hartswf0/centaur-walker/templates.pdf

# 0 Check and index

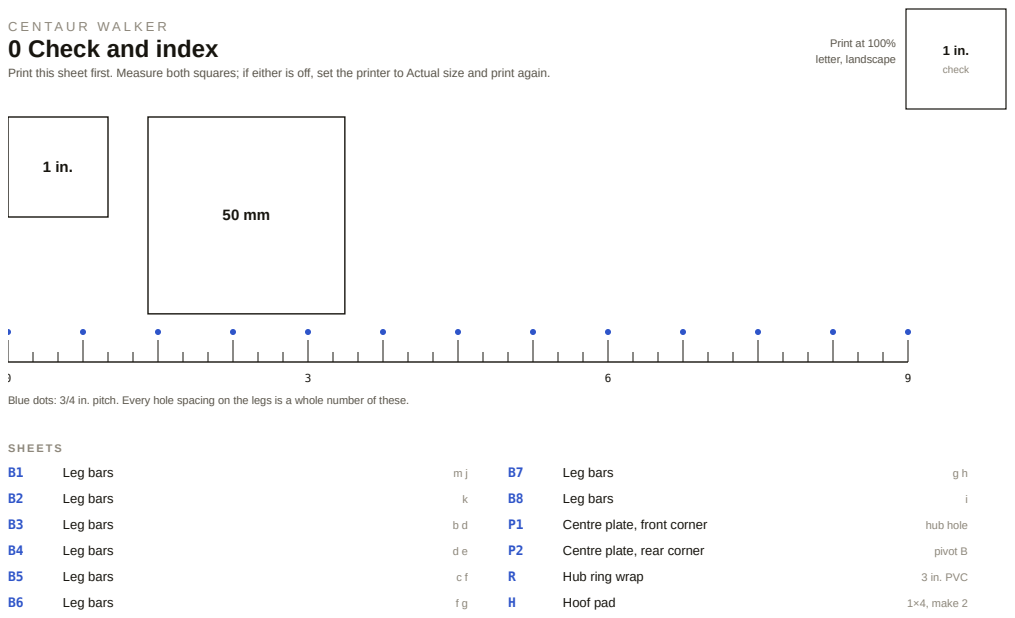
[picture p2: page 1]
check; Print at 100% letter, landscape; Leg bars; Centre plate, front corner; hub hole; Centre plate, rear corner; pivot B; Hub ring wrap; 3 in. PVC; Hoof pad; 1×4, make 2

Print this sheet first. Measure both squares; if either is off, set the printer to Actual size and print again.

Blue dots: 3/4 in. pitch. Every hole spacing on the legs is a whole number of these.

C E N TA U R W A L K E R

# B1 Leg bars

Tape each strip to a 1×2 so its long edges sit on the bar’s edges. Punch through each cross. Cut on the solid end lines.

1 in.

check

Print at 100%
letter, landscape

m Crank · cut 6-9/16 in. · holes 3-3/4 in. apart (95 mm) to C; hub holes 2-5/8 in. apart · make 2

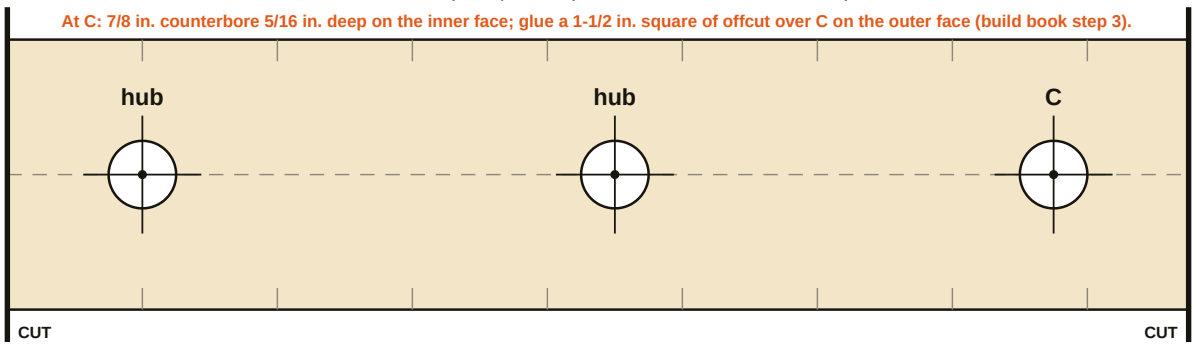
[picture p3: figure]
CUT; hub

At C: 7/8 in. counterbore 5/16 in. deep on the inner face; glue a 1-1/2 in. square of offcut over C on the outer face (build book step 3).

j Upper rod · cut 15 in. · holes 13-1/2 in. apart (343 mm) · make 2 | part 1 of 2

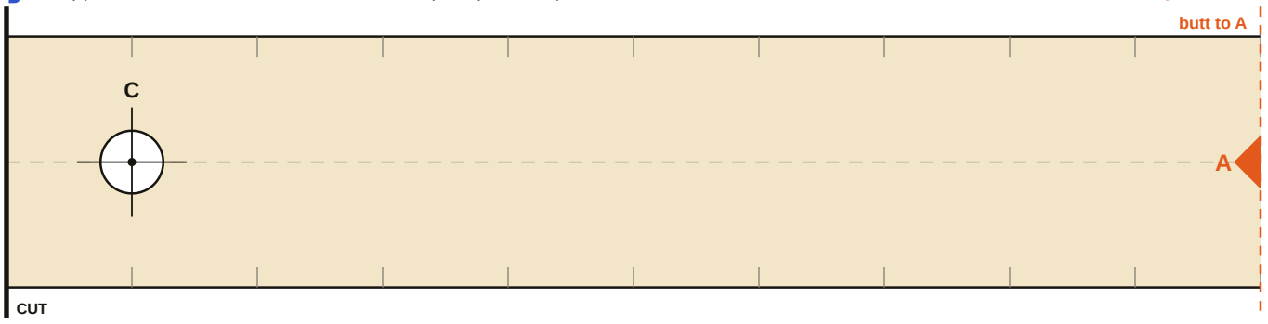
[picture p4: figure]
CUT; butt to A

j Upper rod · cut 15 in. · holes 13-1/2 in. apart (343 mm) · make 2 | part 2 of 2

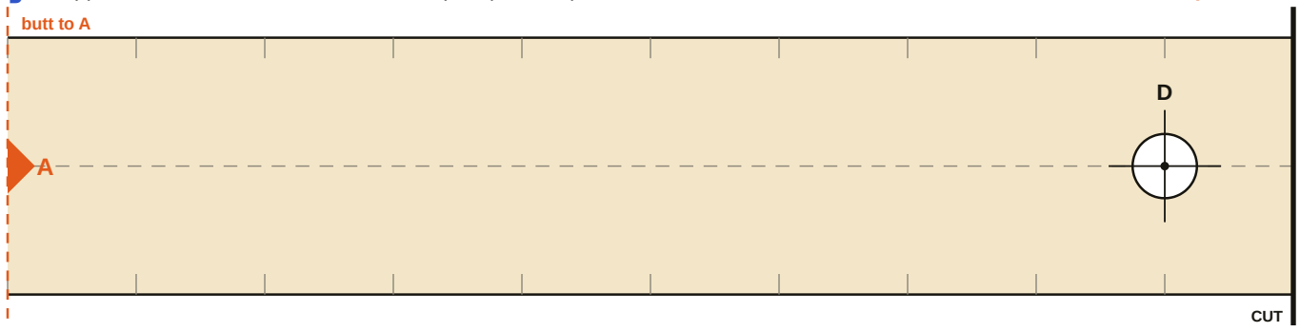
[picture p5: figure]
butt to A; CUT

C E N TA U R W A L K E R

# B2 Leg bars

Tape each strip to a 1×2 so its long edges sit on the bar’s edges. Punch through each cross. Cut on the solid end lines.

1 in.

check

Print at 100%
letter, landscape
k Lower rod · cut 22-1/2 in. · holes 21 in. apart (533 mm) · make 2 | part 1 of 3

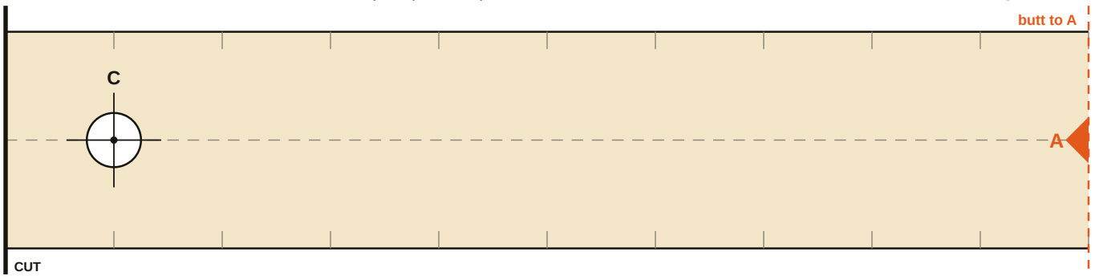
[picture p6: figure]
CUT; butt to A

k Lower rod · cut 22-1/2 in. · holes 21 in. apart (533 mm) · make 2 | part 2 of 3

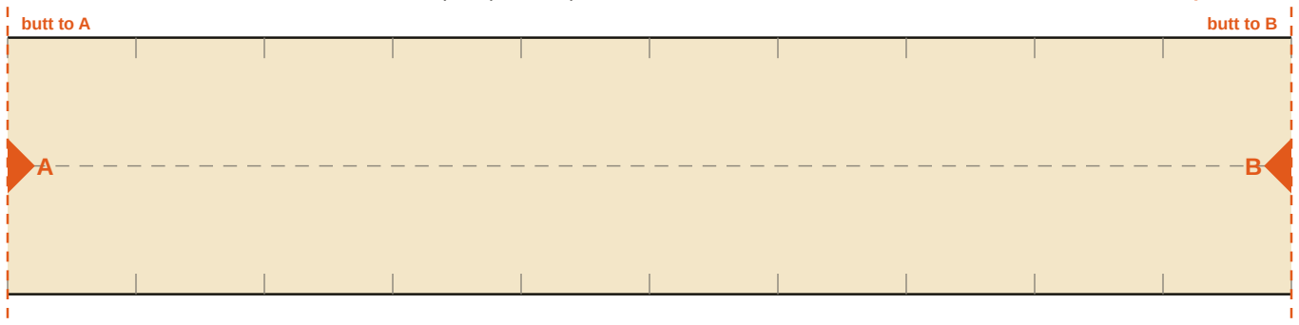
[picture p7: figure]
butt to A; butt to B

k Lower rod · cut 22-1/2 in. · holes 21 in. apart (533 mm) · make 2 | part 3 of 3

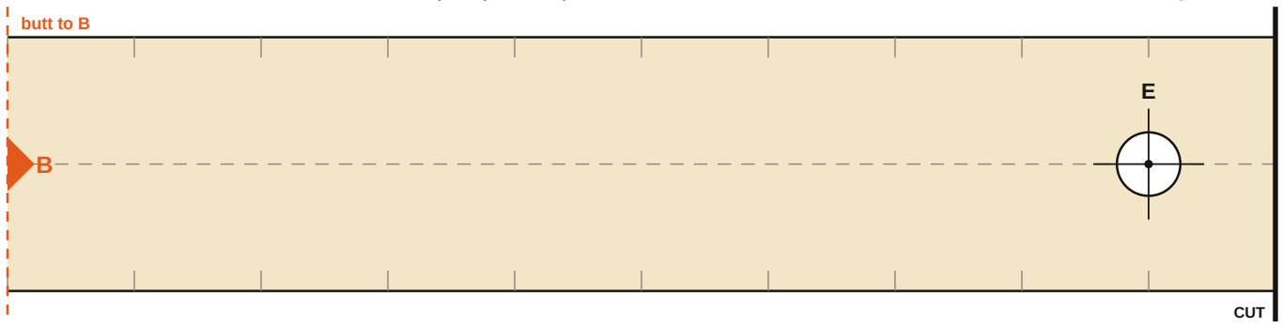
[picture p8: figure]
butt to B

C E N TA U R W A L K E R

# B3 Leg bars

Tape each strip to a 1×2 so its long edges sit on the bar’s edges. Punch through each cross. Cut on the solid end lines.

1 in.

check

Print at 100%
letter, landscape
b Hip bar, front · cut 11-1/4 in. · holes 9-3/4 in. apart (248 mm) · make 2 | part 1 of 2

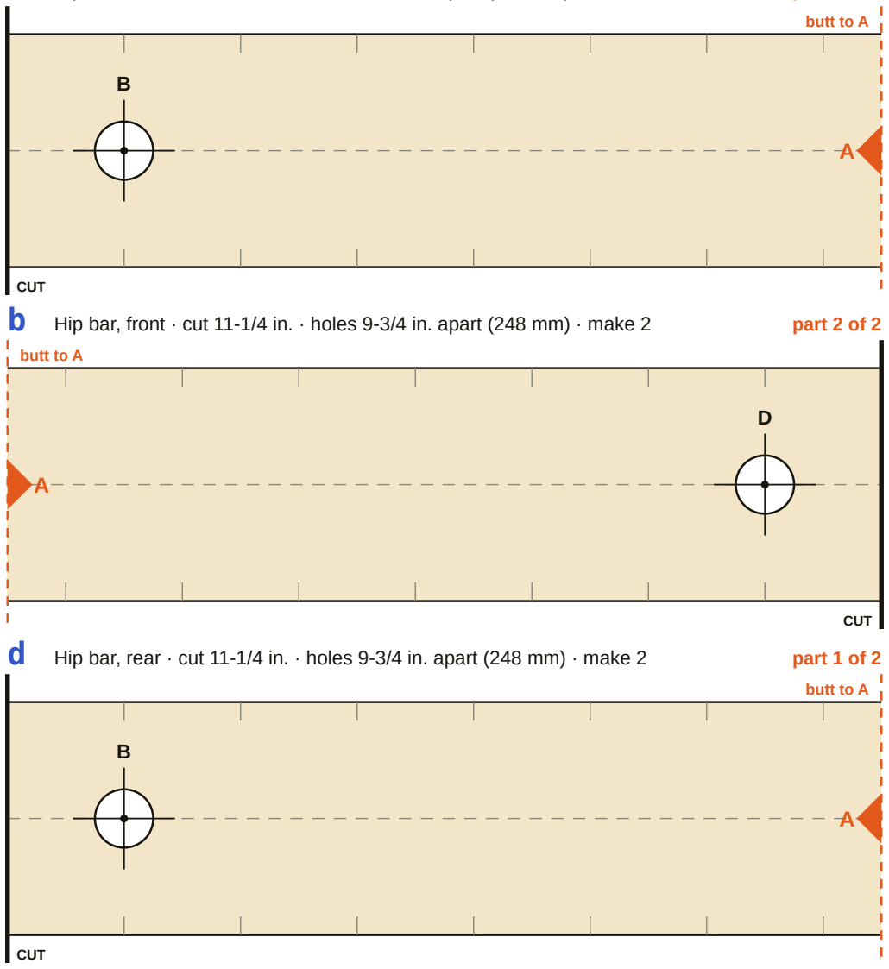
[picture p9: figure]
CUT; butt to A

b Hip bar, front · cut 11-1/4 in. · holes 9-3/4 in. apart (248 mm) · make 2 | part 2 of 2
d Hip bar, rear · cut 11-1/4 in. · holes 9-3/4 in. apart (248 mm) · make 2 | part 1 of 2

C E N TA U R W A L K E R

# B4 Leg bars

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

1 in.

check

Print at 100%
letter, landscape
d Hip bar, rear · cut 11-1/4 in. · holes 9-3/4 in. apart (248 mm) · make 2 | part 2 of 2

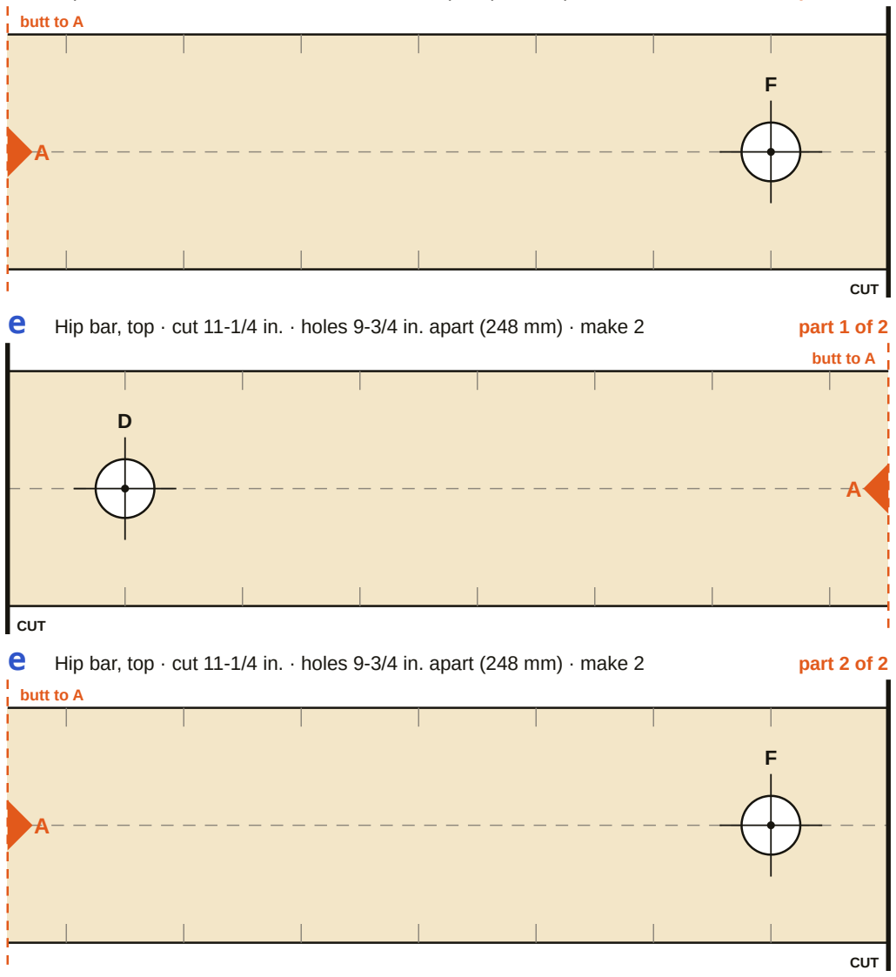
[picture p10: figure]
butt to A; CUT

e Hip bar, top · cut 11-1/4 in. · holes 9-3/4 in. apart (248 mm) · make 2 | part 1 of 2
e Hip bar, top · cut 11-1/4 in. · holes 9-3/4 in. apart (248 mm) · make 2 | part 2 of 2

C E N TA U R W A L K E R

# B5 Leg bars

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

1 in.

check

Print at 100%
letter, landscape
c Thigh rod · cut 15 in. · holes 13-1/2 in. apart (343 mm) · make 2 | part 1 of 2

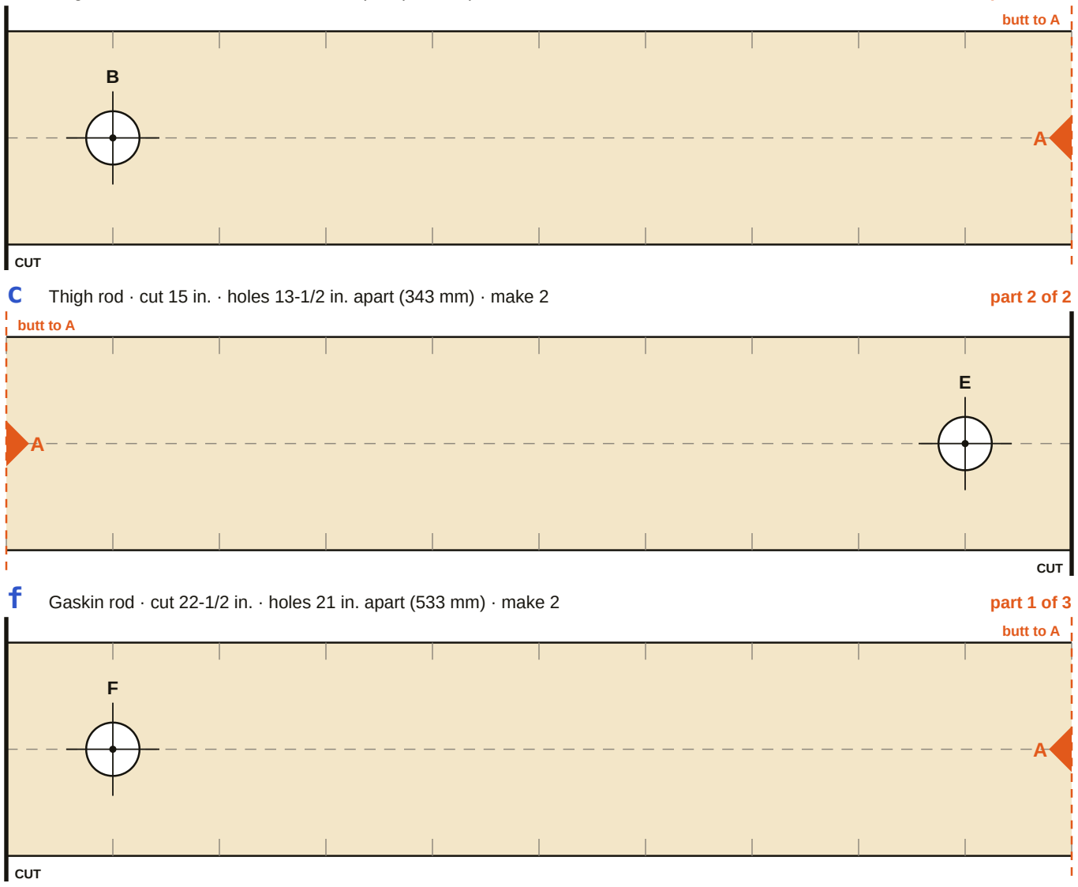
[picture p11: figure]
CUT; butt to A

c Thigh rod · cut 15 in. · holes 13-1/2 in. apart (343 mm) · make 2 | part 2 of 2
f Gaskin rod · cut 22-1/2 in. · holes 21 in. apart (533 mm) · make 2 | part 1 of 3

C E N TA U R W A L K E R

# B6 Leg bars

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

1 in.

check

Print at 100%
letter, landscape
f Gaskin rod · cut 22-1/2 in. · holes 21 in. apart (533 mm) · make 2 | part 2 of 3

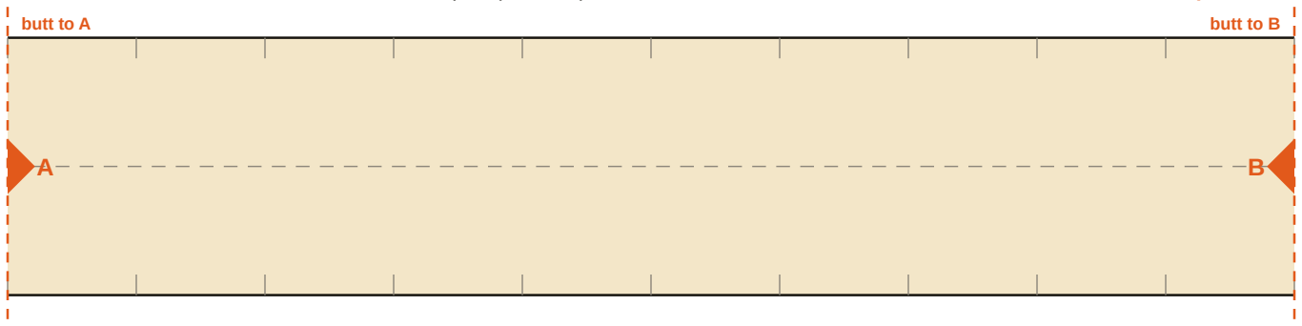
[picture p12: figure]
butt to A; butt to B

f Gaskin rod · cut 22-1/2 in. · holes 21 in. apart (533 mm) · make 2 | part 3 of 3

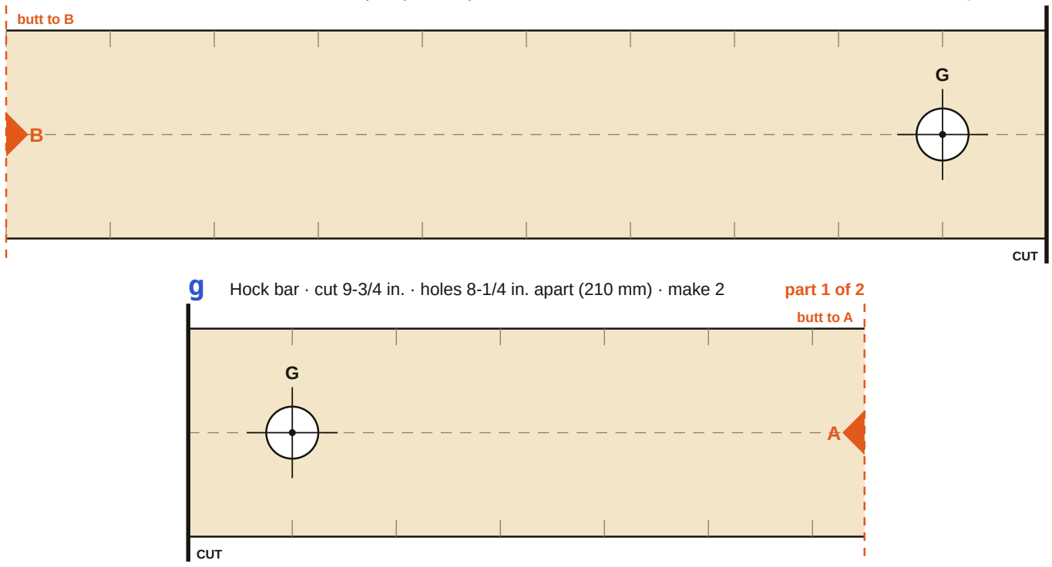
[picture p13: figure]
butt to B; CUT; butt to A

g Hock bar · cut 9-3/4 in. · holes 8-1/4 in. apart (210 mm) · make 2 | part 1 of 2

C E N TA U R W A L K E R

# B7 Leg bars

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

1 in.

check

Print at 100%
letter, landscape
g Hock bar · cut 9-3/4 in. · holes 8-1/4 in. apart (210 mm) · make 2 | part 2 of 2

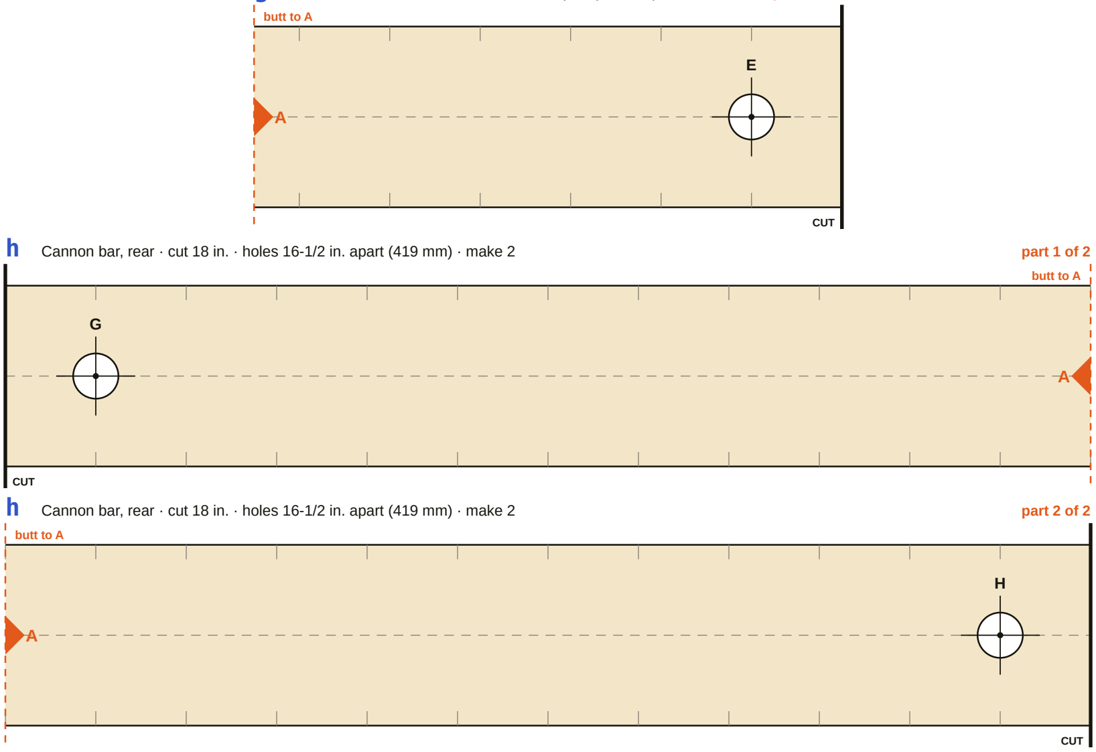
[picture p14: figure]
butt to A; CUT

h Cannon bar, rear · cut 18 in. · holes 16-1/2 in. apart (419 mm) · make 2 | part 1 of 2
h Cannon bar, rear · cut 18 in. · holes 16-1/2 in. apart (419 mm) · make 2 | part 2 of 2

# B8 Leg bars

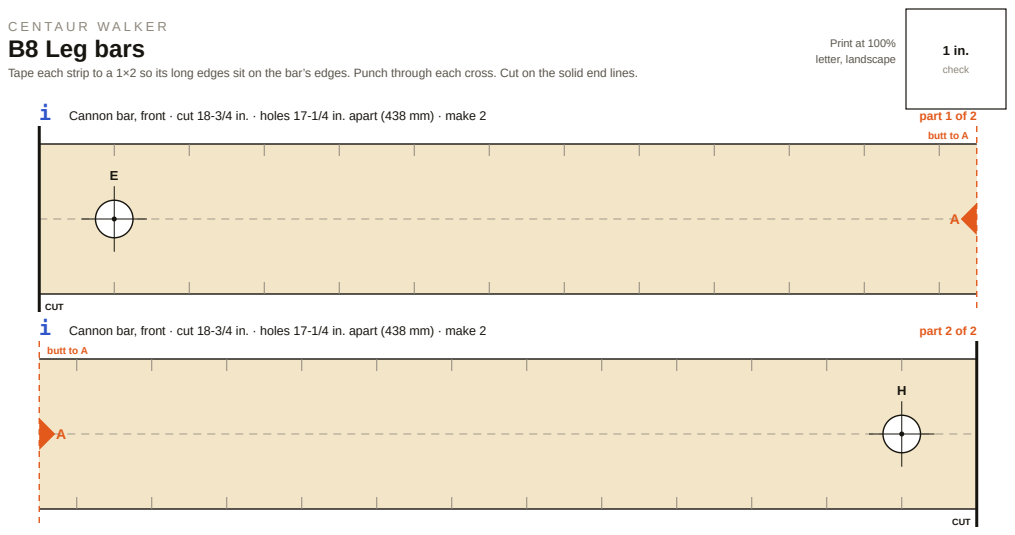
[picture p15: page 9]
check; Print at 100% letter, landscape; i Cannon bar, front · cut 18-3/4 in. · holes 17-1/4 in. apart (438 mm) · make 2; part 1 of 2; CUT; butt to A; part 2 of 2

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

# P1 Centre plate, front corner

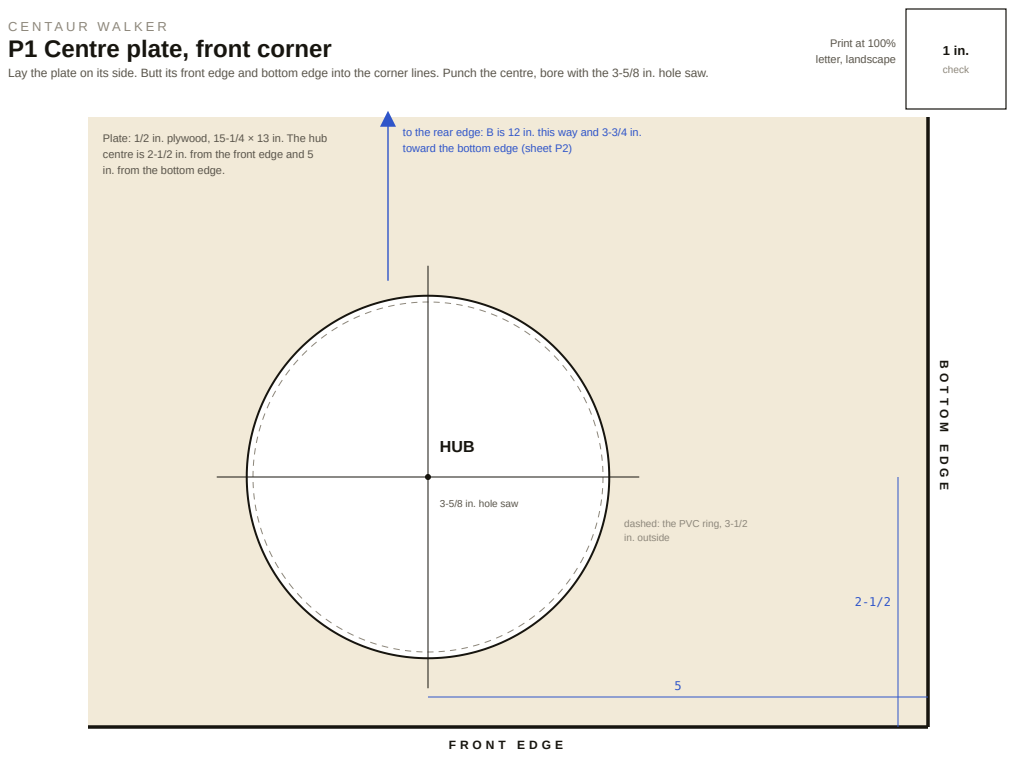
[picture p16: page 10]
check; Print at 100% letter, landscape; HUB

Lay the plate on its side. Butt its front edge and bottom edge into the corner lines. Punch the centre, bore with the 3-5/8 in. hole saw.

to the rear edge: B is 12 in. this way and 3-3/4 in.
toward the bottom edge (sheet P2)

Plate: 1/2 in. plywood, 15-1/4 × 13 in. The hub
centre is 2-1/2 in. from the front edge and 5
in. from the bottom edge.

3-5/8 in. hole saw

dashed: the PVC ring, 3-1/2
in. outside

# P2 Centre plate, rear corner

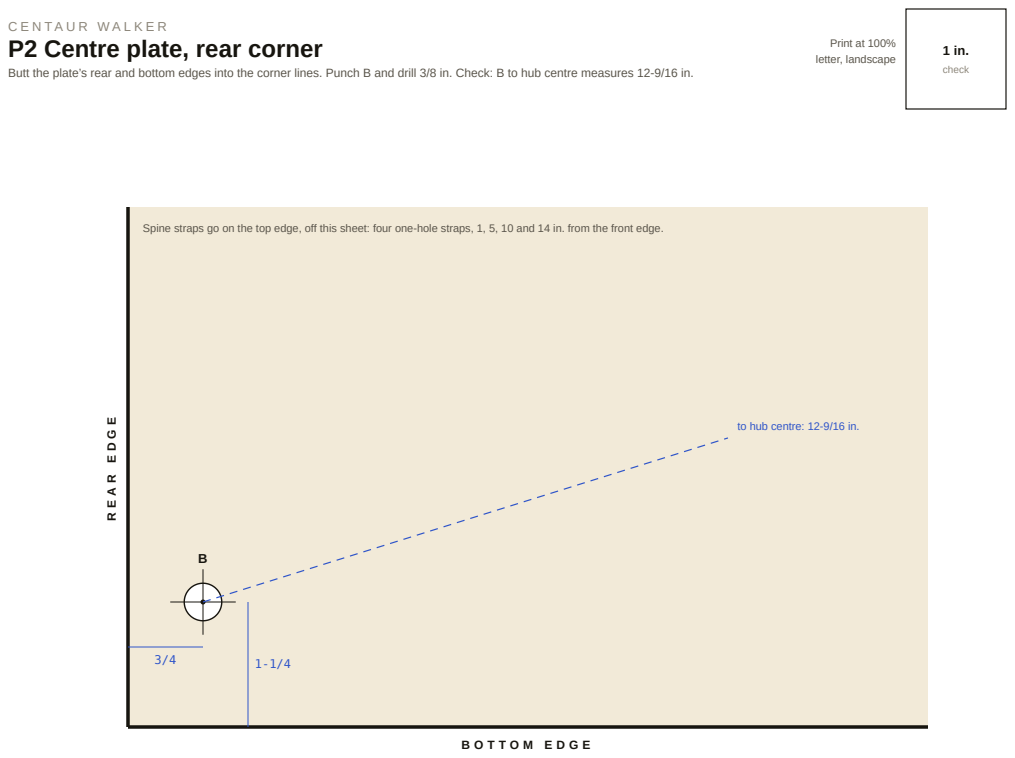
[picture p17: page 11]
check; Print at 100% letter, landscape

Butt the plate’s rear and bottom edges into the corner lines. Punch B and drill 3/8 in. Check: B to hub centre measures 12-9/16 in.

Spine straps go on the top edge, off this sheet: four one-hole straps, 1, 5, 10 and 14 in. from the front edge.

to hub centre: 12-9/16 in.

C E N TA U R W A L K E R

# R Hub ring wrap

Cut out both bands, tape them end to end at A, and wrap the 3 in. PVC pipe so the end meets the start. Saw on the outside of each line, keeping the cut square.

1 in.

check

Print at 100%
letter, landscape

saw outside this line

saw outside this line

ring: cut 5/8 in. — part 1 | A

START

saw outside this line

saw outside this line

A ring: cut 5/8 in. — part 2

END meets START

Band length 11 in. = the outside of 3 in. PVC (3-1/2 in. across). Cut the ring 5/8 in., then sand it to 19/32 in.: the plywood (actual 15/32 in.) plus two nylon washers. The cranks clamp the ring, never the plate.

C E N TA U R W A L K E R

# H Hoof pad, full size from above

Cut 4 in. of 1×4. Lay this on top. The inner edge goes toward the centre plate. Brace feet point outward.

1 in.

check

Print at 100%
letter, landscape

INNER EDGE — line up with the inner face of the front cannon bar

OUTER EDGE

FRONT | REAR

Dashed box: the two cannon bars and their washer above, 1-9/16 in. thick.

H

inner brace

outer brace

brace overhangs 1/8 in.

4 in.

3-1/2 in.

Each brace screws to the outside face of one cannon bar, 5/8 in. off H so it clears the nut. Mark the pad through the foot holes; drive #8 × 5/8 in. screws so none come through the rubber. Glue rubber from a floor protector pad to the underside. Hoof weight with braces and rubber: about 90 g.
