hartswf0/centaur-walker/thumbs/01-leg-rig-v1.jpg

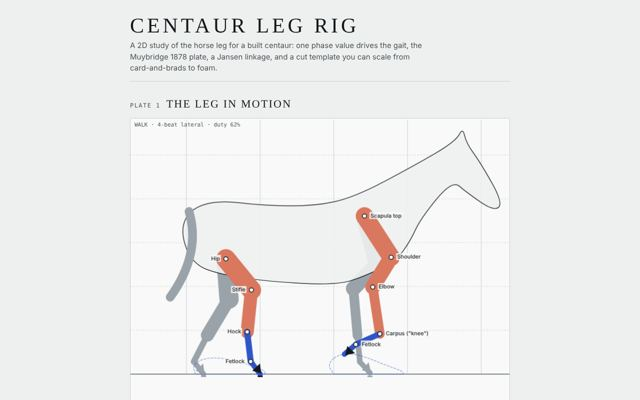
thumbs/01-leg-rig-v1.jpg
