hartswf0/centaur-walker/thumbs/02-leg-rig-v3.jpg

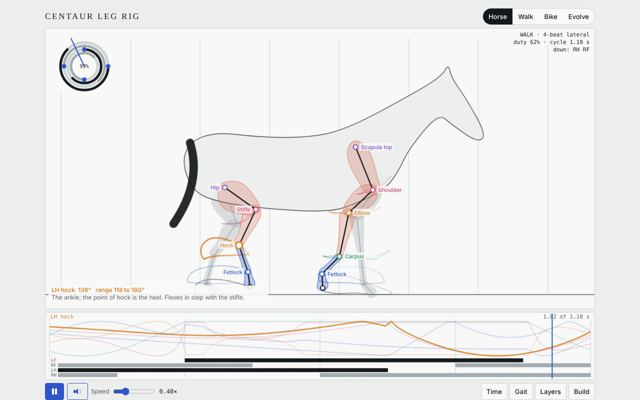
thumbs/02-leg-rig-v3.jpg
