hartswf0/centaur-walker/thumbs/03-workshop-v1.jpg

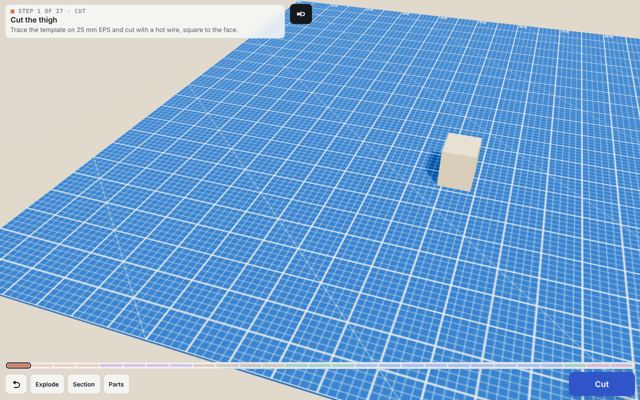
thumbs/03-workshop-v1.jpg
