hartswf0/centaur-walker/thumbs/04-studio-prompt.jpg

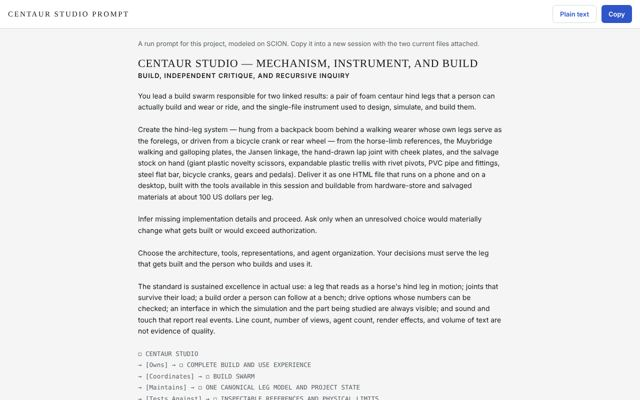
thumbs/04-studio-prompt.jpg
