hartswf0/centaur-walker/thumbs/06-leg-rig-final.jpg

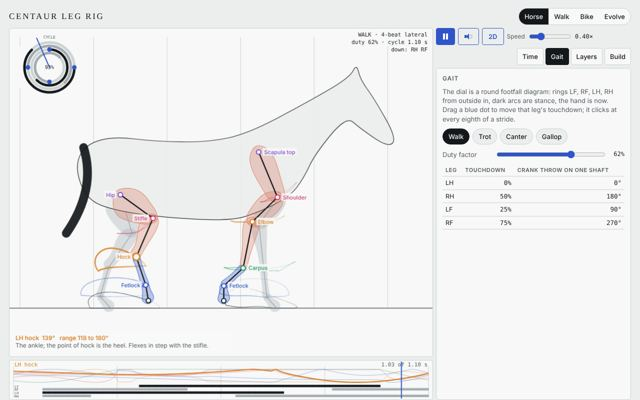
thumbs/06-leg-rig-final.jpg
