hartswf0/centaur-walker/thumbs/07-workshop-final.jpg

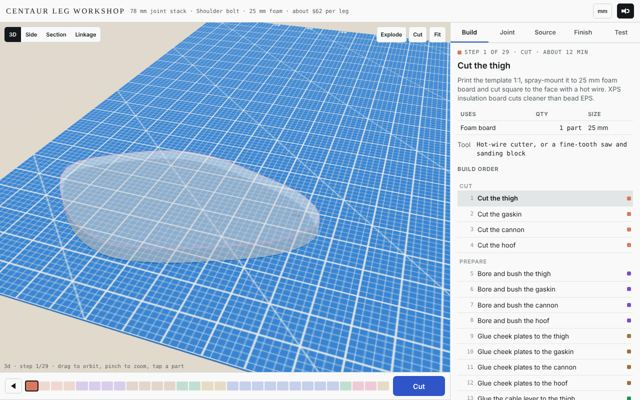
thumbs/07-workshop-final.jpg
