hartswf0/centaur-walker/thumbs/08-studio.jpg

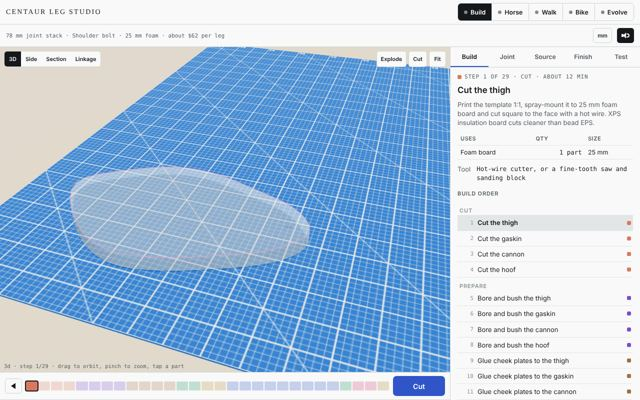
thumbs/08-studio.jpg
