hartswf0/centaur-walker/thumbs/09-velocipede-v1.jpg

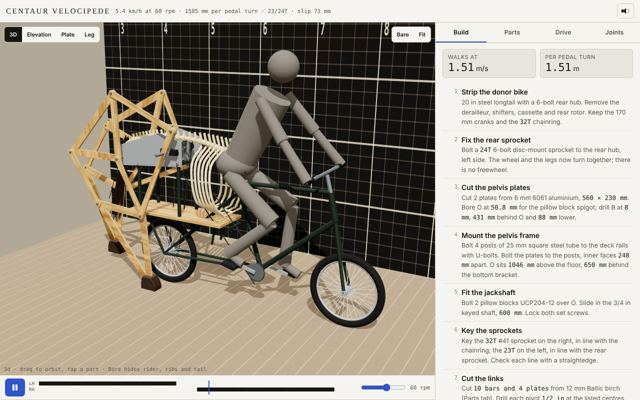
thumbs/09-velocipede-v1.jpg
