hartswf0/centaur-walker/thumbs/11-velocipede-v3.jpg

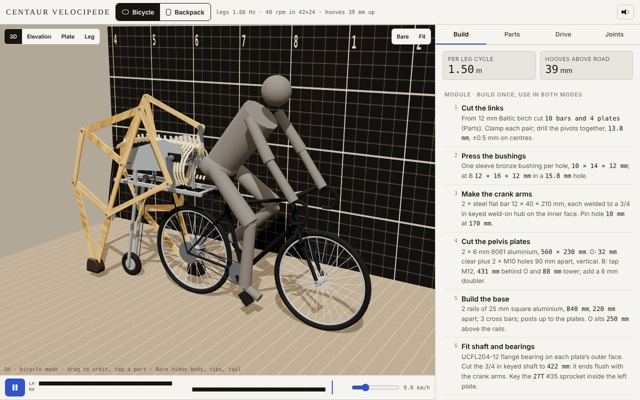
thumbs/11-velocipede-v3.jpg
