hartswf0/centaur-walker/thumbs/15-walker-v1.jpg

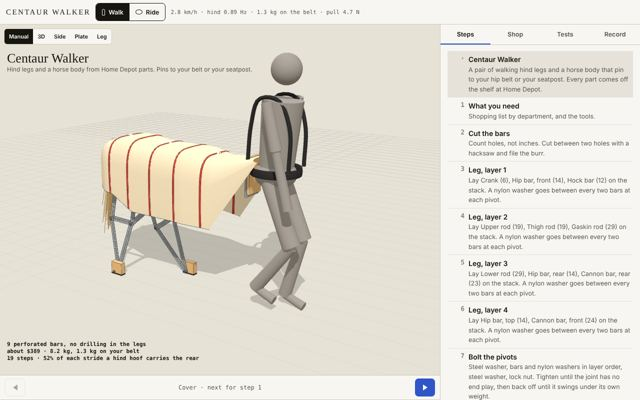
thumbs/15-walker-v1.jpg
