hartswf0/centaur-walker/thumbs/17-walker-v2a.jpg

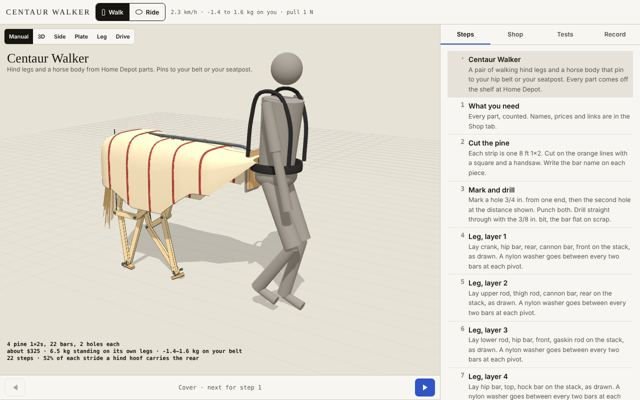
thumbs/17-walker-v2a.jpg
