hartswf0/centaur-walker/thumbs/21-stride-plate.jpg

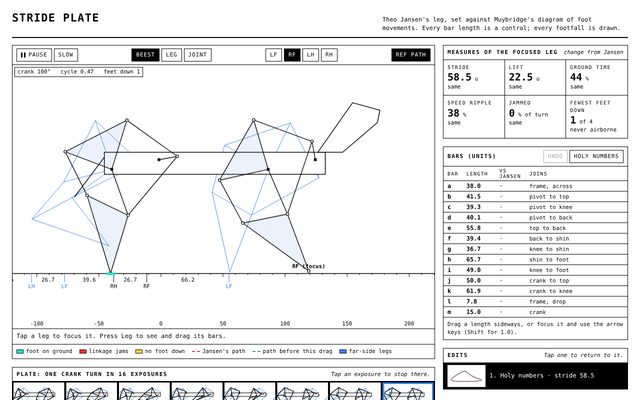
thumbs/21-stride-plate.jpg
