hartswf0/centaur-walker/thumbs/22-centaur-rig-v1.jpg

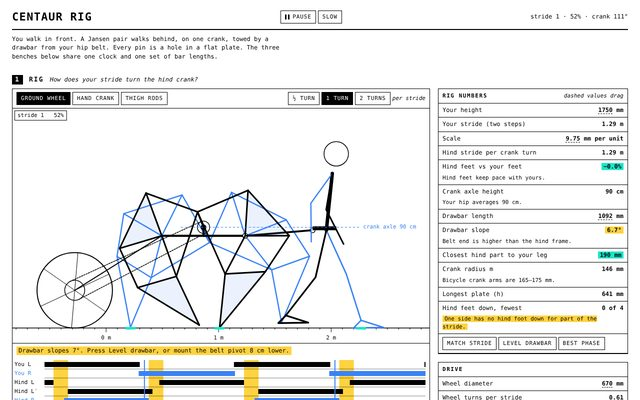
thumbs/22-centaur-rig-v1.jpg
