hartswf0/centaur-walker/thumbs/23-centaur-rig-v2.jpg

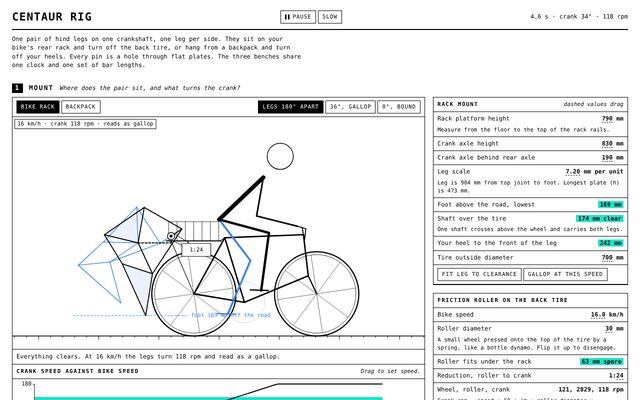
thumbs/23-centaur-rig-v2.jpg
