hartswf0/centaur-walker/thumbs/24-centaur-rig-v3.jpg

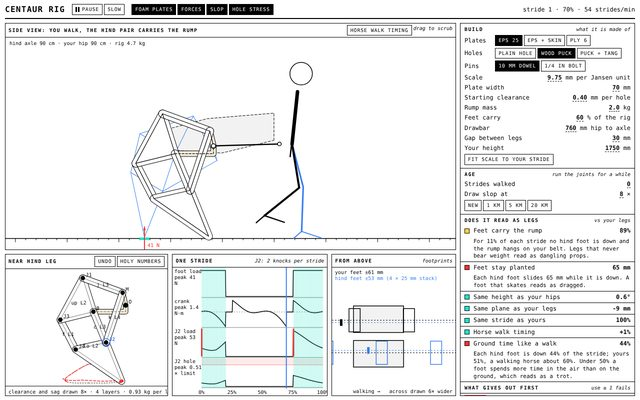
thumbs/24-centaur-rig-v3.jpg
