hartswf0/centaur-walker/thumbs/25-centaur-rig-v4.jpg

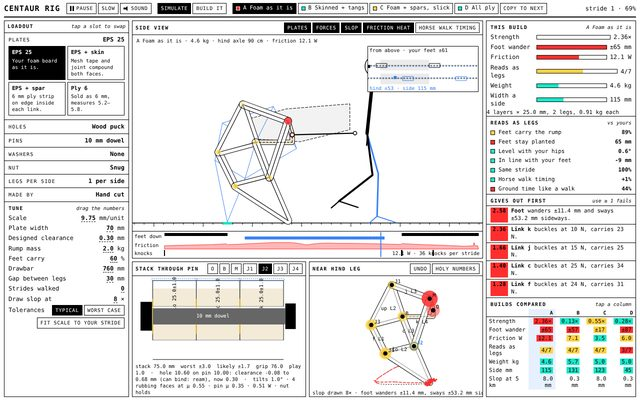
thumbs/25-centaur-rig-v4.jpg
