hartswf0/centaur-walker/thumbs/26-centaur-rig-v5.jpg

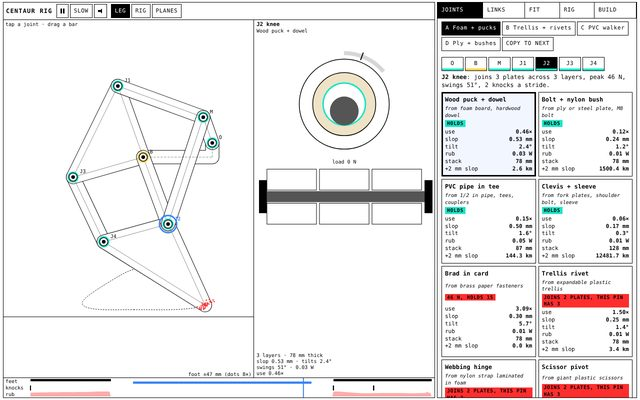
thumbs/26-centaur-rig-v5.jpg
