hartswf0/centaur-walker/thumbs/33-rig3d-v1.jpg

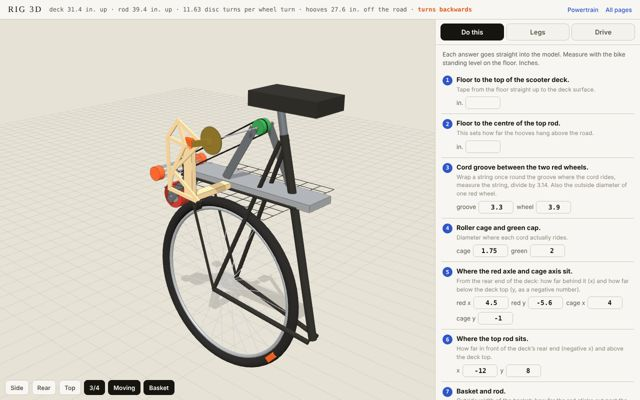
thumbs/33-rig3d-v1.jpg
