hartswf0/centaur-walker/thumbs/34-rig3d-v2.jpg

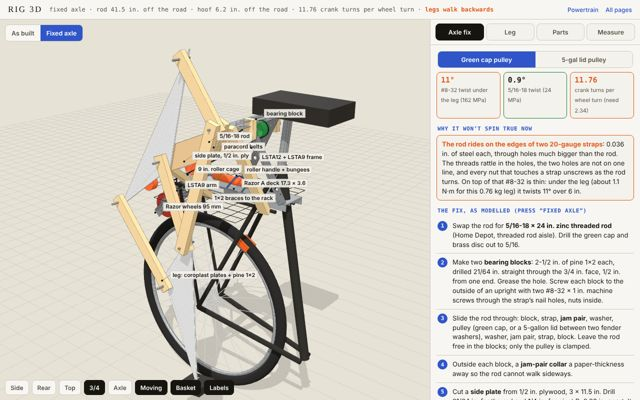
thumbs/34-rig3d-v2.jpg
