hartswf0/centaur-walker/thumbs/35-drive-module-v3.jpg

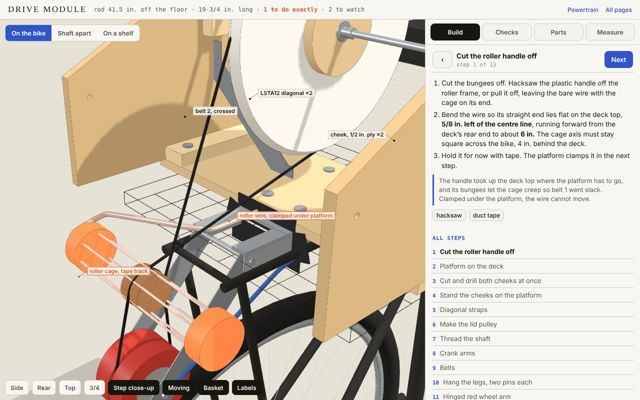
thumbs/35-drive-module-v3.jpg
