hartswf0/centaur-walker/thumbs/36-belt-lab-2d.jpg

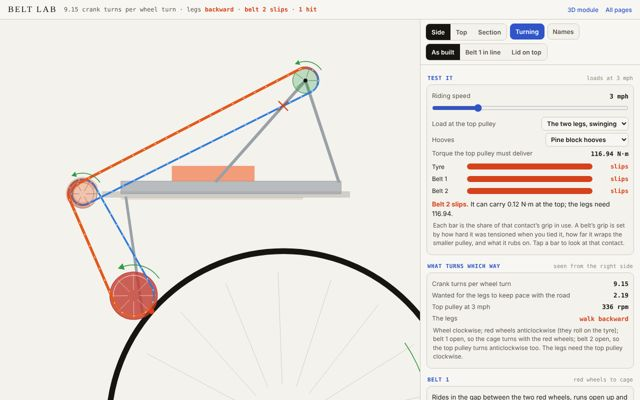
thumbs/36-belt-lab-2d.jpg
