hartswf0/centaur-walker/thumbs/37-velocipede-as-built.jpg

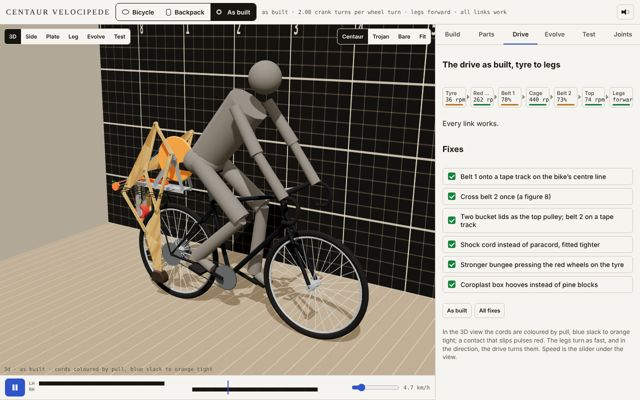
thumbs/37-velocipede-as-built.jpg
