hartswf0/centaur-walker/thumbs/belt.jpg

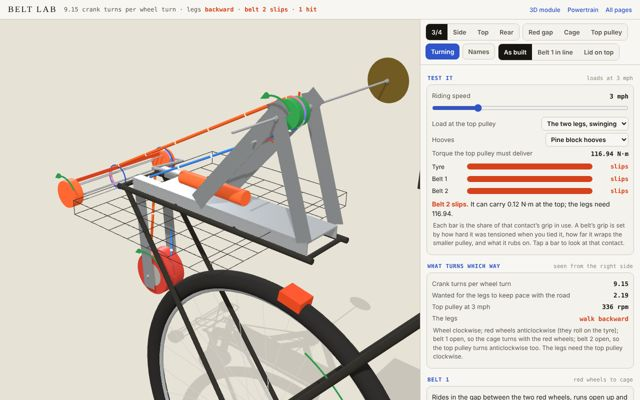
thumbs/belt.jpg
