hartswf0/centaur-walker/thumbs/centaur-rig.jpg

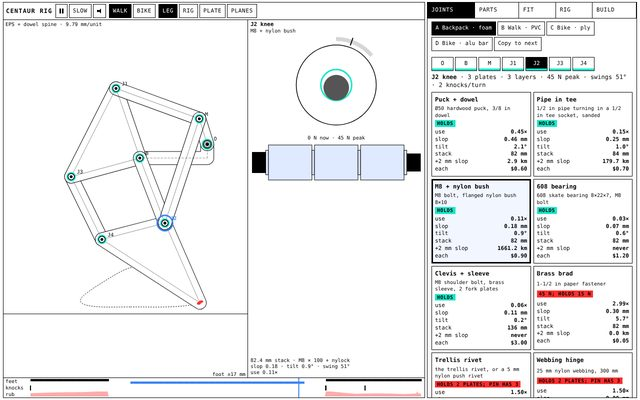
thumbs/centaur-rig.jpg
