hartswf0/centaur-walker/thumbs/design-set.jpg

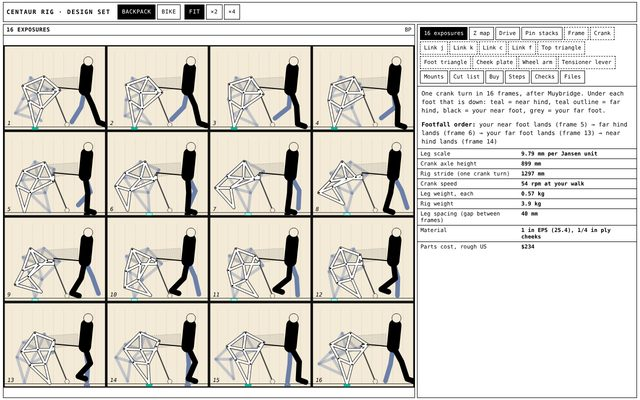
thumbs/design-set.jpg
