hartswf0/centaur-walker/thumbs/powertrain.jpg

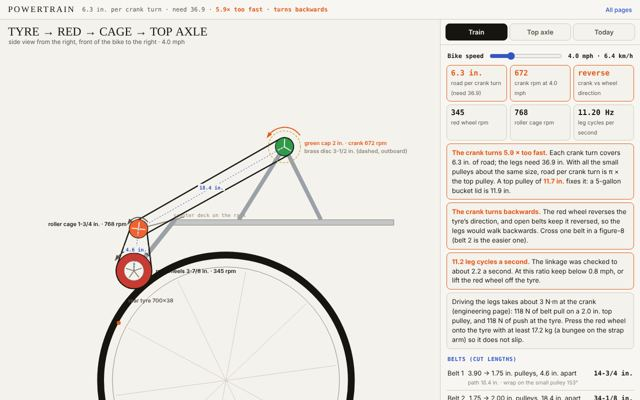
thumbs/powertrain.jpg
