hartswf0/centaur-walker/thumbs/rig3d.jpg

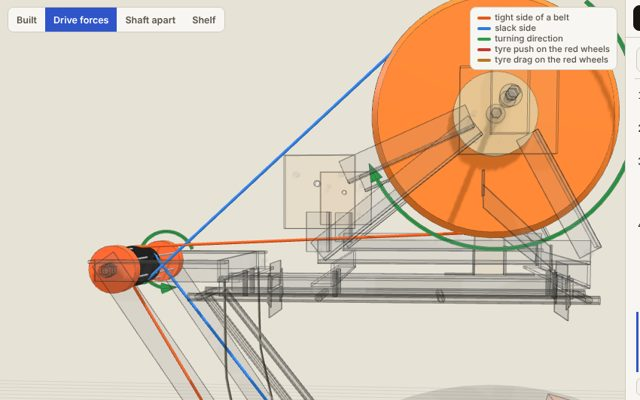
thumbs/rig3d.jpg
