hartswf0/centaur-walker/thumbs/templates.jpg

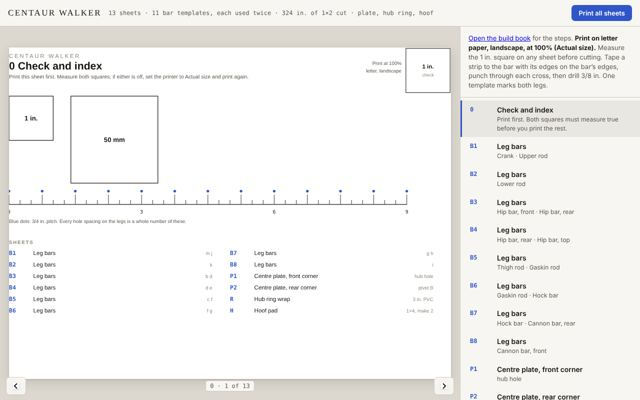
thumbs/templates.jpg
