hartswf0/centaur-walker/thumbs/whole.jpg

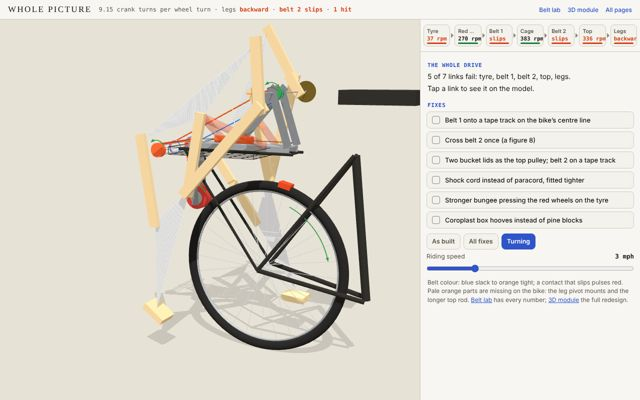
thumbs/whole.jpg
