hartswf0/centaur-walker/rig/files/backpack/BP-parts-tiled-letter.pdf

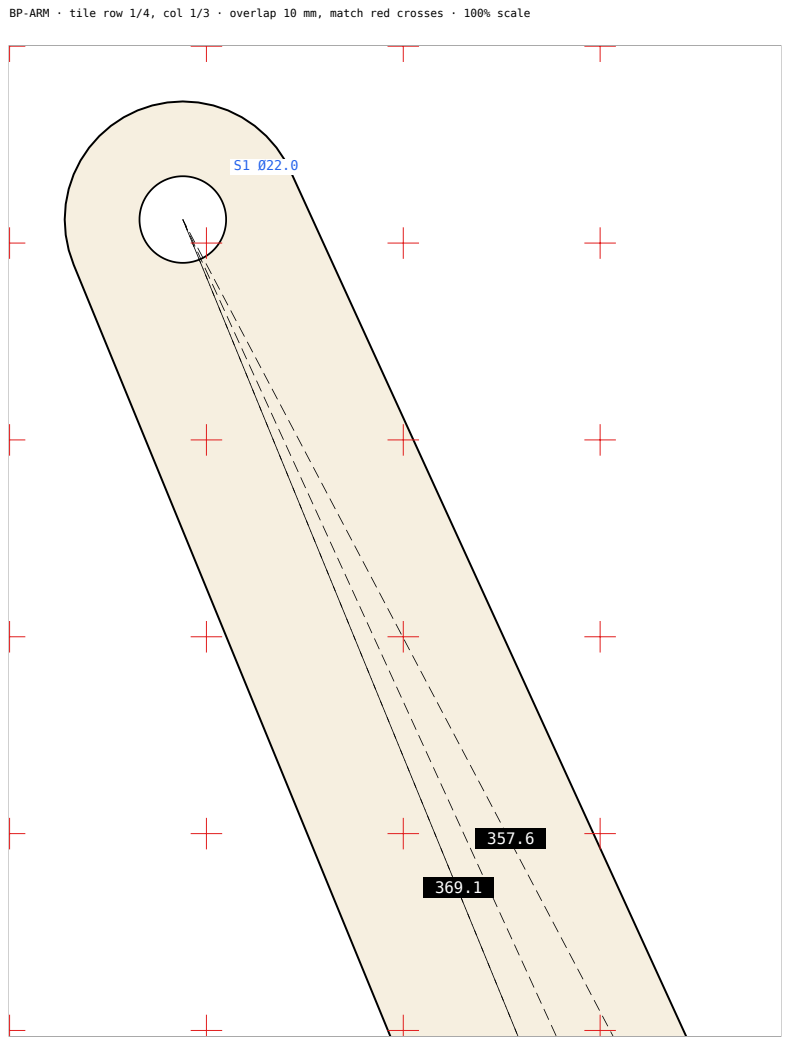
[picture p47: page 1]

BP-ARM · tile row 1/4, col 1/3 · overlap 10 mm, match red crosses · 100% scale

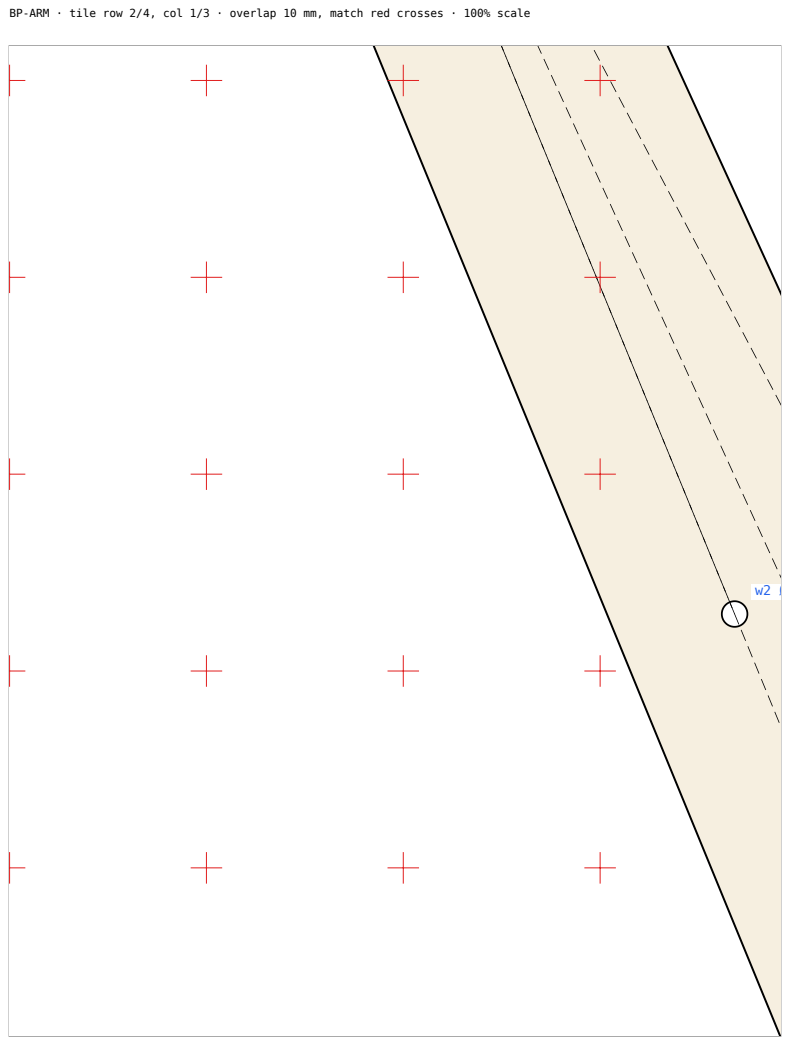
[picture p48: page 2]

BP-ARM · tile row 2/4, col 1/3 · overlap 10 mm, match red crosses · 100% scale

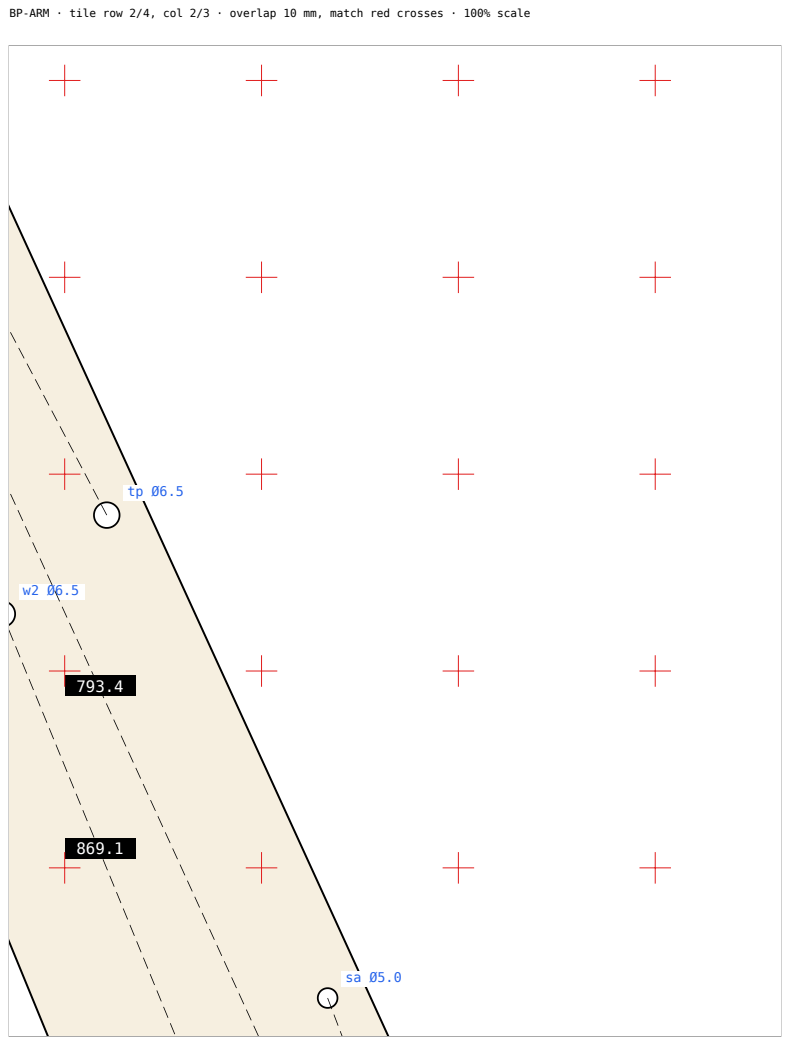
[picture p49: page 3]

BP-ARM · tile row 2/4, col 2/3 · overlap 10 mm, match red crosses · 100% scale

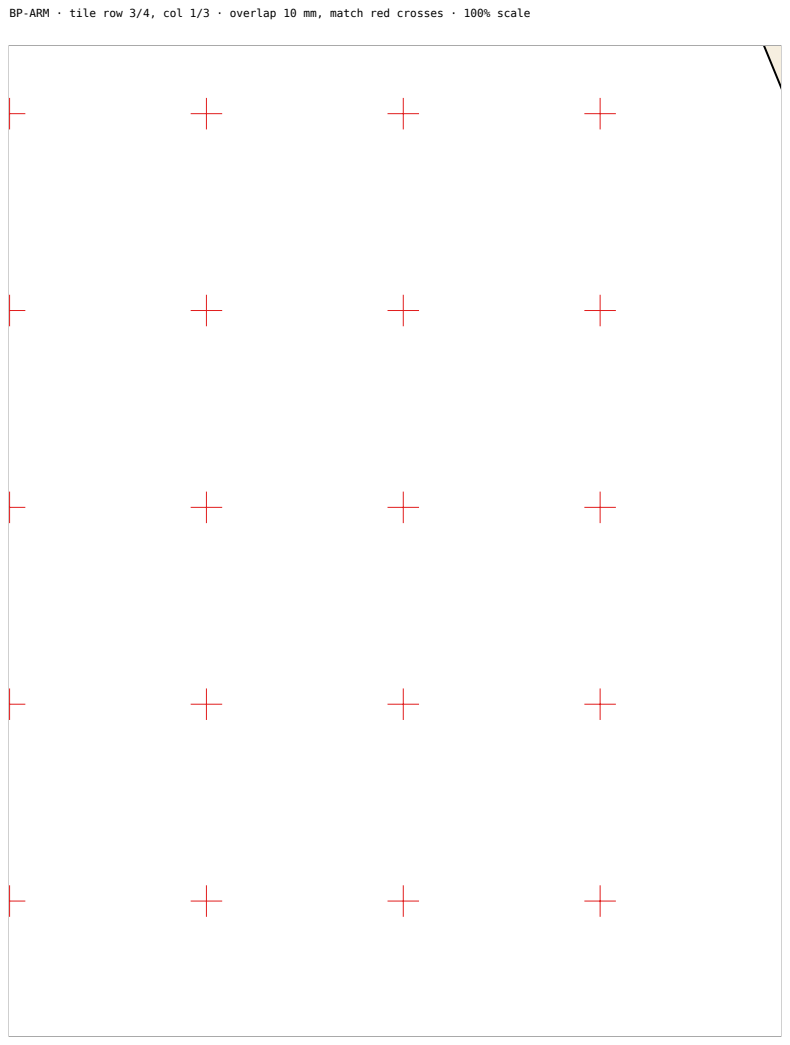
[picture p50: page 4]

BP-ARM · tile row 3/4, col 1/3 · overlap 10 mm, match red crosses · 100% scale

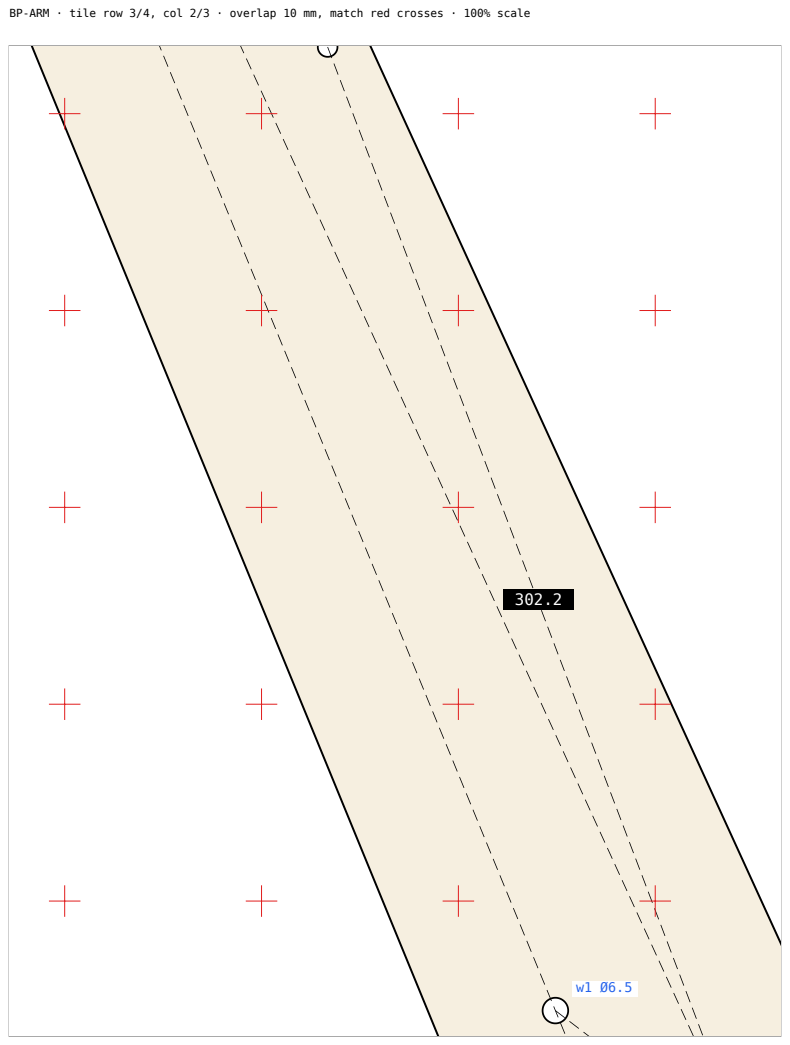
[picture p51: page 5]

BP-ARM · tile row 3/4, col 2/3 · overlap 10 mm, match red crosses · 100% scale

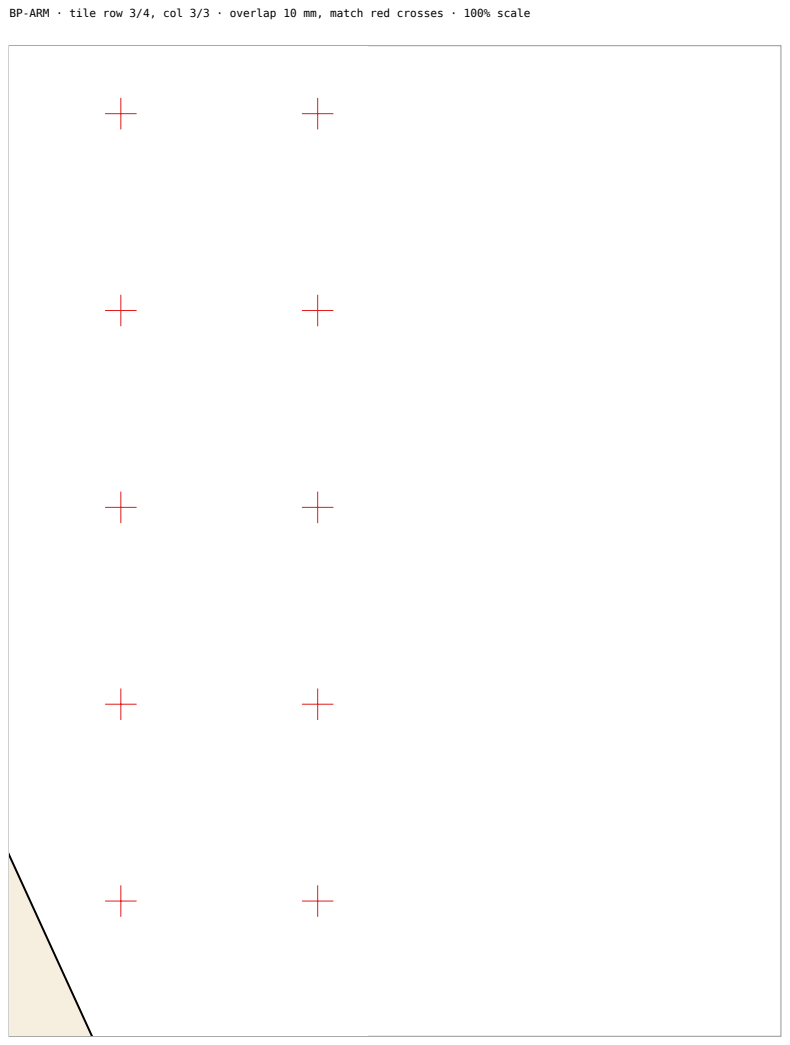
[picture p52: page 6]
BP-ARM · tile row 3/4, col 3/3 · overlap 10 mm, match; red crosses · 100% scale

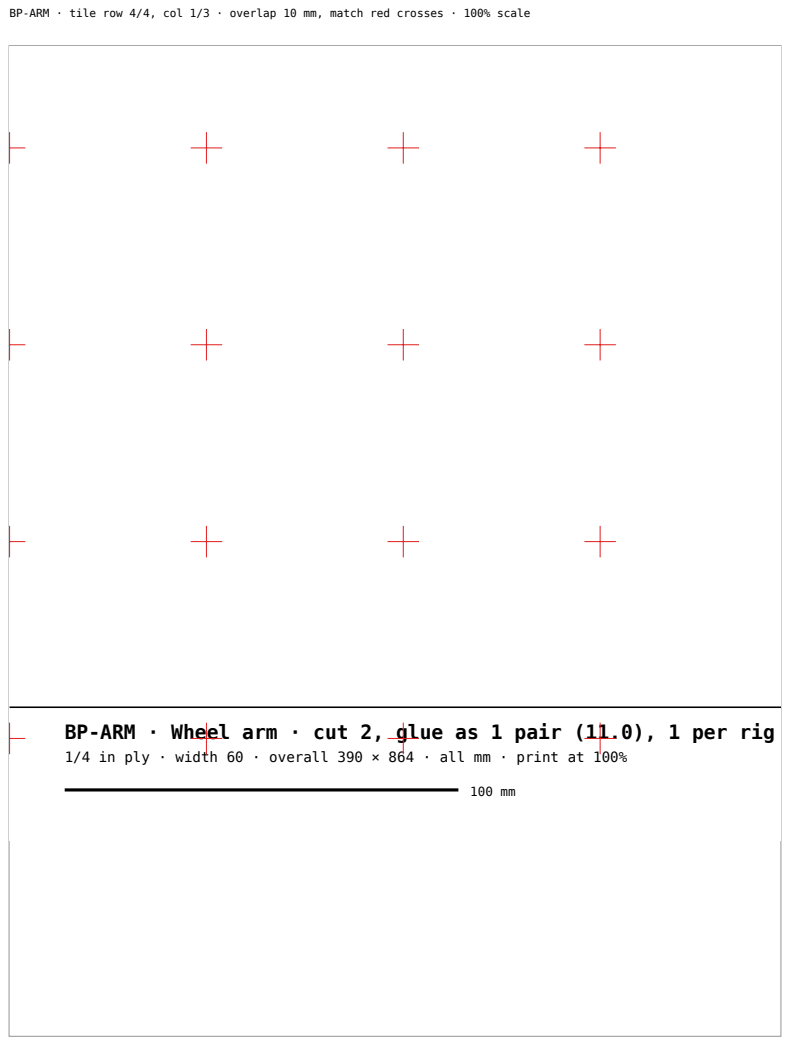
[picture p53: page 7]
BP-ARM · Wheel arm · cut 2,; glue as 1 pair (11.0), 1 per rig

BP-ARM · tile row 4/4, col 1/3 · overlap 10 mm, match red crosses · 100% scale

1/4 in ply · width 60 · overall 390 × 864 · all mm · print at 100%

62.1

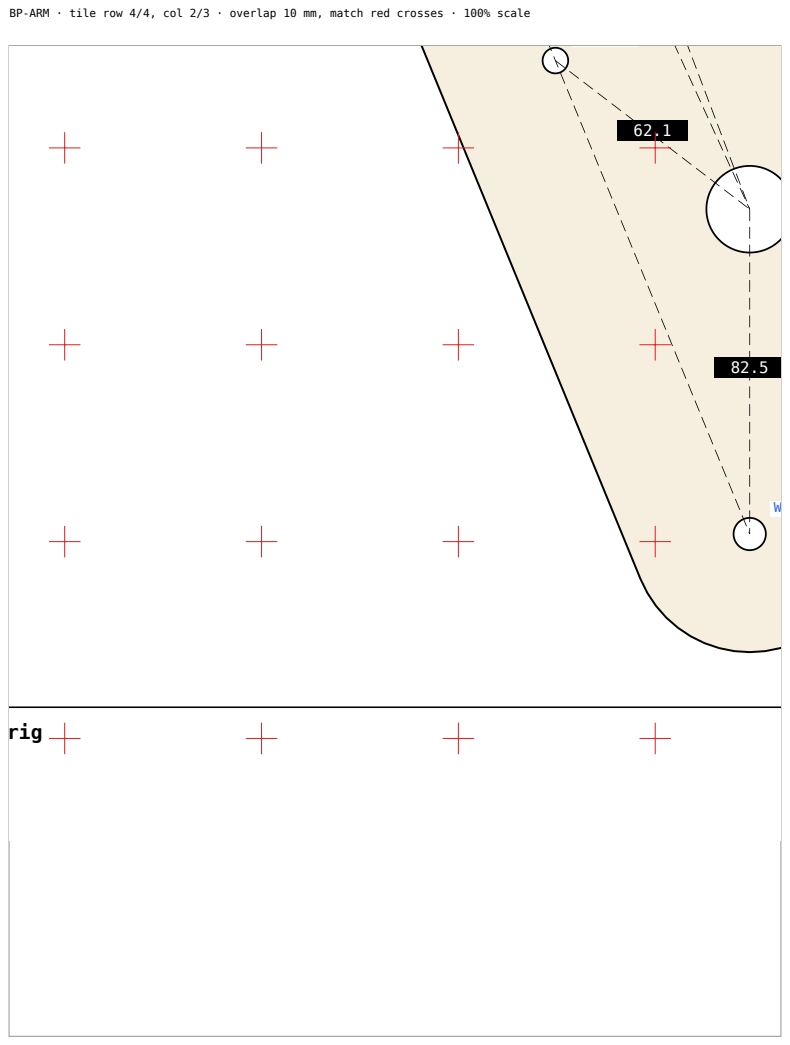
[picture p54: page 8]
rig

BP-ARM · tile row 4/4, col 2/3 · overlap 10 mm, match red crosses · 100% scale

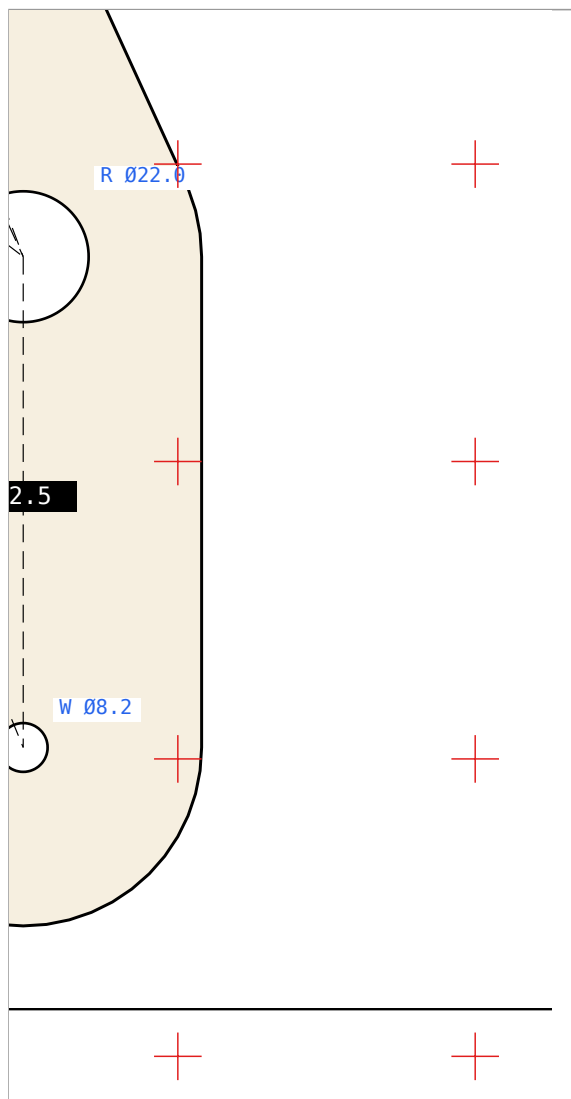
[picture p55: page 9]
BP-ARM · tile row 4/4, col 3/3 · overlap 10 mm, match; red crosses · 100% scale

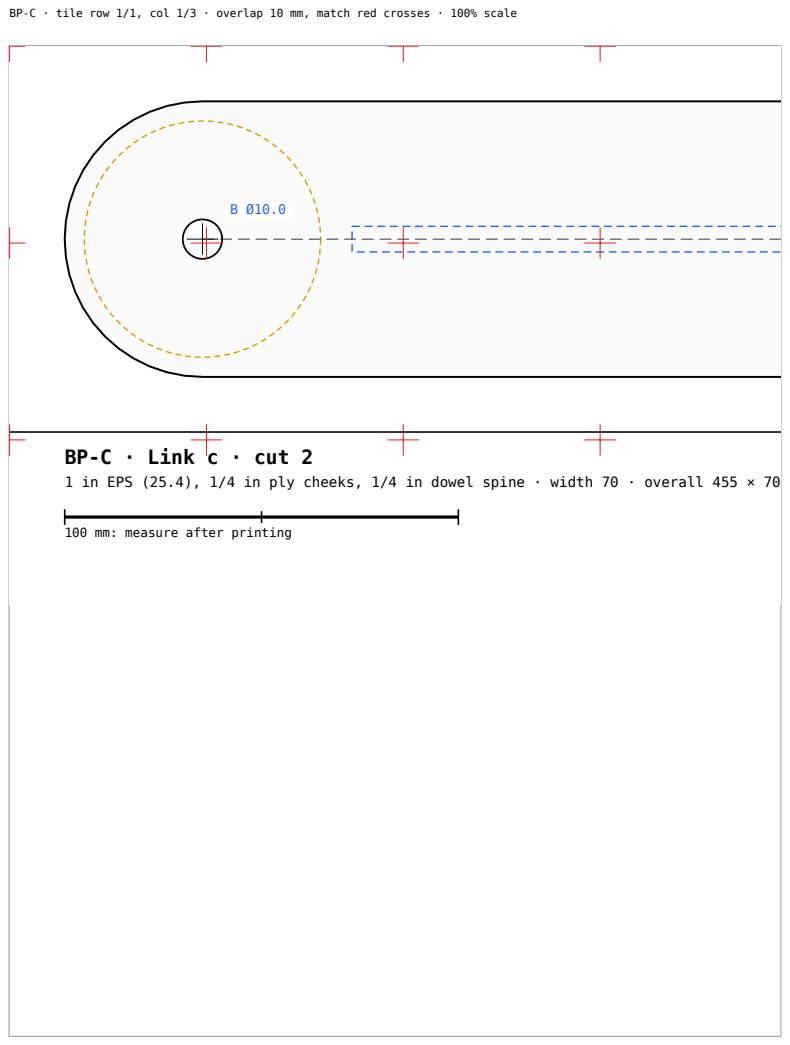
[picture p56: page 10]

BP-C · tile row 1/1, col 1/3 · overlap 10 mm, match red crosses · 100% scale

BP-C · Link c · cut 2
1 in EPS (25.4), 1/4 in ply cheeks, 1/4 in dowel spine · width 70 · overall 455 × 70

100 mm: measure after printing

384.7

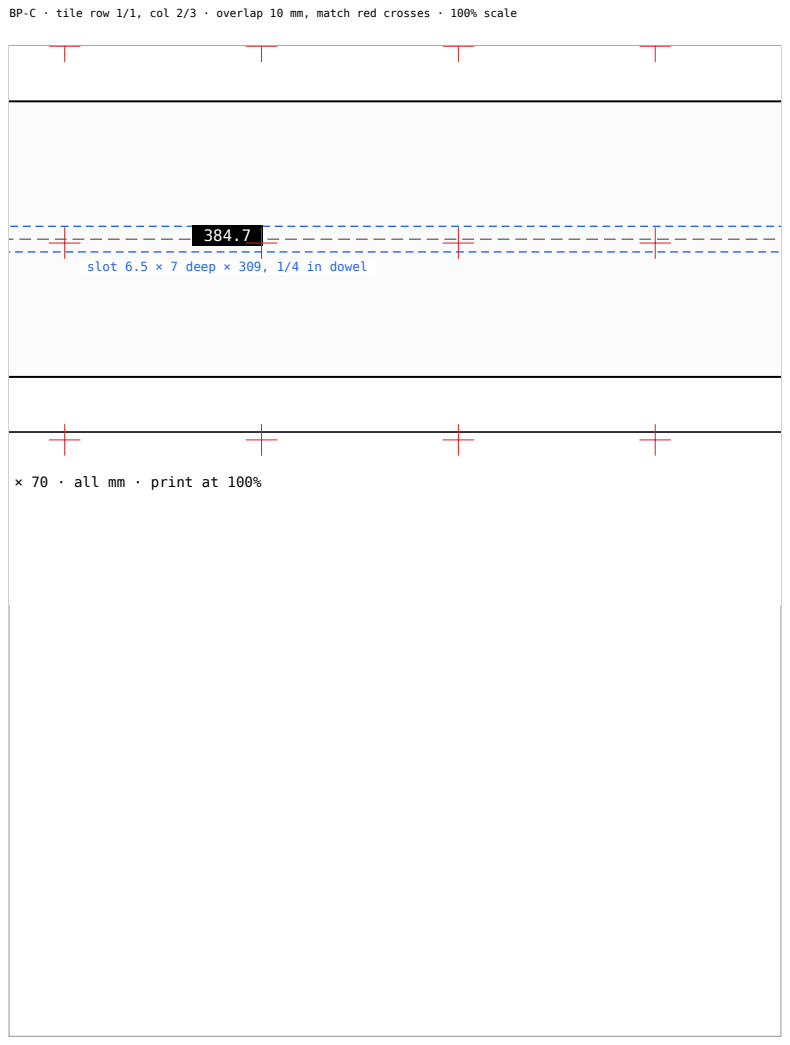
[picture p57: page 11]

BP-C · tile row 1/1, col 2/3 · overlap 10 mm, match red crosses · 100% scale

slot 6.5 × 7 deep × 309, 1/4 in dowel

× 70 · all mm · print at 100%

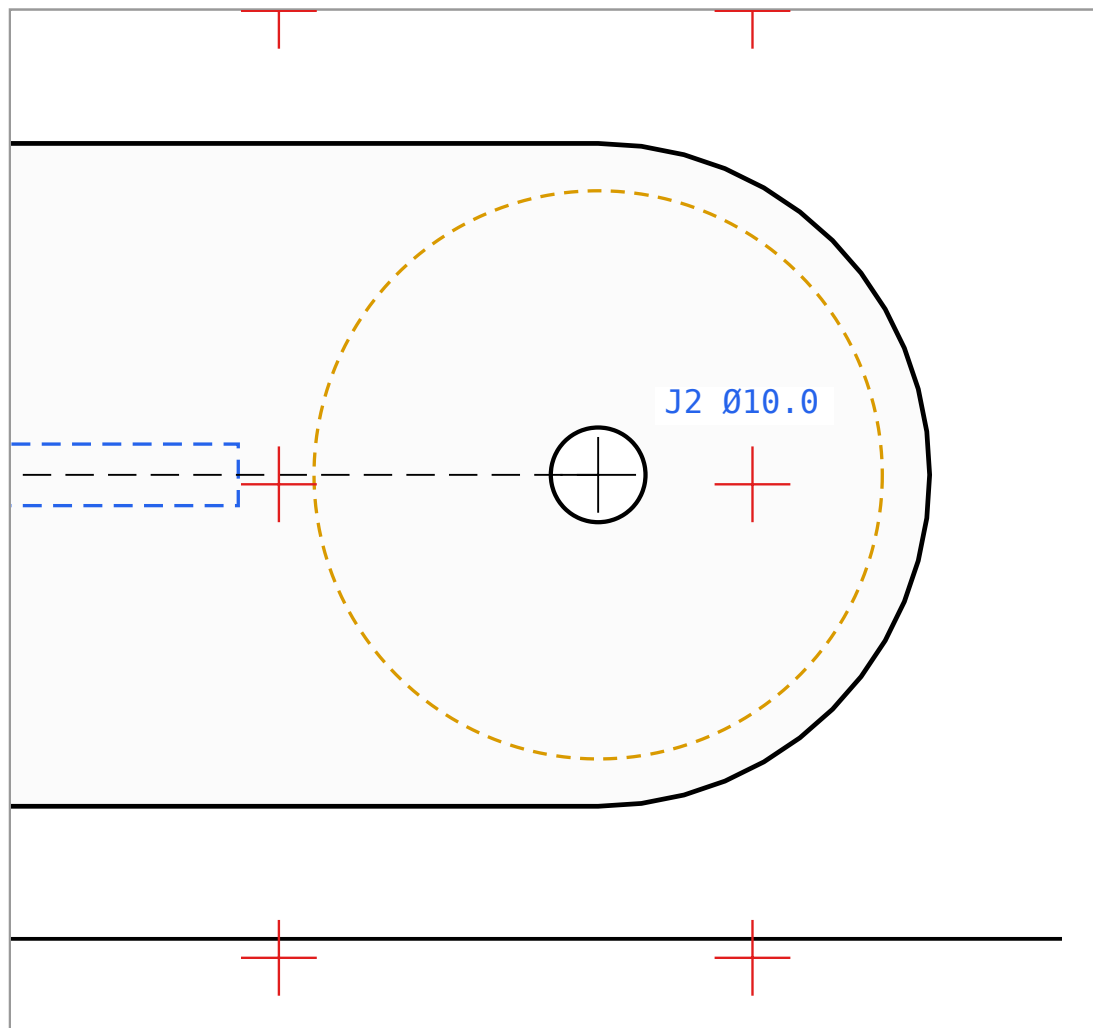
[picture p58: page 12]

BP-C · tile row 1/1, col 3/3 · overlap 10 mm, match red crosses · 100% scale

## BP-CHEEK

### cut 52

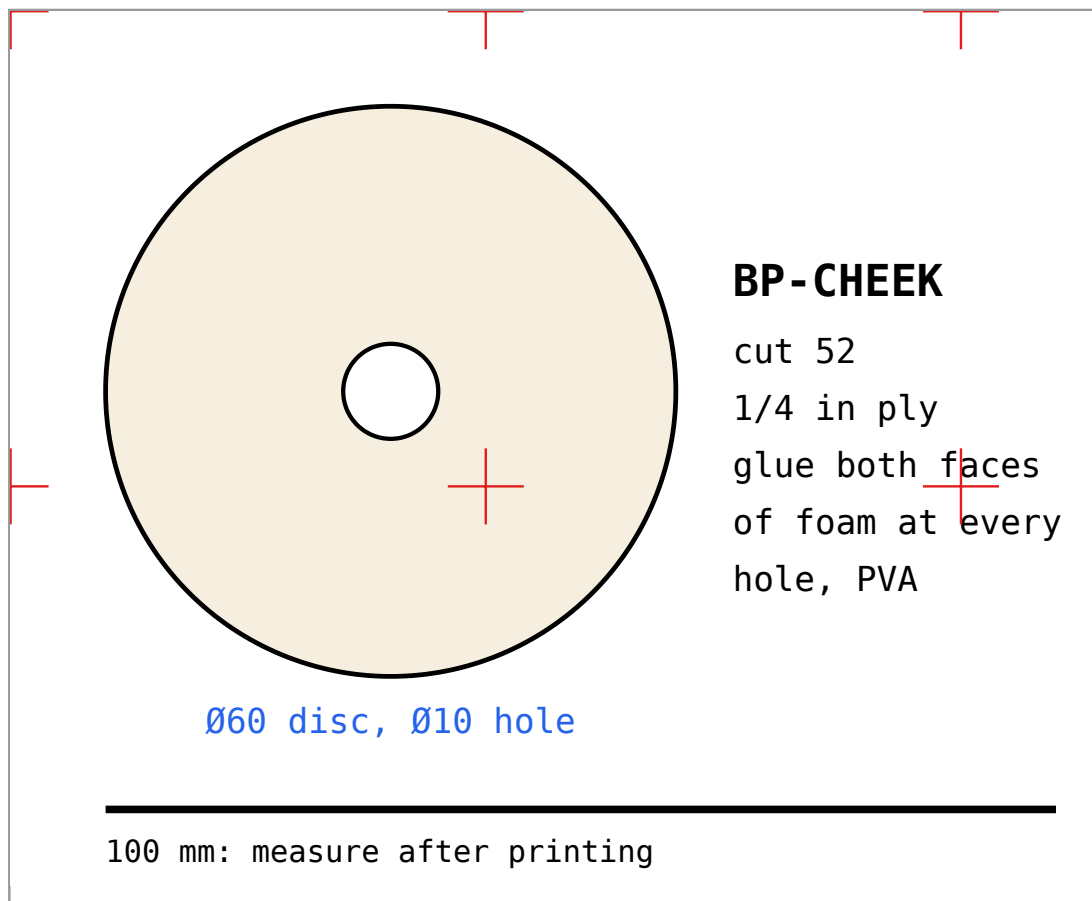
[picture p59: page 13]
Ø60 disc, Ø10 hole; glue both; faces

BP-CHEEK · tile row 1/1, col 1/1 · overlap 10 mm, match red crosses · 100% scale

1/4 in ply
of foam at every
hole, PVA

100 mm: measure after printing

146.8

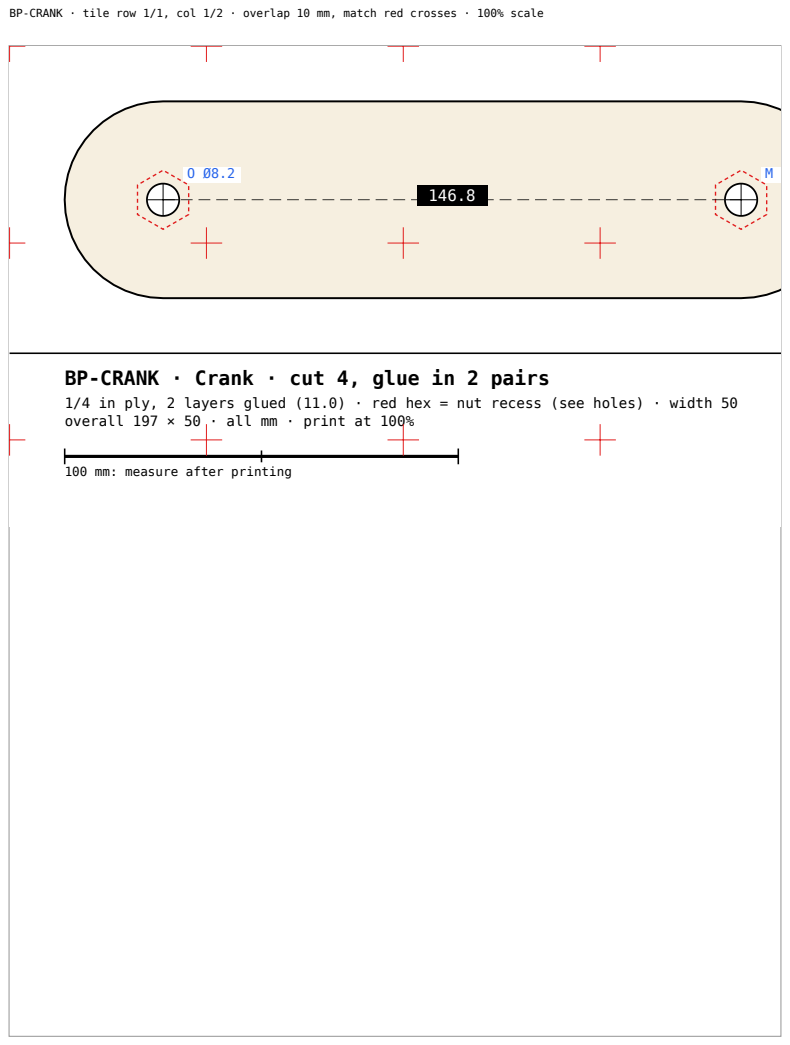
[picture p60: page 14]

BP-CRANK · tile row 1/1, col 1/2 · overlap 10 mm, match red crosses · 100% scale

BP-CRANK · Crank · cut 4, glue in 2 pairs
1/4 in ply, 2 layers glued (11.0) · red hex = nut recess (see holes) · width 50
overall 197 × 50 · all mm · print at 100%

100 mm: measure after printing

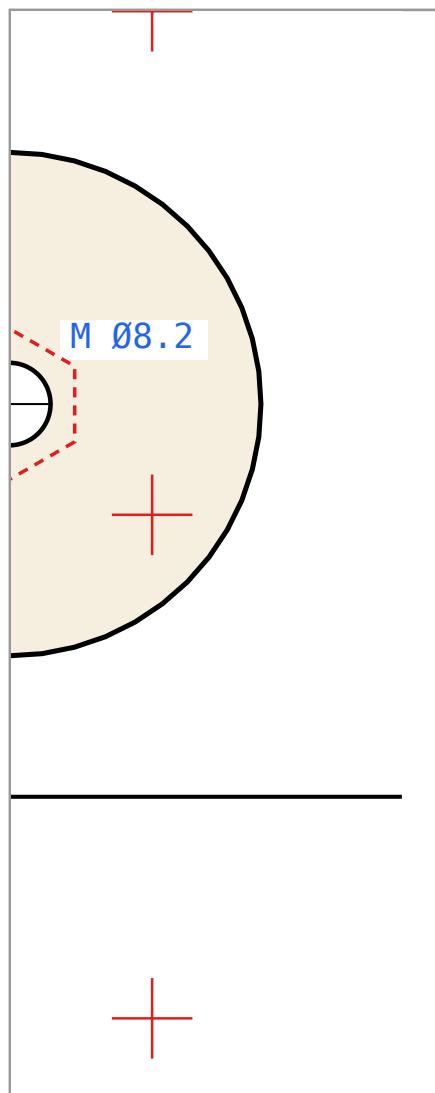
[picture p61: page 15]

BP-CRANK · tile row 1/1, col 2/2 · overlap 10 mm, match red crosses · 100% scale

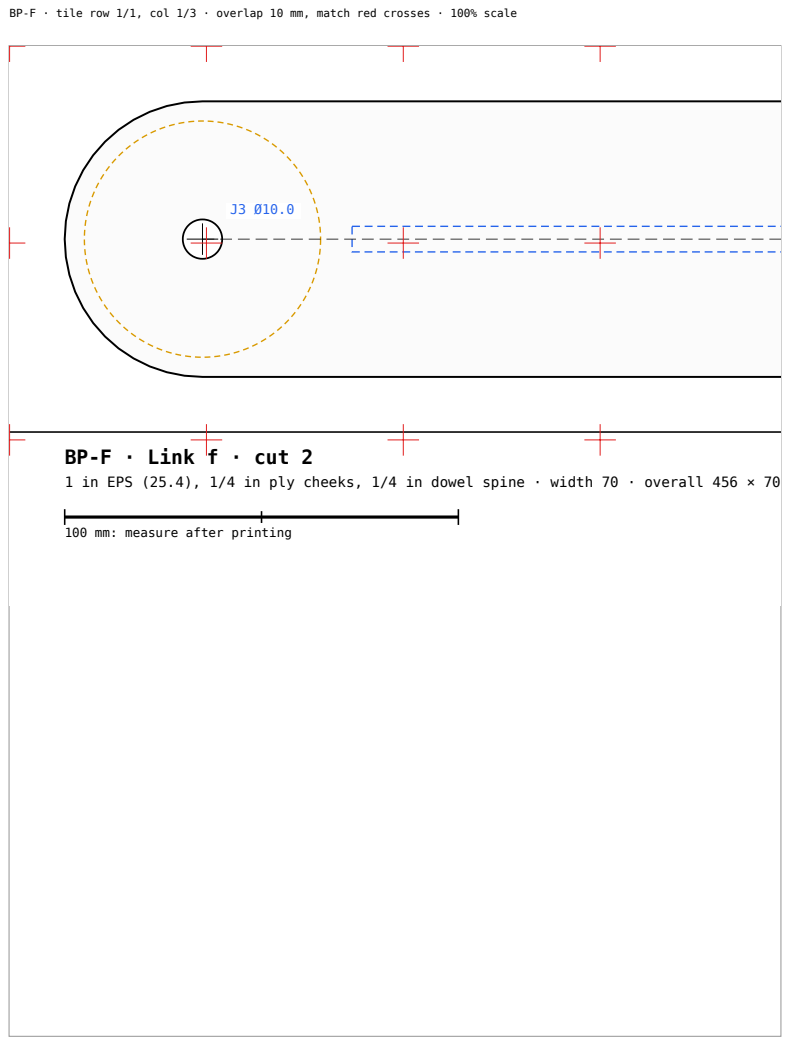
[picture p62: page 16]

BP-F · tile row 1/1, col 1/3 · overlap 10 mm, match red crosses · 100% scale

BP-F · Link f · cut 2
1 in EPS (25.4), 1/4 in ply cheeks, 1/4 in dowel spine · width 70 · overall 456 × 70

100 mm: measure after printing

385.7

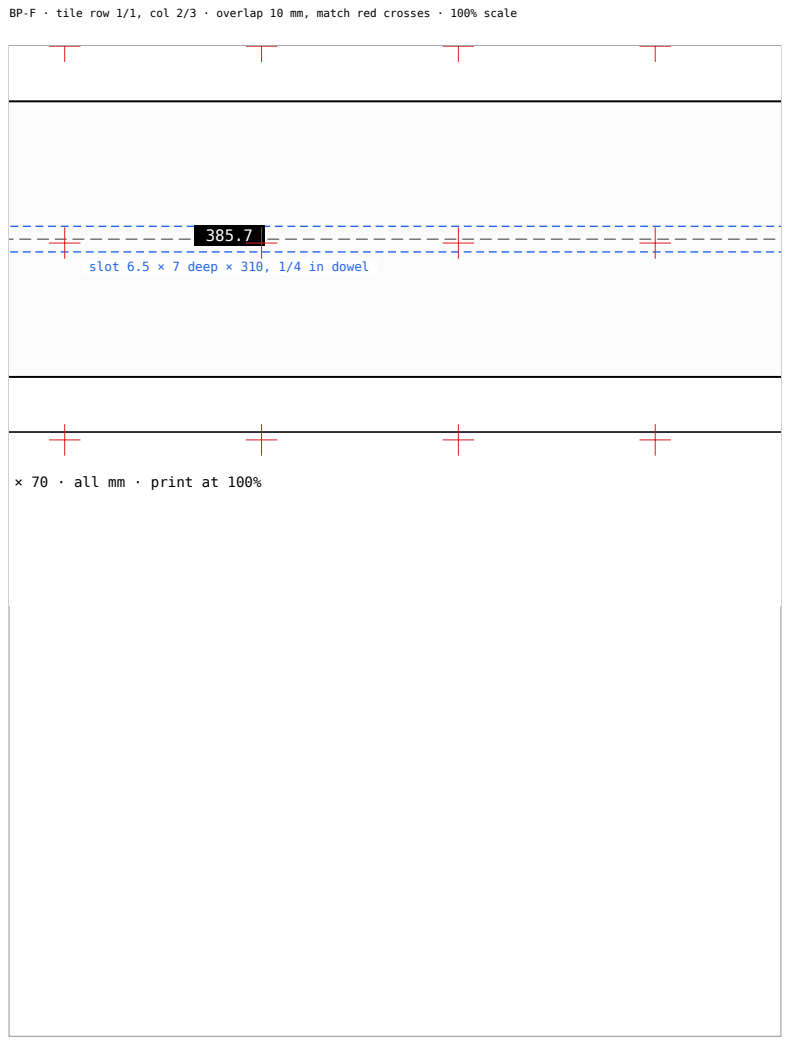
[picture p63: page 17]

BP-F · tile row 1/1, col 2/3 · overlap 10 mm, match red crosses · 100% scale

slot 6.5 × 7 deep × 310, 1/4 in dowel

× 70 · all mm · print at 100%

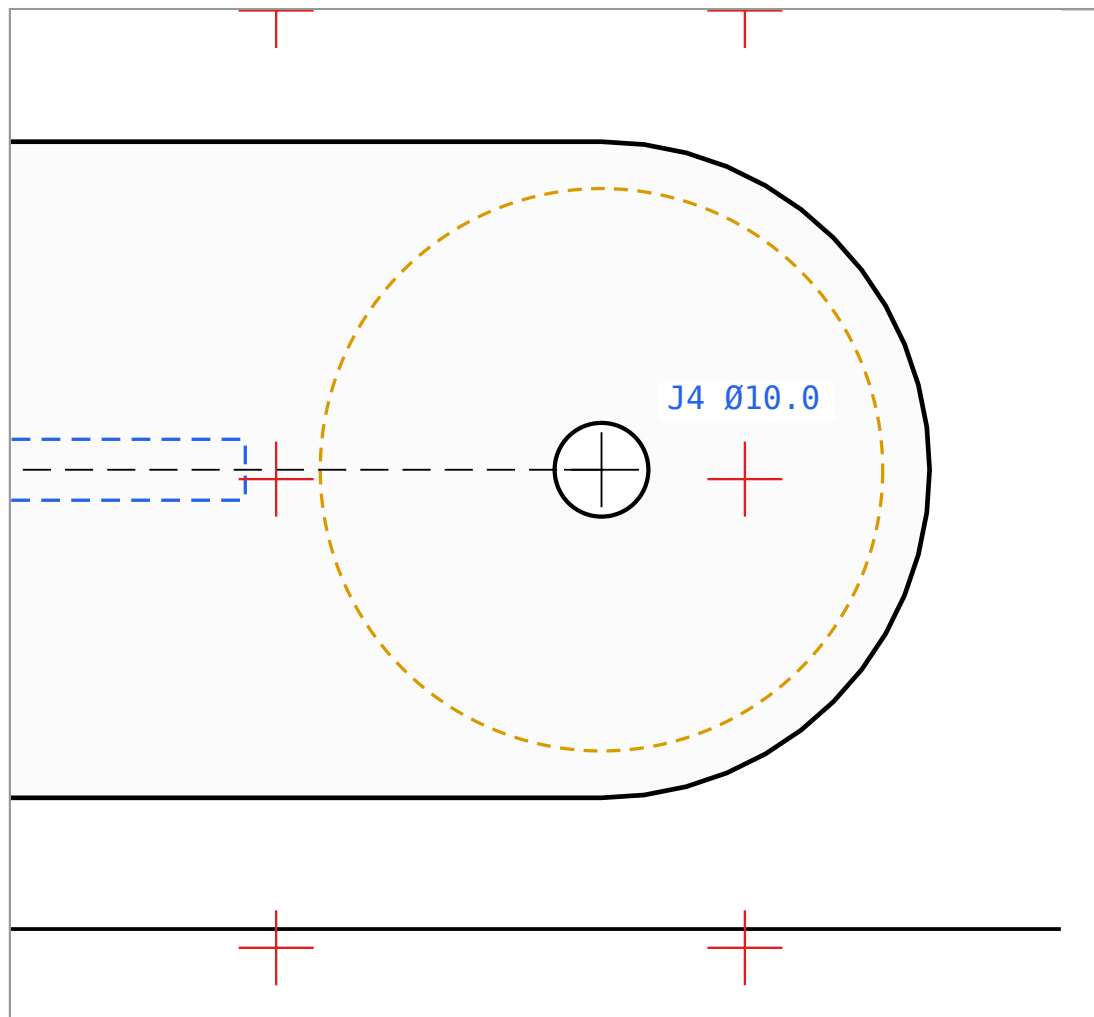
[picture p64: page 18]

BP-F · tile row 1/1, col 3/3 · overlap 10 mm, match red crosses · 100% scale

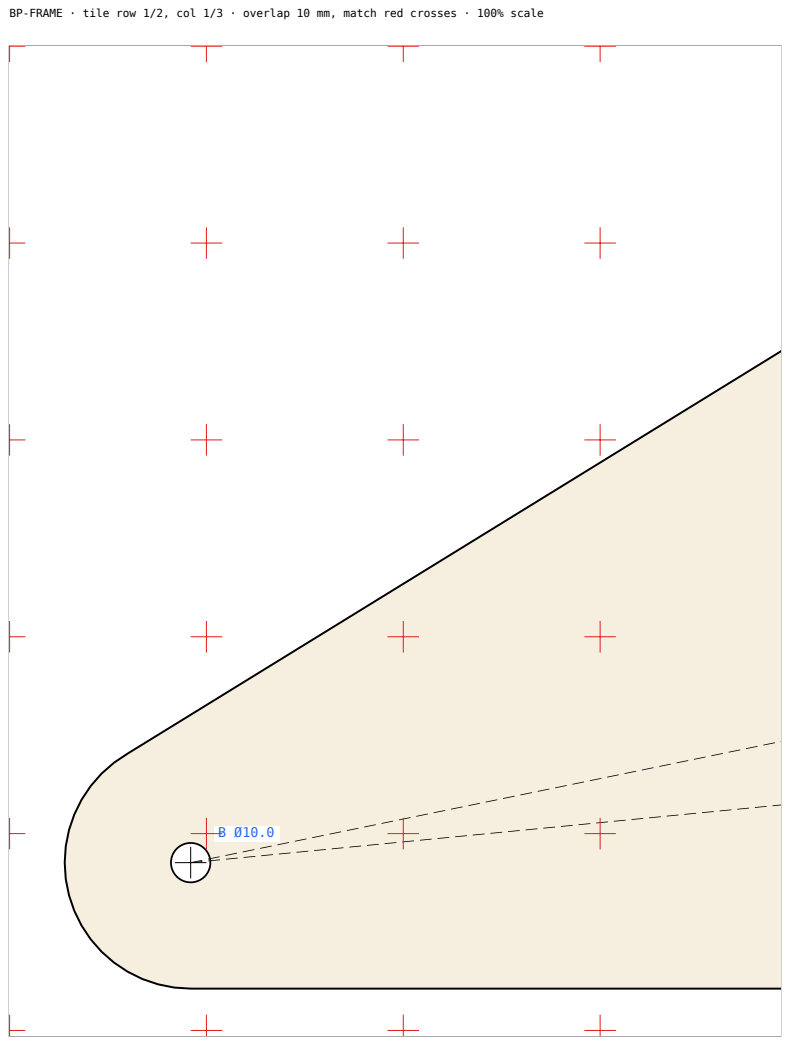
[picture p65: page 19]

BP-FRAME · tile row 1/2, col 1/3 · overlap 10 mm, match red crosses · 100% scale

80.0

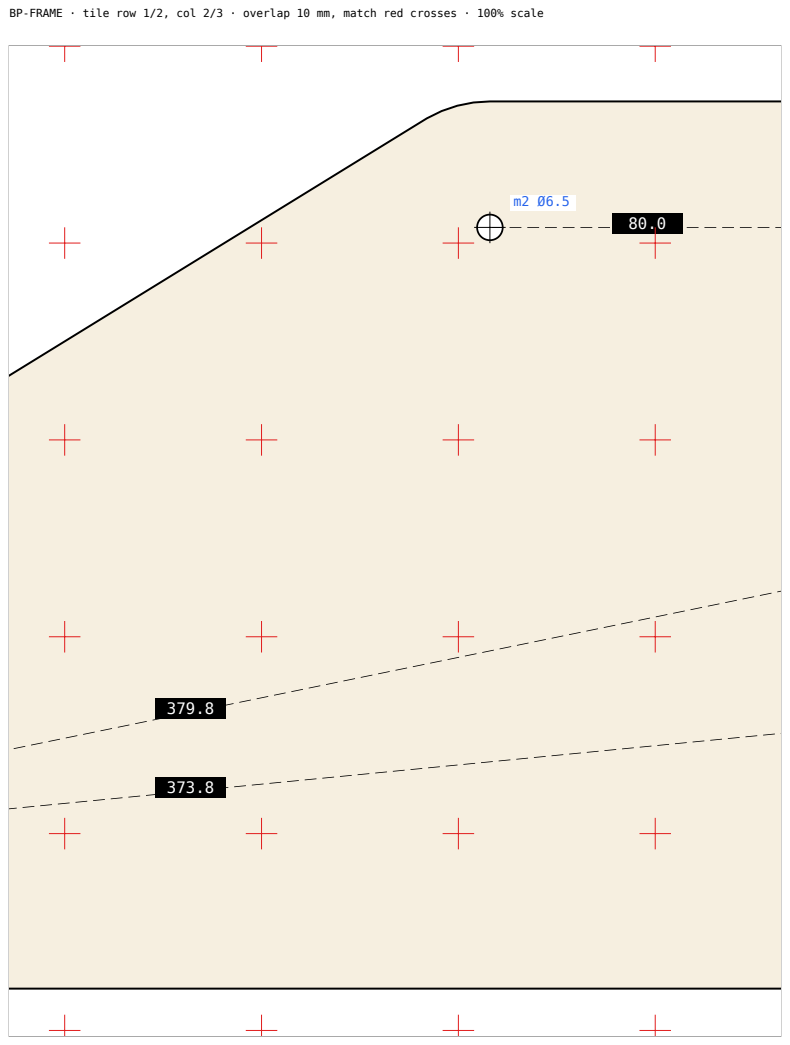
[picture p66: page 20]

BP-FRAME · tile row 1/2, col 2/3 · overlap 10 mm, match red crosses · 100% scale

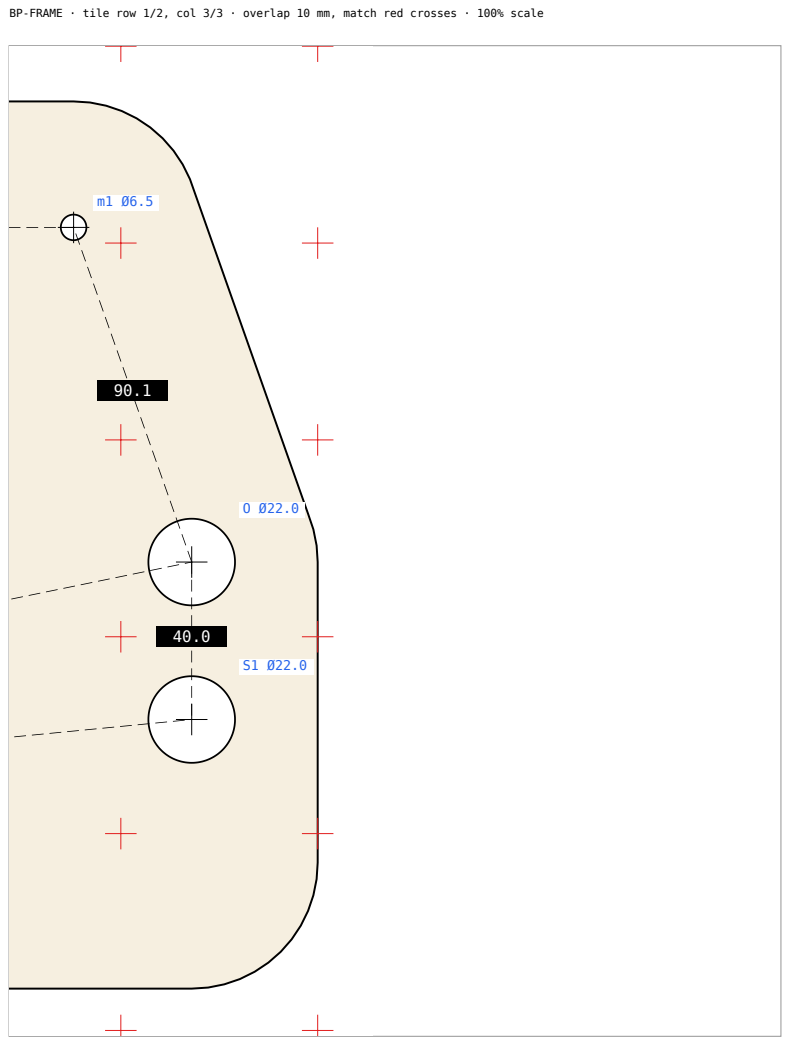
[picture p67: page 21]

BP-FRAME · tile row 1/2, col 3/3 · overlap 10 mm, match red crosses · 100% scale

BP-FRAME · tile row 2/2, col 1/3 · overlap 10 mm, match red crosses · 100% scale

# BP-FRAME · Frame · cut 4, glue in 2 pairs

### 1/4 in ply, 2 layers glued (11.0) · width 64 · overall 436 × 225 · all mm · print at

100 mm: measure after printing

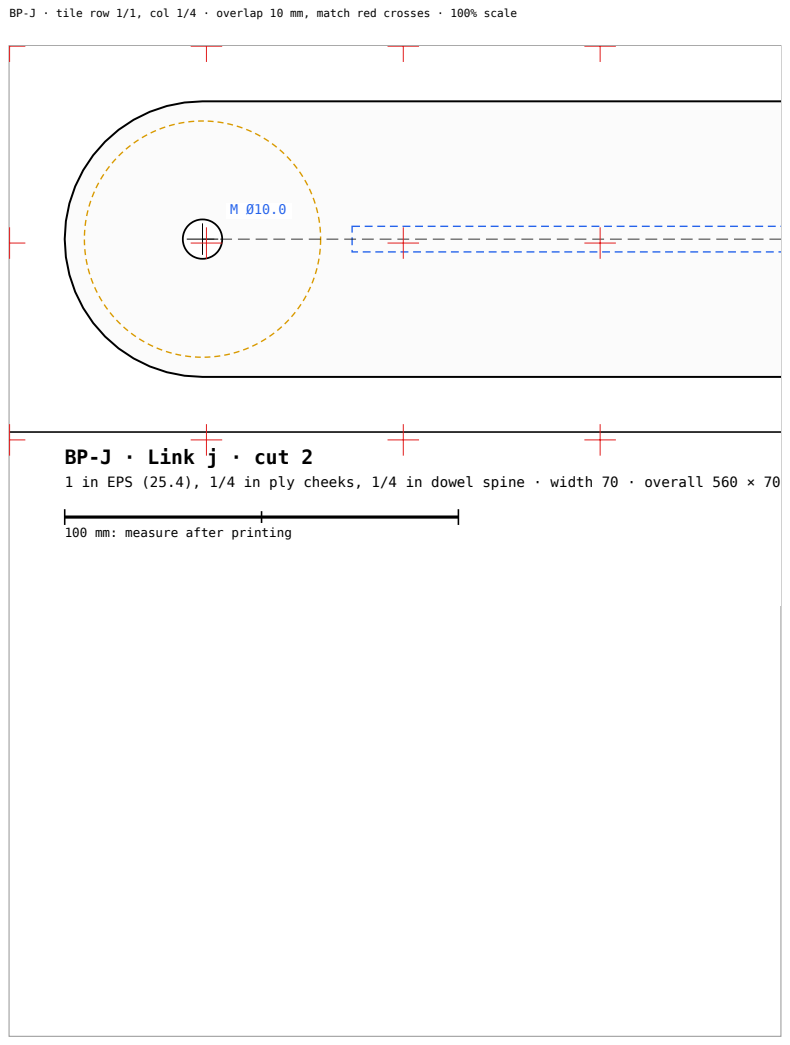
[picture p68: page 23]

BP-J · tile row 1/1, col 1/4 · overlap 10 mm, match red crosses · 100% scale

BP-J · Link j · cut 2
1 in EPS (25.4), 1/4 in ply cheeks, 1/4 in dowel spine · width 70 · overall 560 × 70

100 mm: measure after printing

489.5

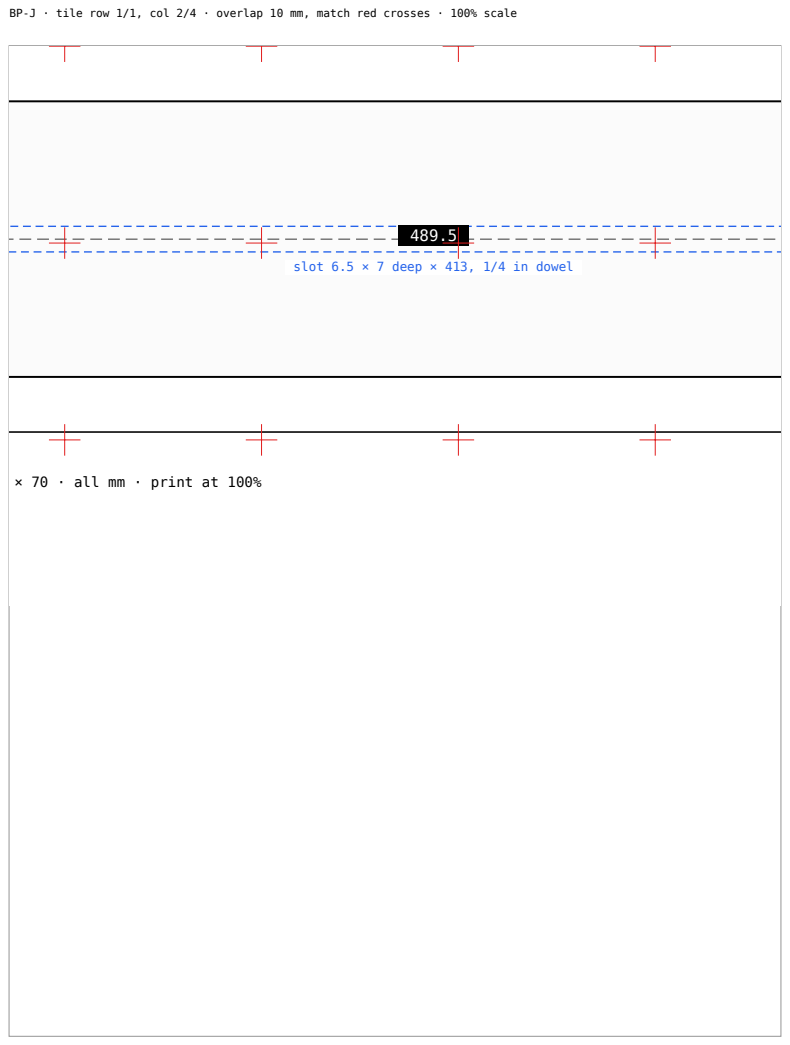
[picture p69: page 24]

BP-J · tile row 1/1, col 2/4 · overlap 10 mm, match red crosses · 100% scale

slot 6.5 × 7 deep × 413, 1/4 in dowel

× 70 · all mm · print at 100%

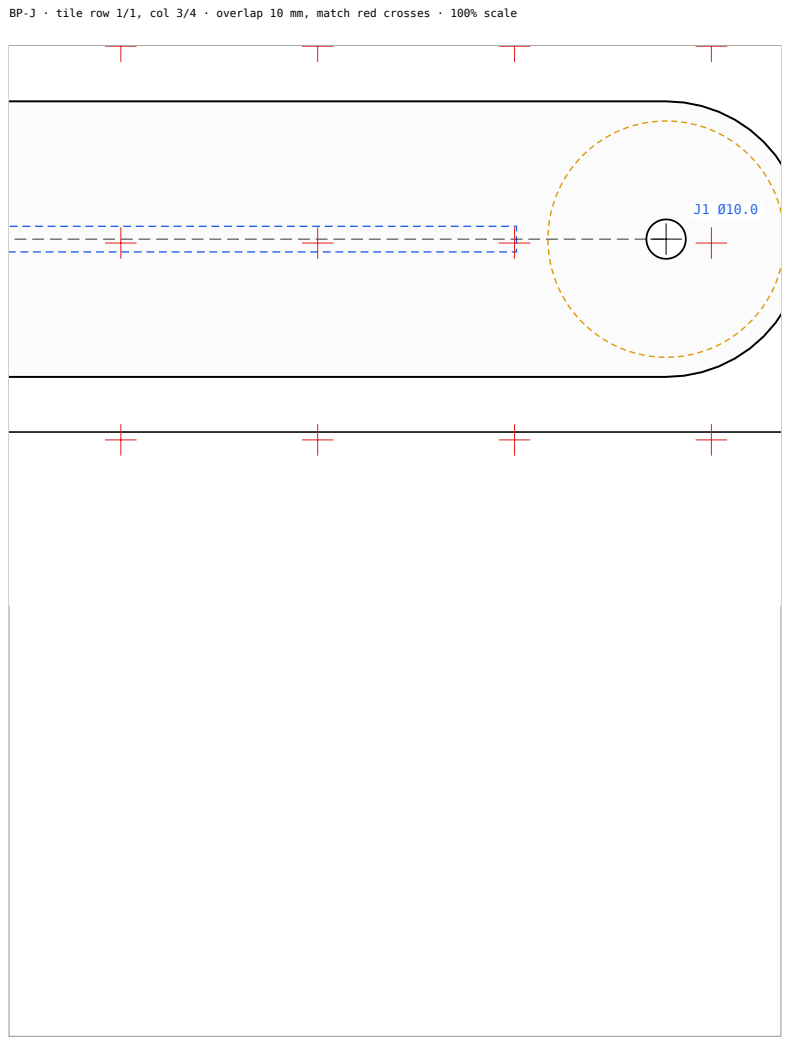
[picture p70: page 25]

BP-J · tile row 1/1, col 3/4 · overlap 10 mm, match red crosses · 100% scale

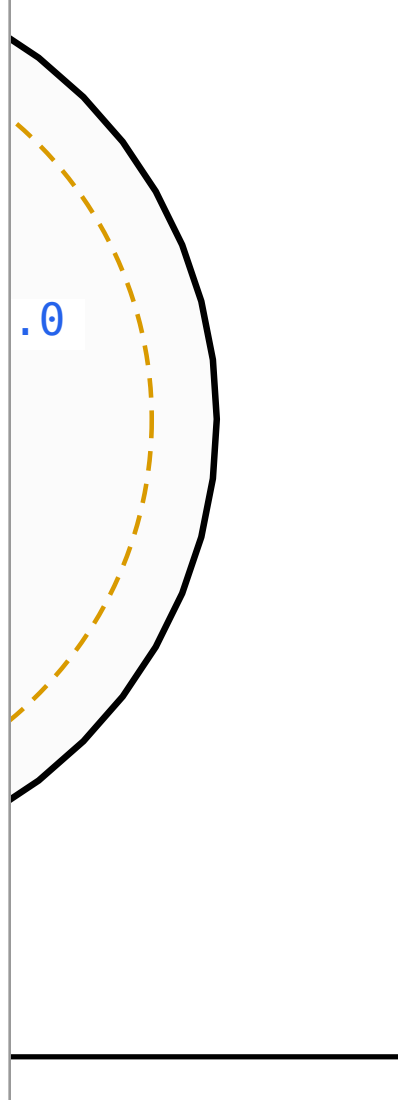
[picture p71: page 26]

BP-J · tile row 1/1, col 4/4 · overlap 10 mm, match red crosses · 100% scale

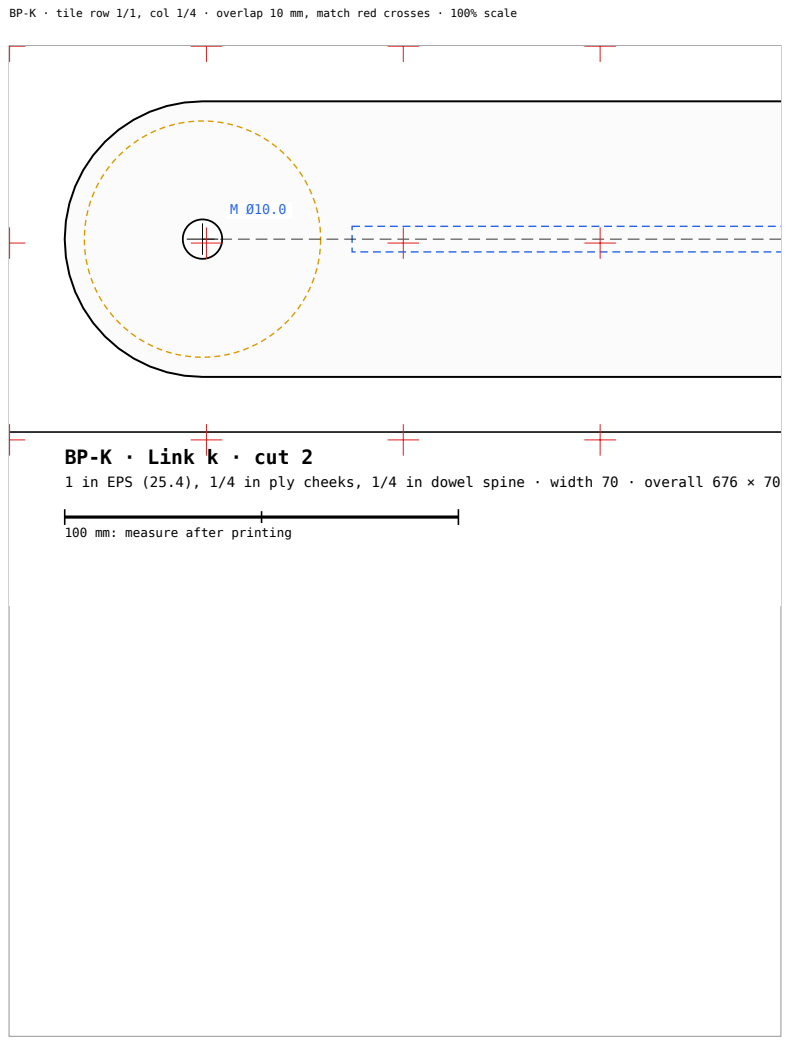
[picture p72: page 27]

BP-K · tile row 1/1, col 1/4 · overlap 10 mm, match red crosses · 100% scale

BP-K · Link k · cut 2
1 in EPS (25.4), 1/4 in ply cheeks, 1/4 in dowel spine · width 70 · overall 676 × 70

100 mm: measure after printing

606.0

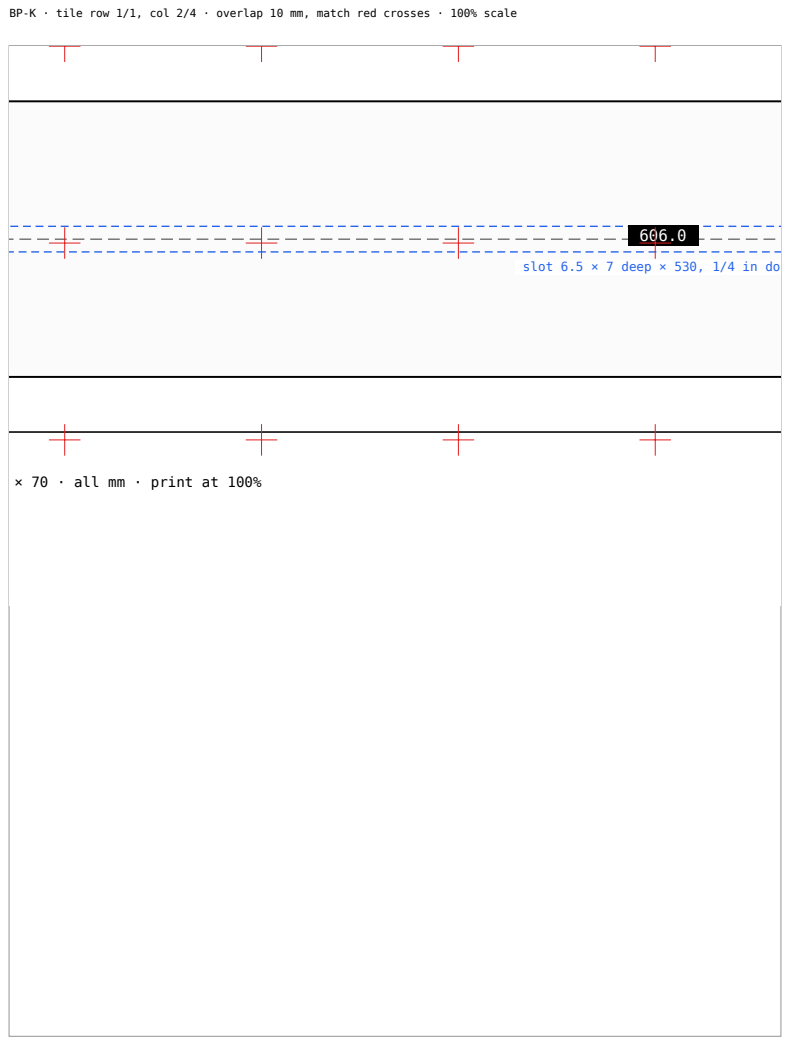
[picture p73: page 28]

BP-K · tile row 1/1, col 2/4 · overlap 10 mm, match red crosses · 100% scale

slot 6.5 × 7 deep × 530, 1/4 in do

× 70 · all mm · print at 100%

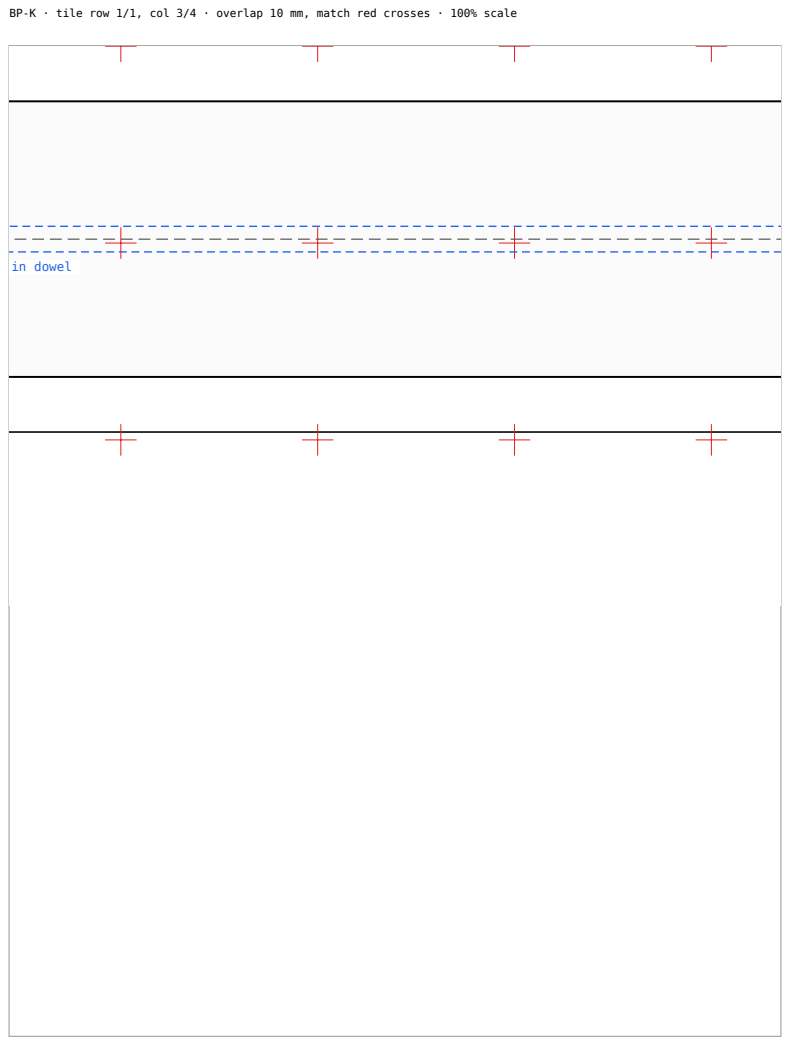
[picture p74: page 29]
in dowel

BP-K · tile row 1/1, col 3/4 · overlap 10 mm, match red crosses · 100% scale

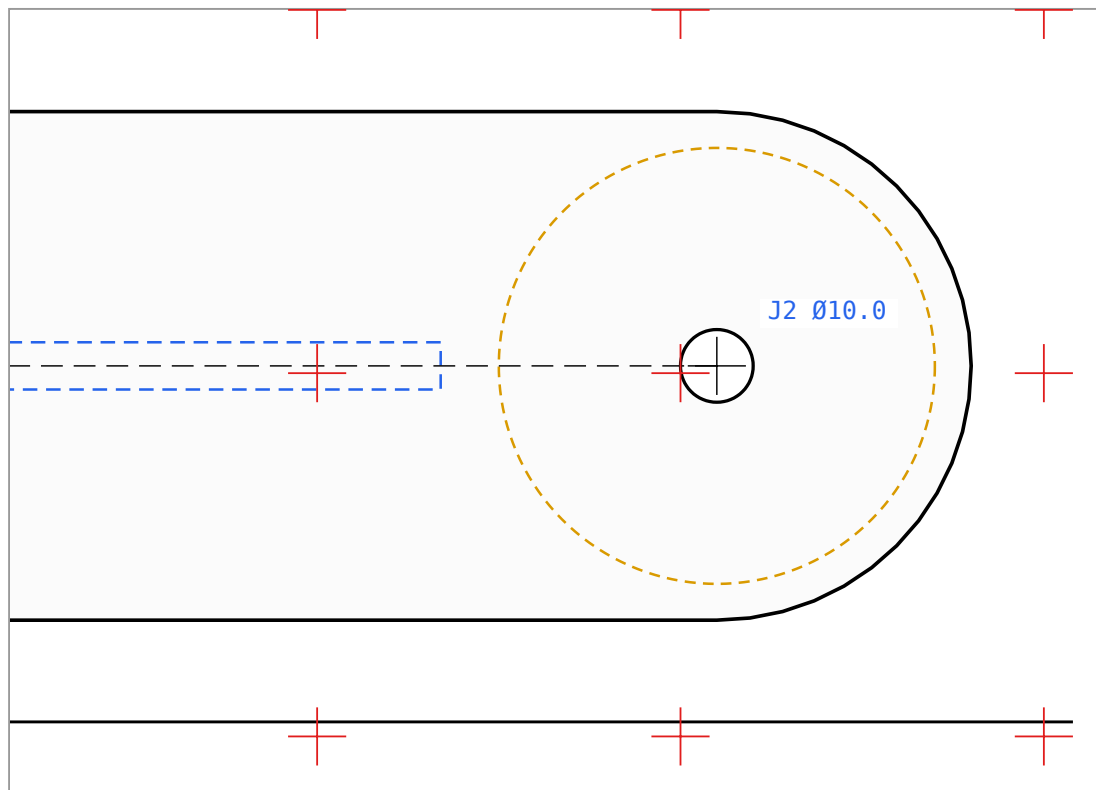
[picture p75: page 30]

BP-K · tile row 1/1, col 4/4 · overlap 10 mm, match red crosses · 100% scale

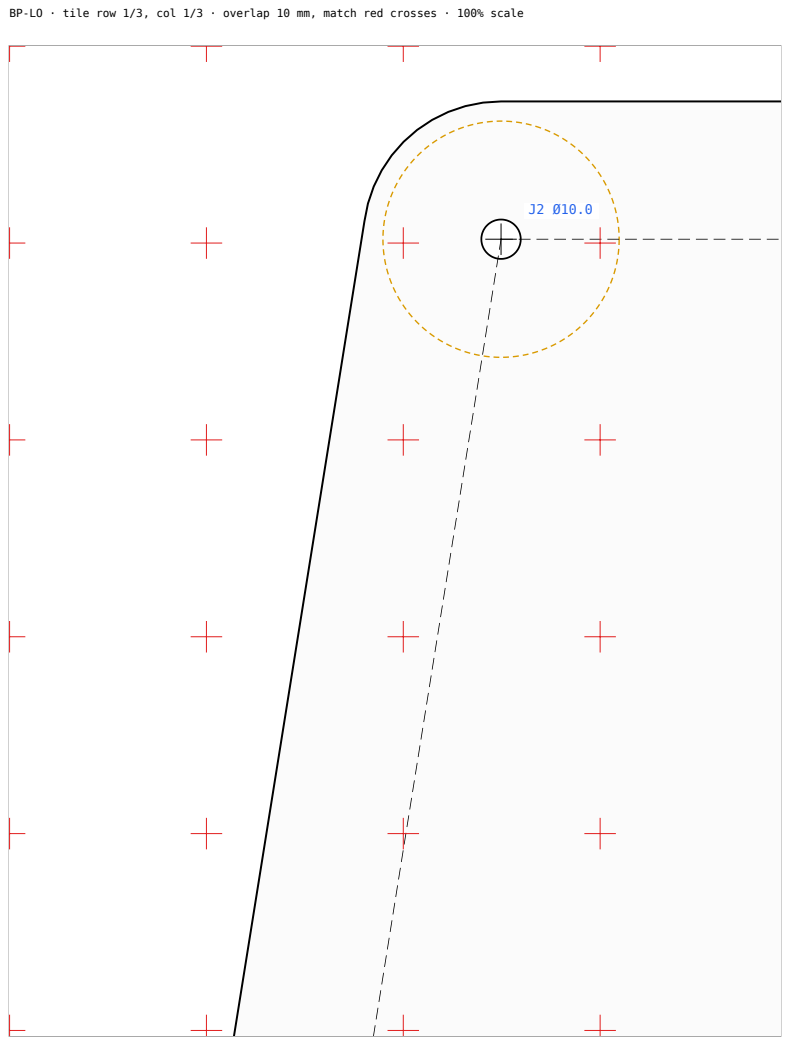
[picture p76: page 31]

BP-LO · tile row 1/3, col 1/3 · overlap 10 mm, match red crosses · 100% scale

359.3

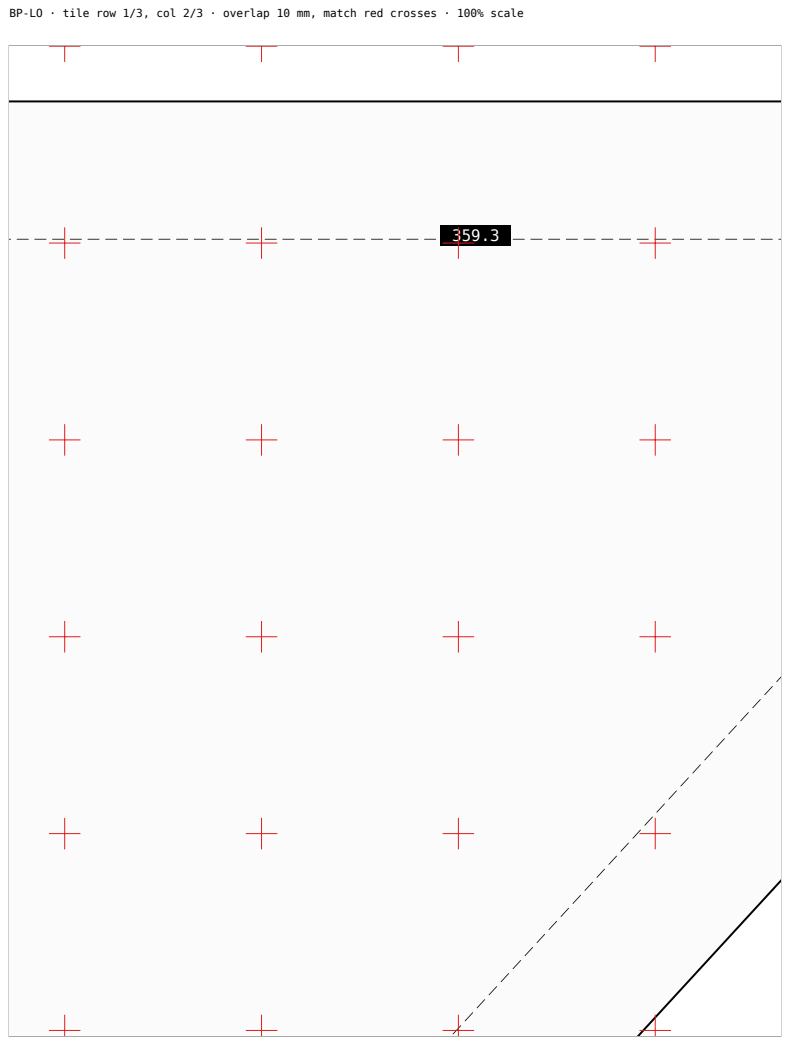
[picture p77: page 32]

BP-LO · tile row 1/3, col 2/3 · overlap 10 mm, match red crosses · 100% scale

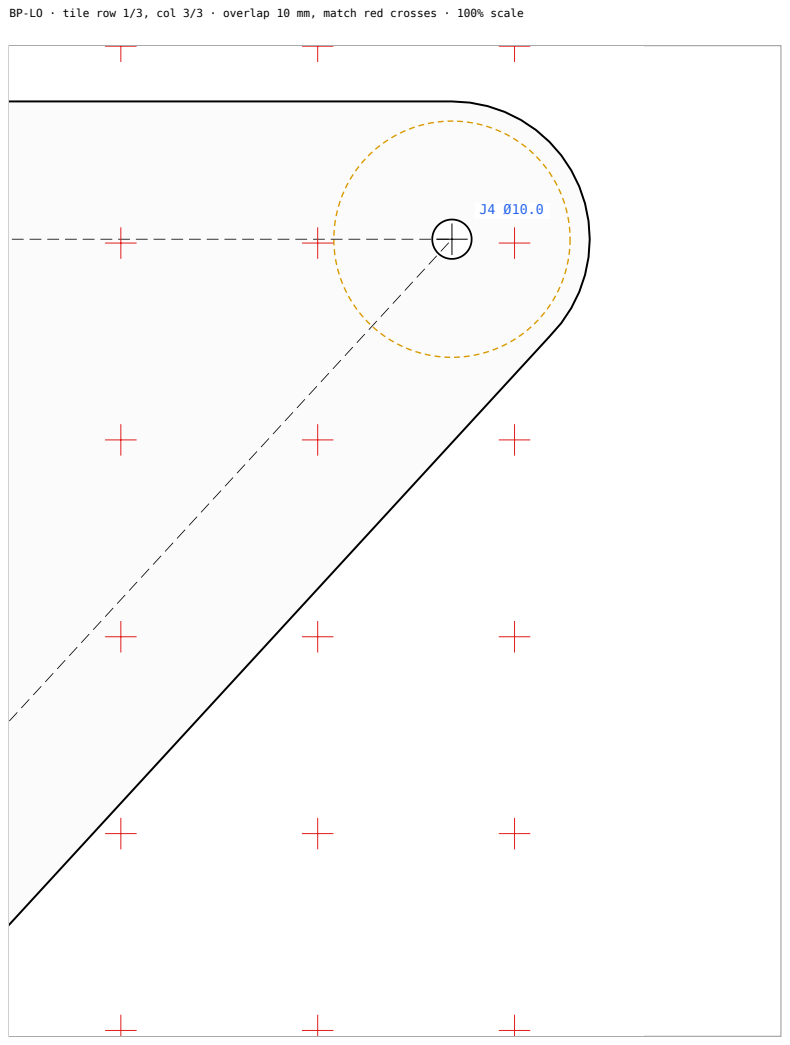
[picture p78: page 33]

BP-LO · tile row 1/3, col 3/3 · overlap 10 mm, match red crosses · 100% scale

479.7

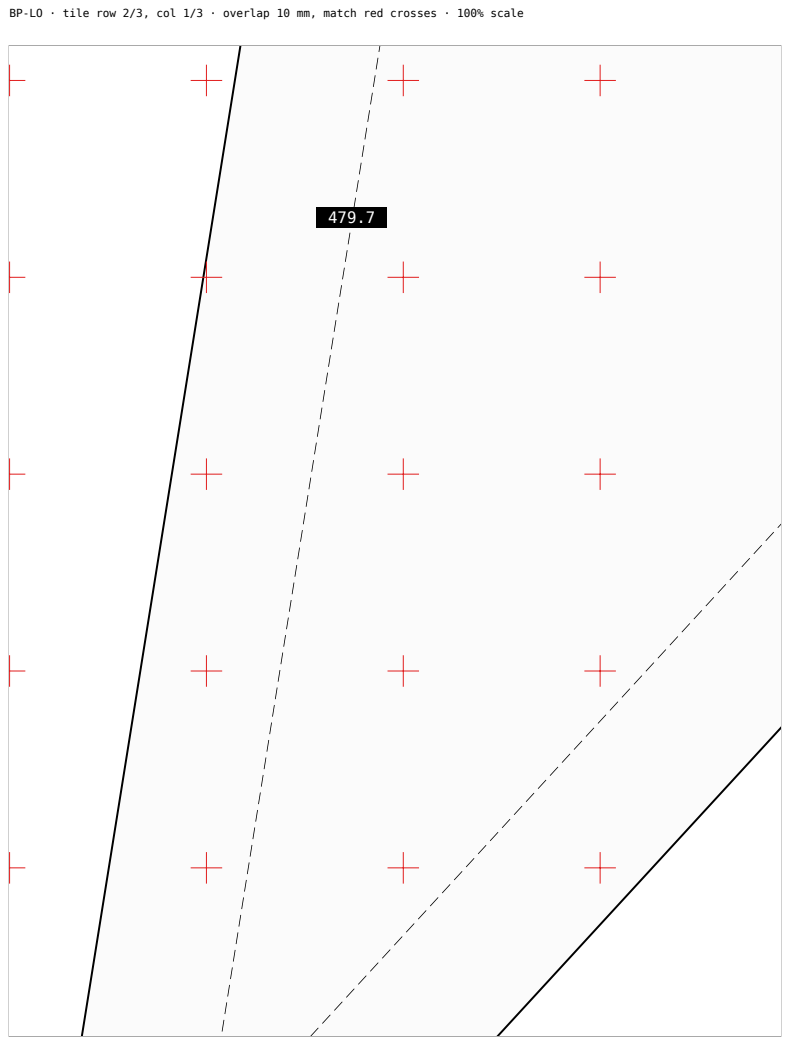
[picture p79: page 34]

BP-LO · tile row 2/3, col 1/3 · overlap 10 mm, match red crosses · 100% scale

BP-LO · tile row 2/3, col 2/3 · overlap 10 mm, match red crosses · 100% scale

643.2

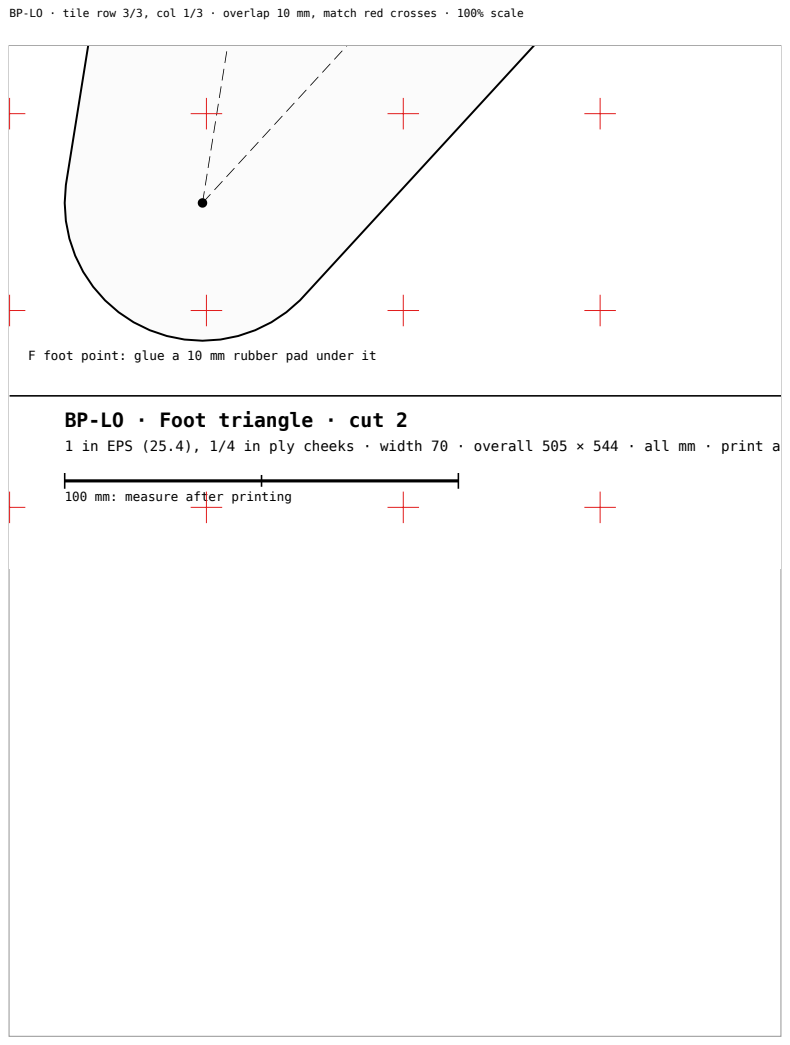
[picture p80: page 36]
100 mm: measure after; printing

BP-LO · tile row 3/3, col 1/3 · overlap 10 mm, match red crosses · 100% scale

F foot point: glue a 10 mm rubber pad under it

BP-LO · Foot triangle · cut 2
1 in EPS (25.4), 1/4 in ply cheeks · width 70 · overall 505 × 544 · all mm · print a

100.0

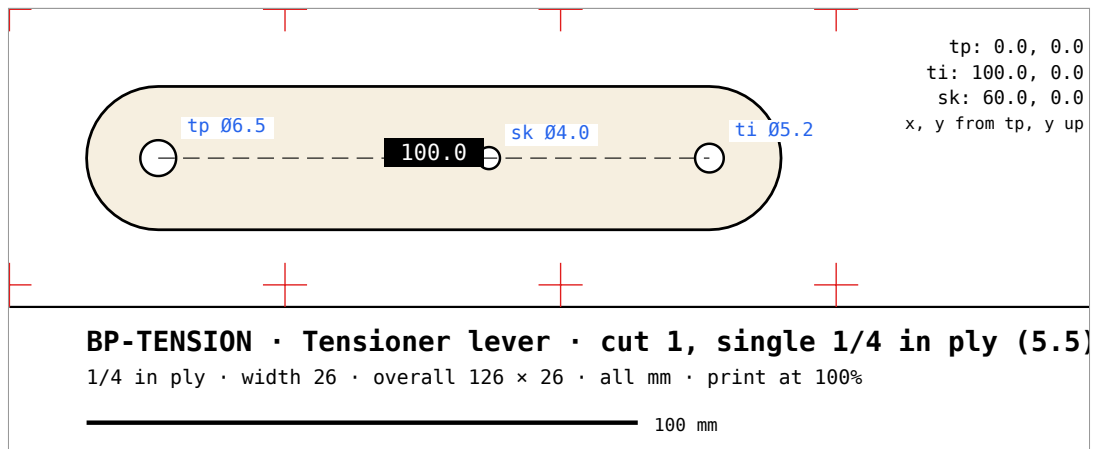
[picture p81: page 37]

BP-TENSION · tile row 1/1, col 1/2 · overlap 10 mm, match red crosses · 100% scale

x, y from tp, y up

BP-TENSION · Tensioner lever · cut 1, single 1/4 in ply (5.5)
1/4 in ply · width 26 · overall 126 × 26 · all mm · print at 100%

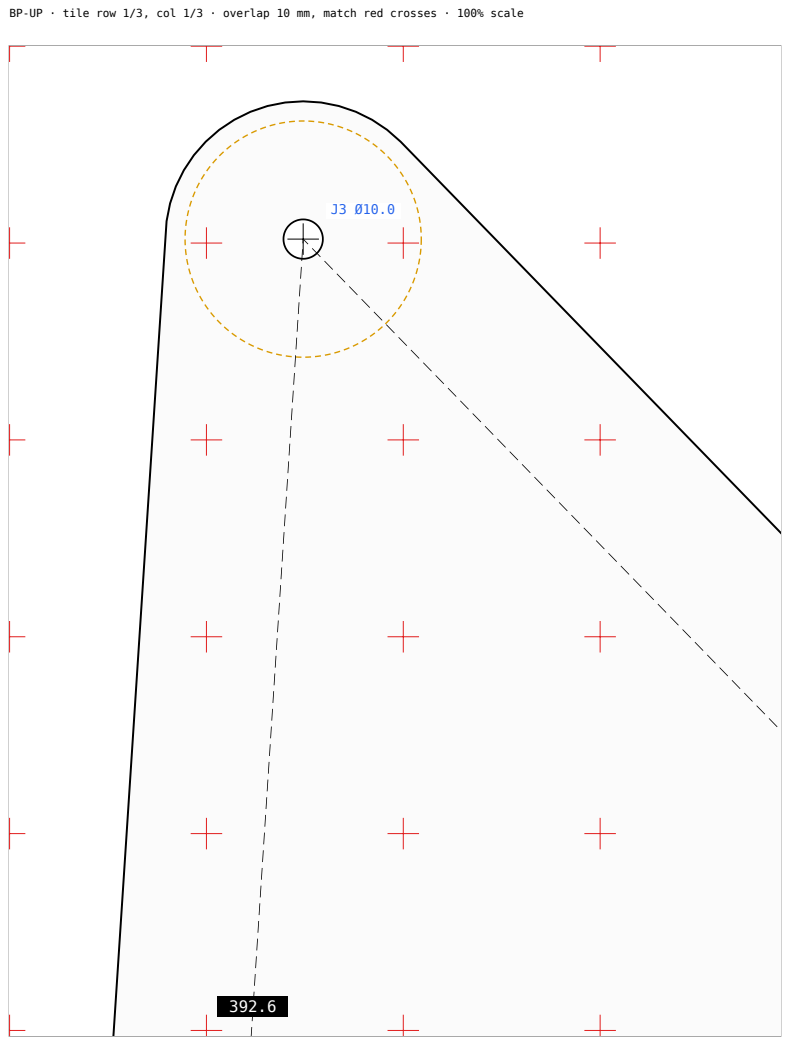
[picture p82: page 38]

BP-UP · tile row 1/3, col 1/3 · overlap 10 mm, match red crosses · 100% scale

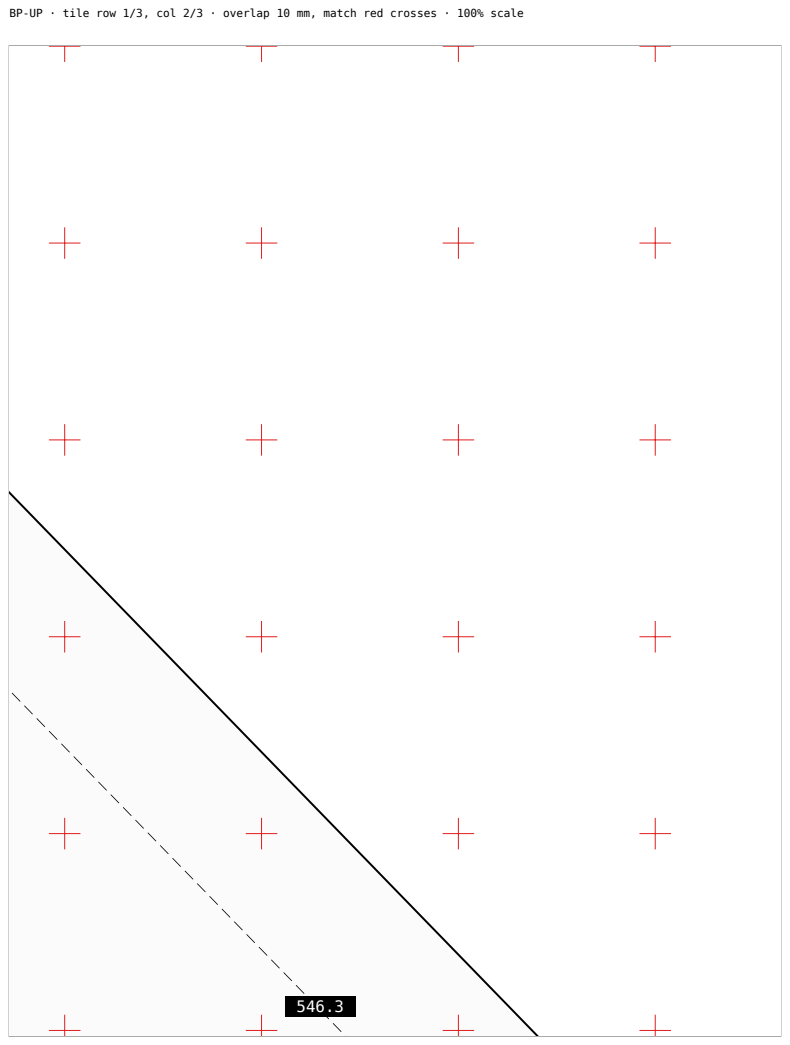
[picture p83: page 39]

BP-UP · tile row 1/3, col 2/3 · overlap 10 mm, match red crosses · 100% scale

392.6

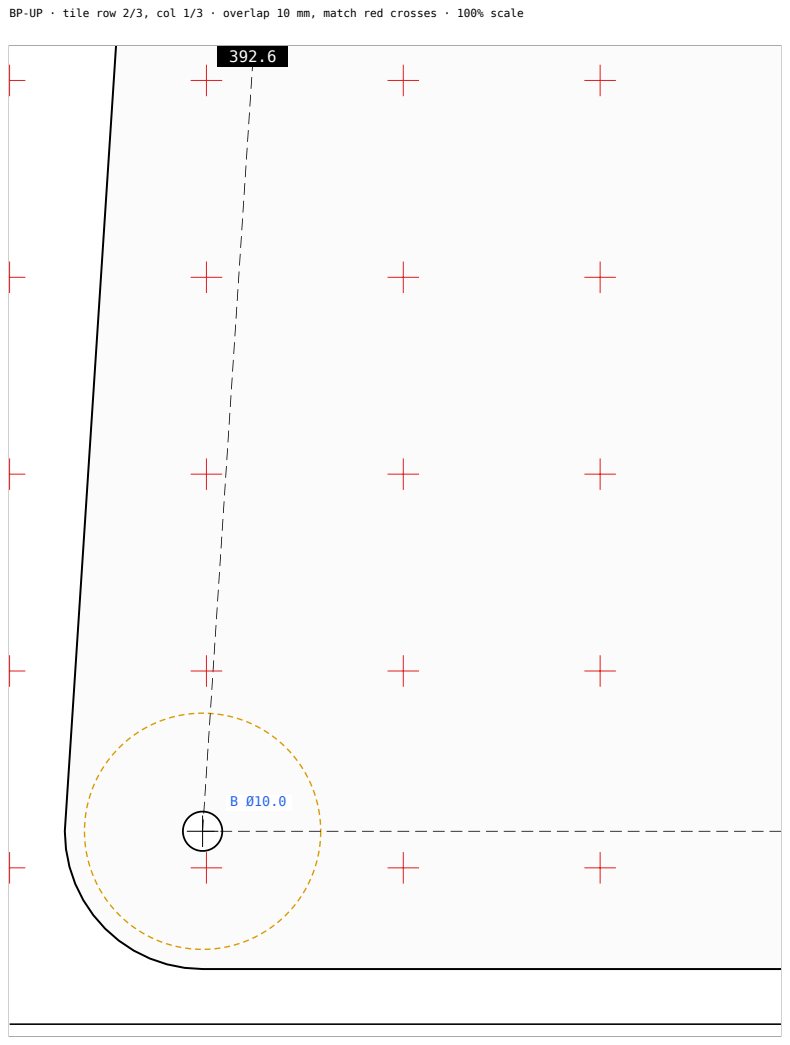
[picture p84: page 40]

BP-UP · tile row 2/3, col 1/3 · overlap 10 mm, match red crosses · 100% scale

546.3

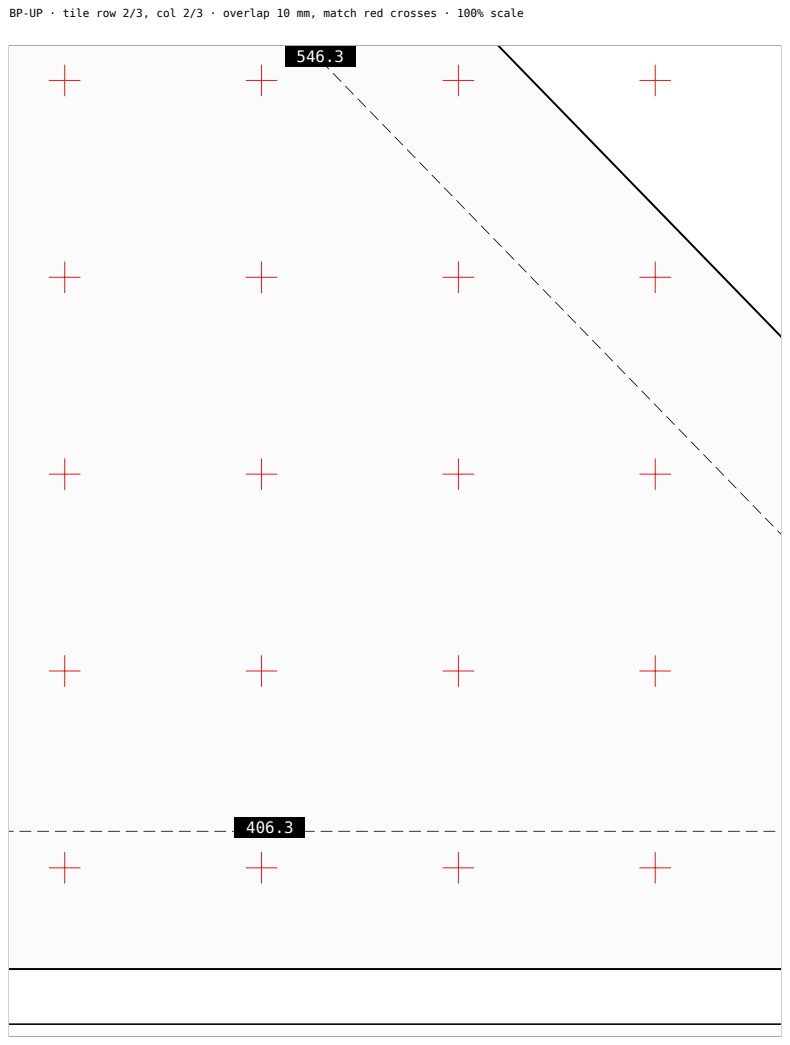
[picture p85: page 41]

BP-UP · tile row 2/3, col 2/3 · overlap 10 mm, match red crosses · 100% scale

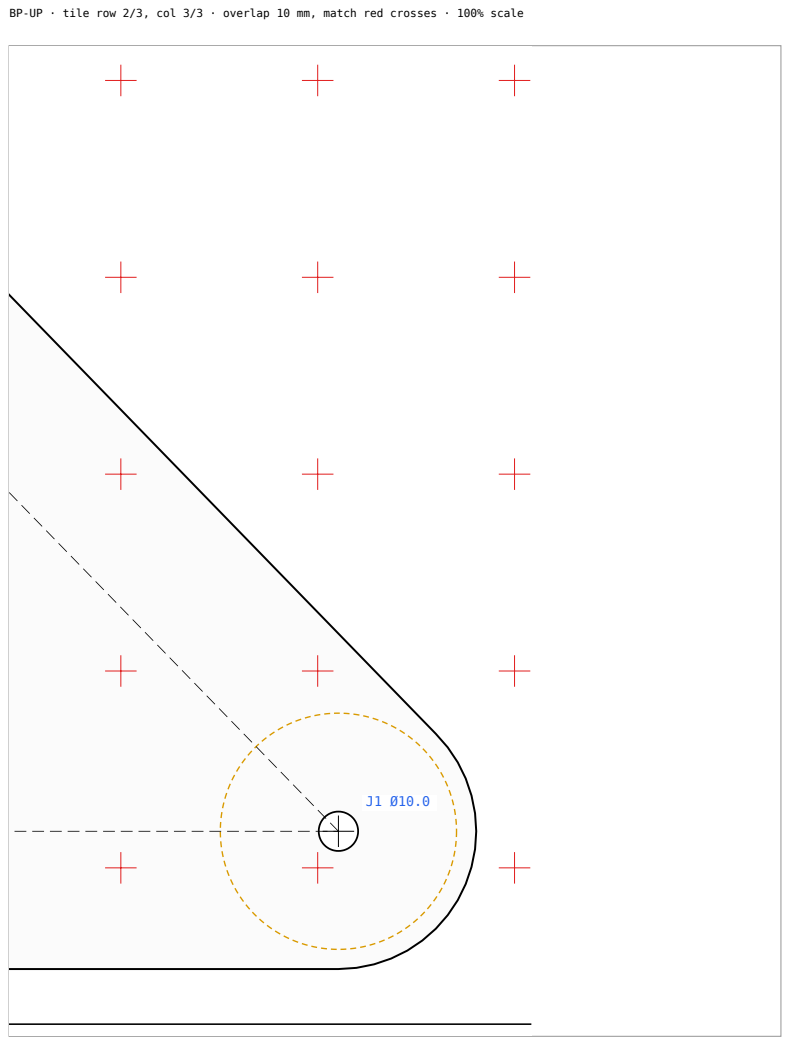
[picture p86: page 42]

BP-UP · tile row 2/3, col 3/3 · overlap 10 mm, match red crosses · 100% scale

BP-UP · tile row 3/3, col 1/3 · overlap 10 mm, match red crosses · 100% scale

# BP-UP · Top triangle · cut 2

### 1 in EPS (25.4), 1/4 in ply cheeks · width 70 · overall 476 × 462 · all mm · print a

100 mm: measure after printing
