hartswf0/centaur-walker/rig/files/bike/BK-parts-tiled-letter.pdf

9

58.6

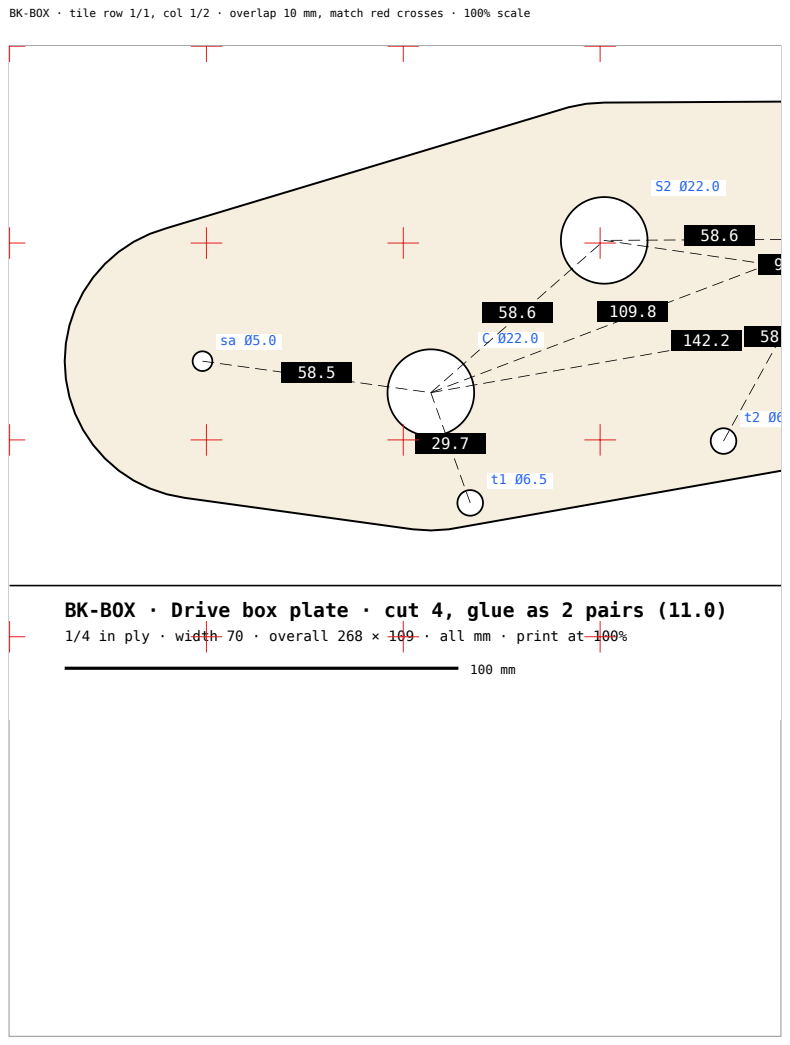
[picture p87: page 1]
1/4 in ply · width; 70 · overall 268 ×; · all mm · print at

BK-BOX · tile row 1/1, col 1/2 · overlap 10 mm, match red crosses · 100% scale

BK-BOX · Drive box plate · cut 4, glue as 2 pairs (11.0)

97.0 | 40.0

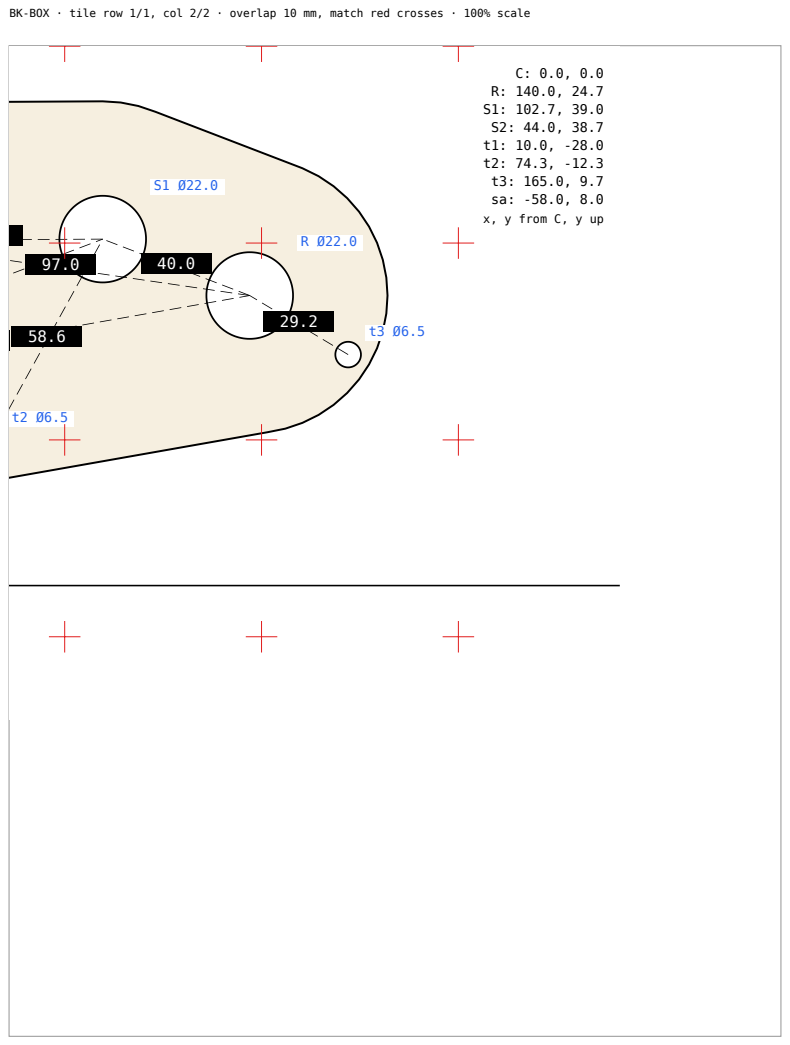
[picture p88: page 2]
C: 0.0, 0.0 R: 140.0, 24.7 S1: 102.7, 39.0 S2: 44.0, 38.7 t1: 10.0, -28.0 t2: 74.3, -12.3 t3: 165.0, 9.7 sa: -58.0, 8.0 x, y from C, y up

BK-BOX · tile row 1/1, col 2/2 · overlap 10 mm, match red crosses · 100% scale

BK-C · tile row 1/1, col 1/2 · overlap 10 mm, match red crosses · 100% scale

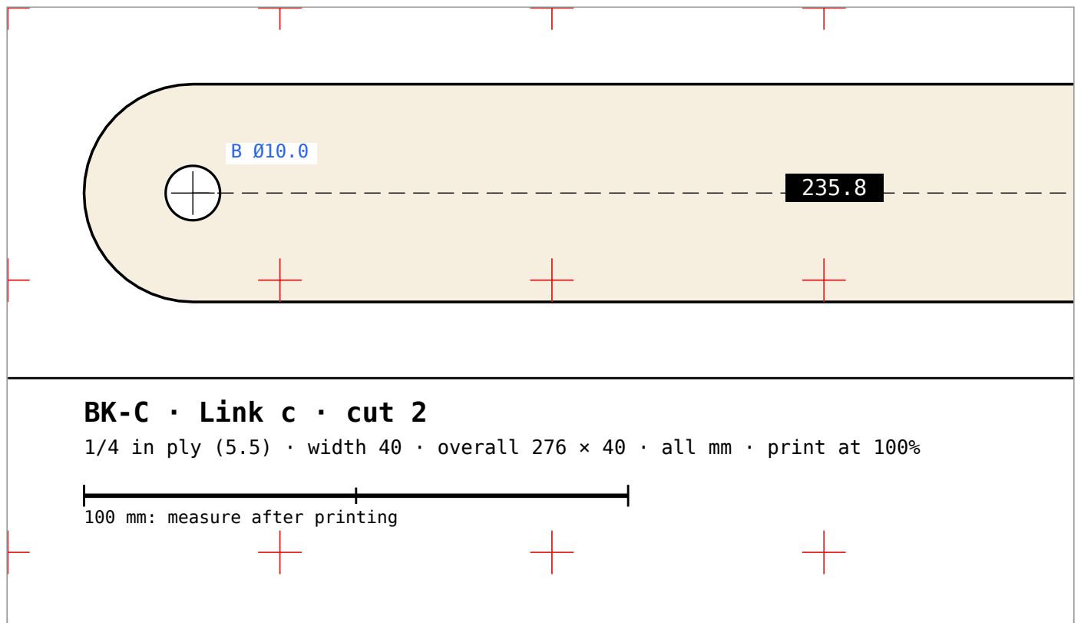
[picture p89: figure]
BK-C · Link c · cut 2; 100 mm: measure after printing

### 1/4 in ply (5.5) · width 40 · overall 276 × 40 · all mm · print at 100%

BK-C · tile row 1/1, col 2/2 · overlap 10 mm, match red crosses · 100% scale

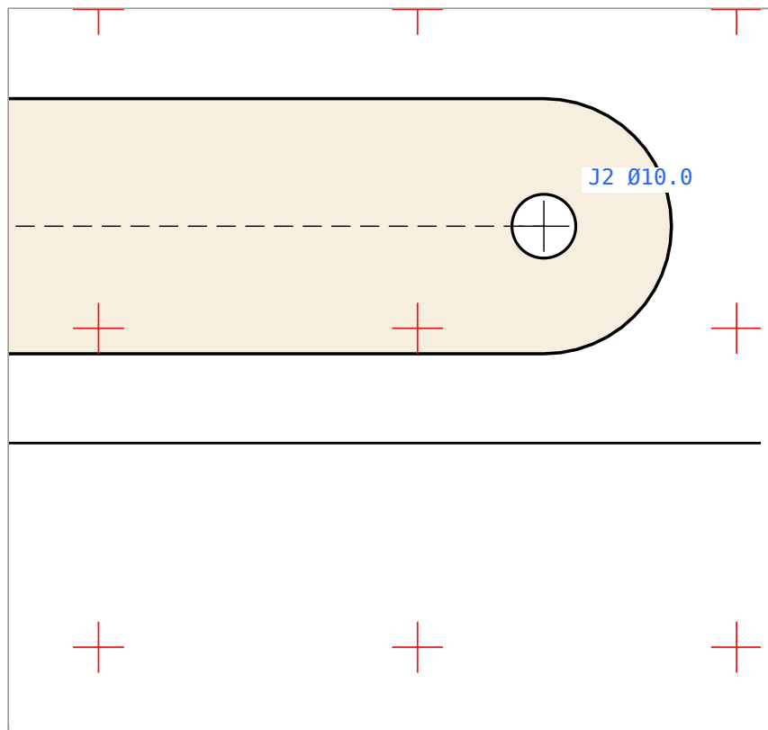
[picture p90: figure]

90.0

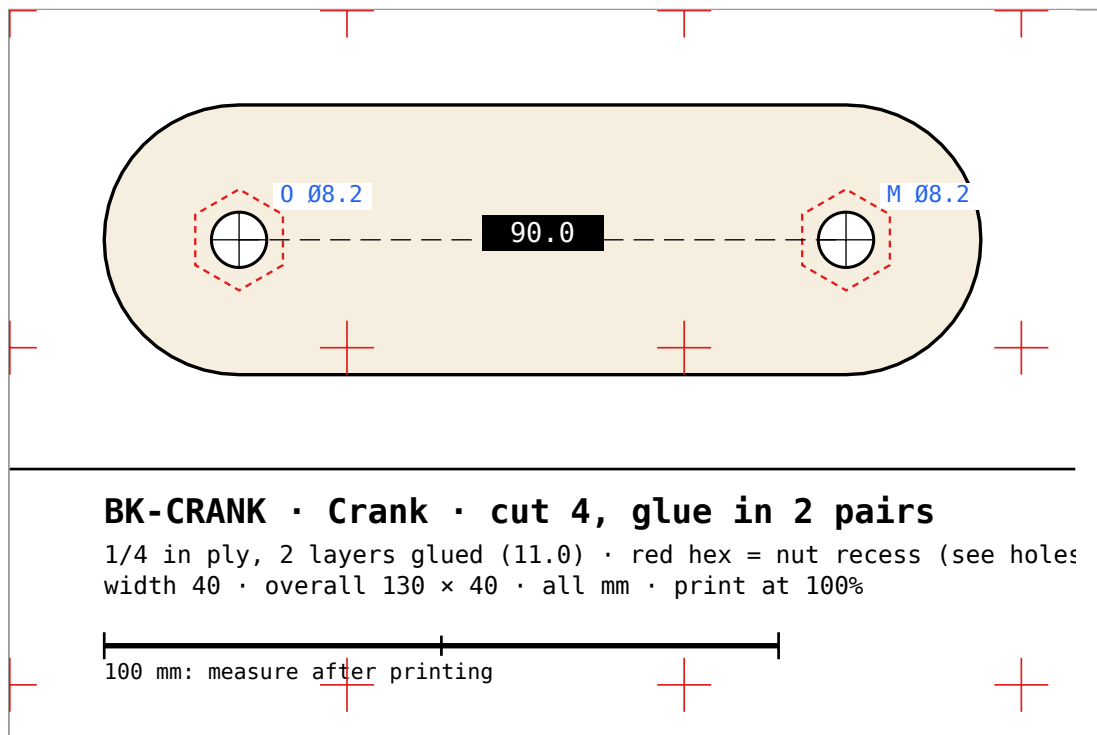
[picture p91: page 5]
100 mm: measure after; printing

BK-CRANK · tile row 1/1, col 1/1 · overlap 10 mm, match red crosses · 100% scale

BK-CRANK · Crank · cut 4, glue in 2 pairs
1/4 in ply, 2 layers glued (11.0) · red hex = nut recess (see holes
width 40 · overall 130 × 40 · all mm · print at 100%

BK-F · tile row 1/1, col 1/2 · overlap 10 mm, match red crosses · 100% scale

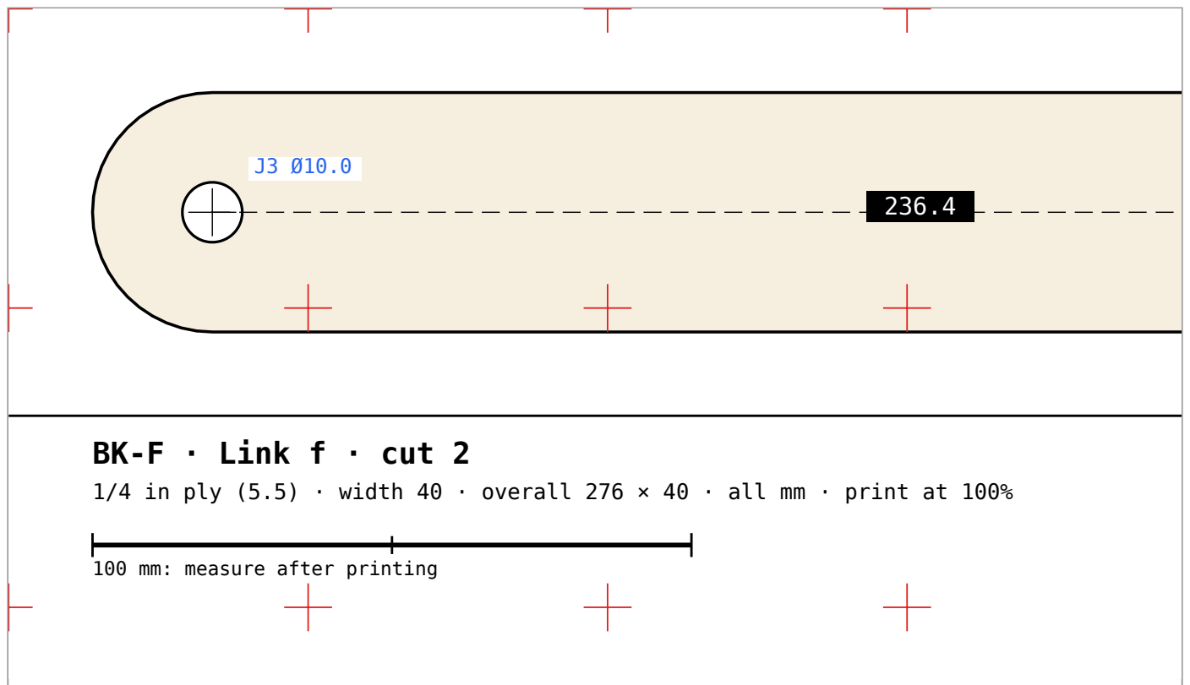
[picture p92: figure]
BK-F · Link f · cut 2; 100 mm: measure after printing

### 1/4 in ply (5.5) · width 40 · overall 276 × 40 · all mm · print at 100%

BK-F · tile row 1/1, col 2/2 · overlap 10 mm, match red crosses · 100% scale

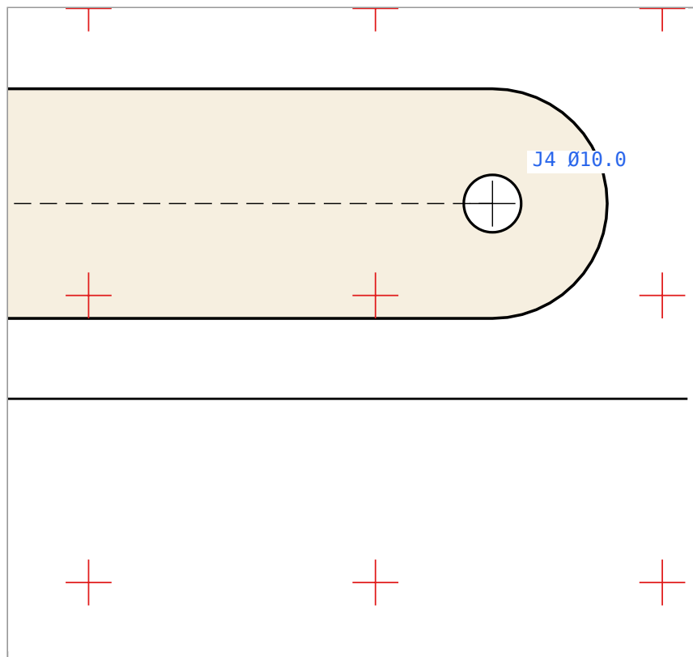
[picture p93: figure]
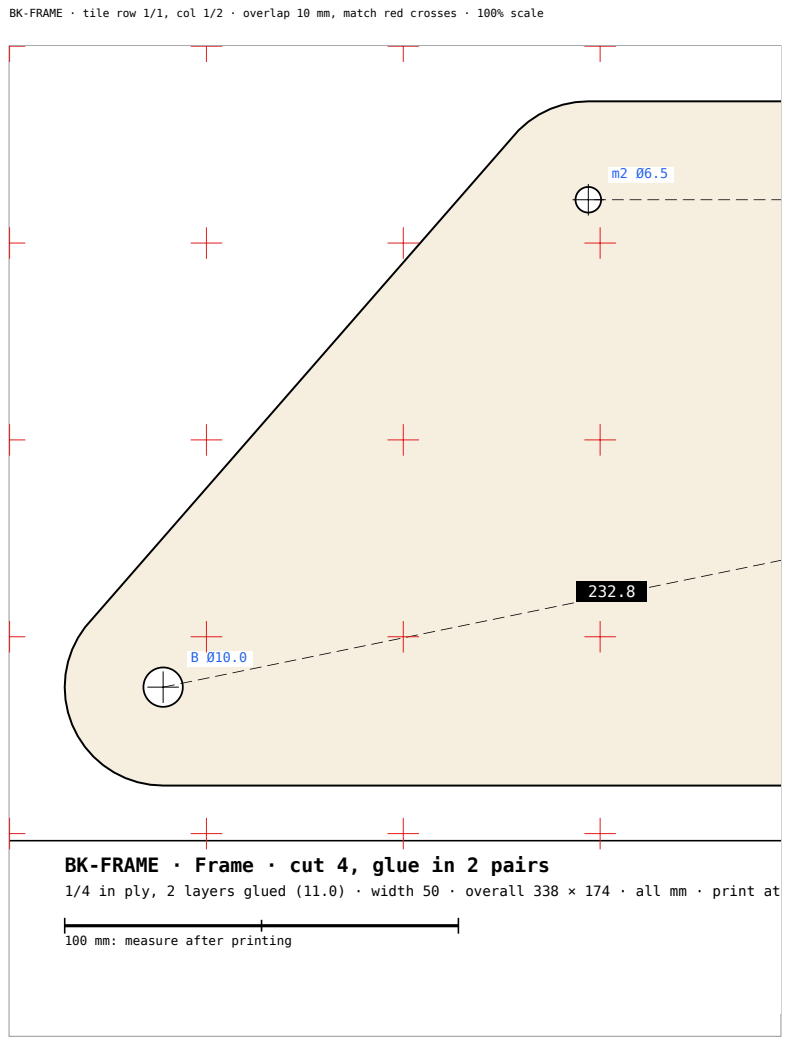
[picture p94: page 8]

BK-FRAME · tile row 1/1, col 1/2 · overlap 10 mm, match red crosses · 100% scale

BK-FRAME · Frame · cut 4, glue in 2 pairs
1/4 in ply, 2 layers glued (11.0) · width 50 · overall 338 × 174 · all mm · print at

100 mm: measure after printing

180.0

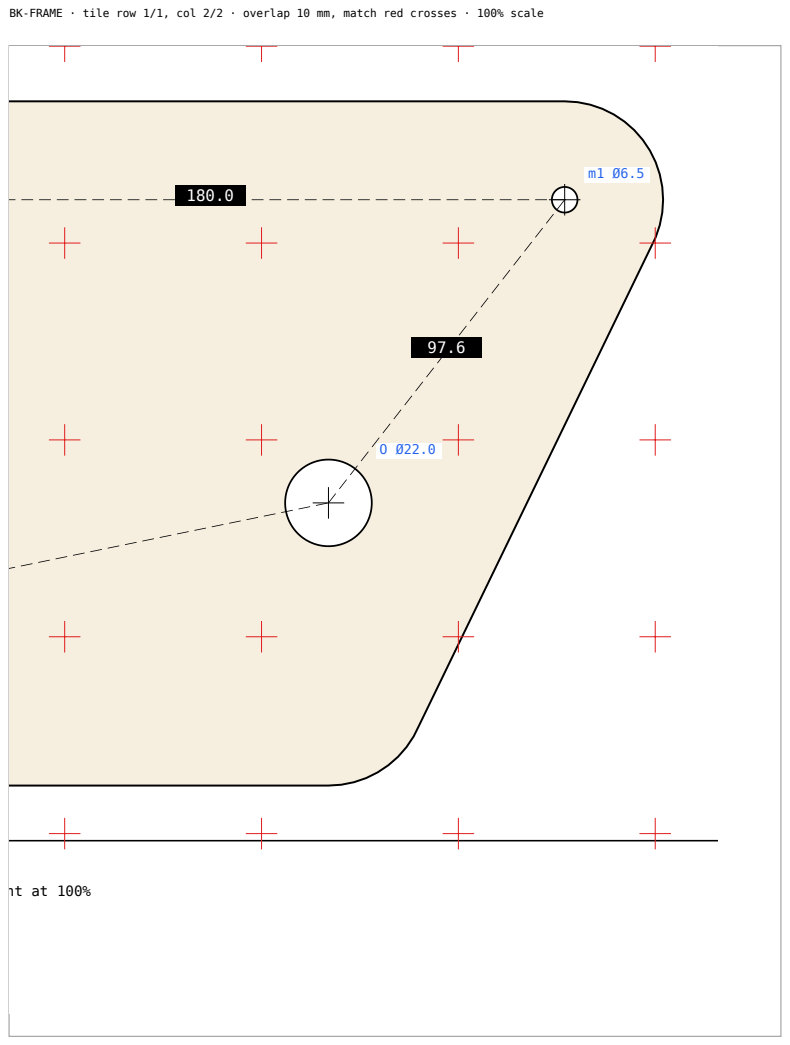
[picture p95: page 9]

BK-FRAME · tile row 1/1, col 2/2 · overlap 10 mm, match red crosses · 100% scale

BK-J · tile row 1/1, col 1/2 · overlap 10 mm, match red crosses · 100% scale

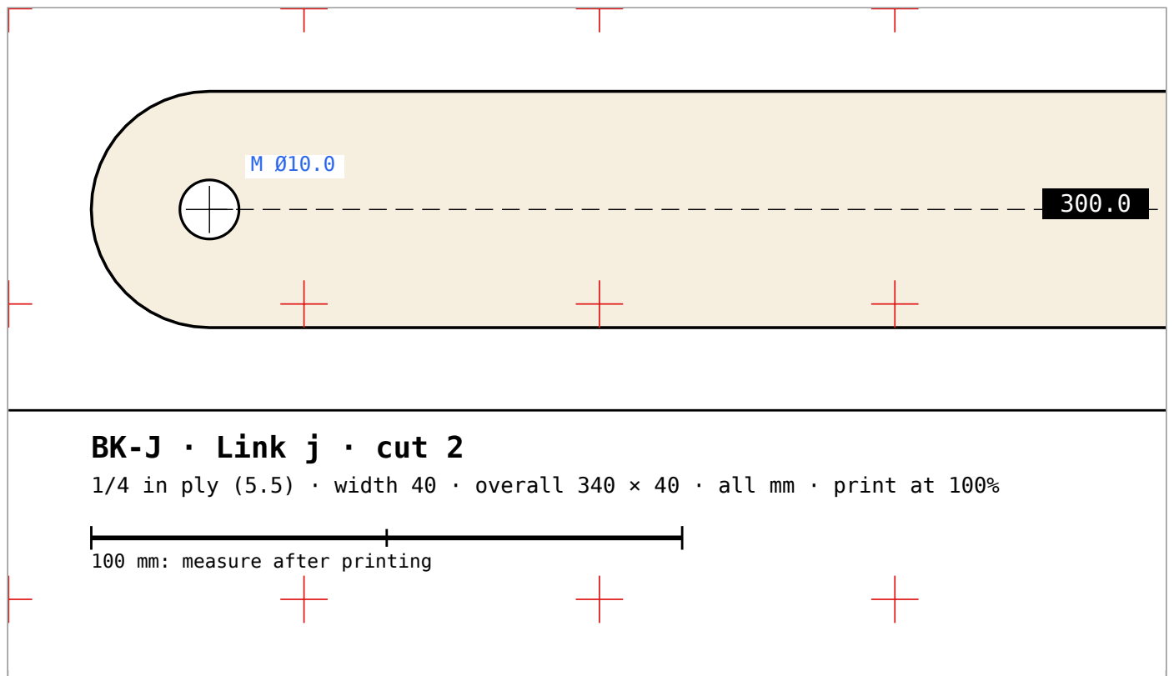
[picture p96: figure]
BK-J · Link j · cut 2; 100 mm: measure after printing

### 1/4 in ply (5.5) · width 40 · overall 340 × 40 · all mm · print at 100%

BK-J · tile row 1/1, col 2/2 · overlap 10 mm, match red crosses · 100% scale

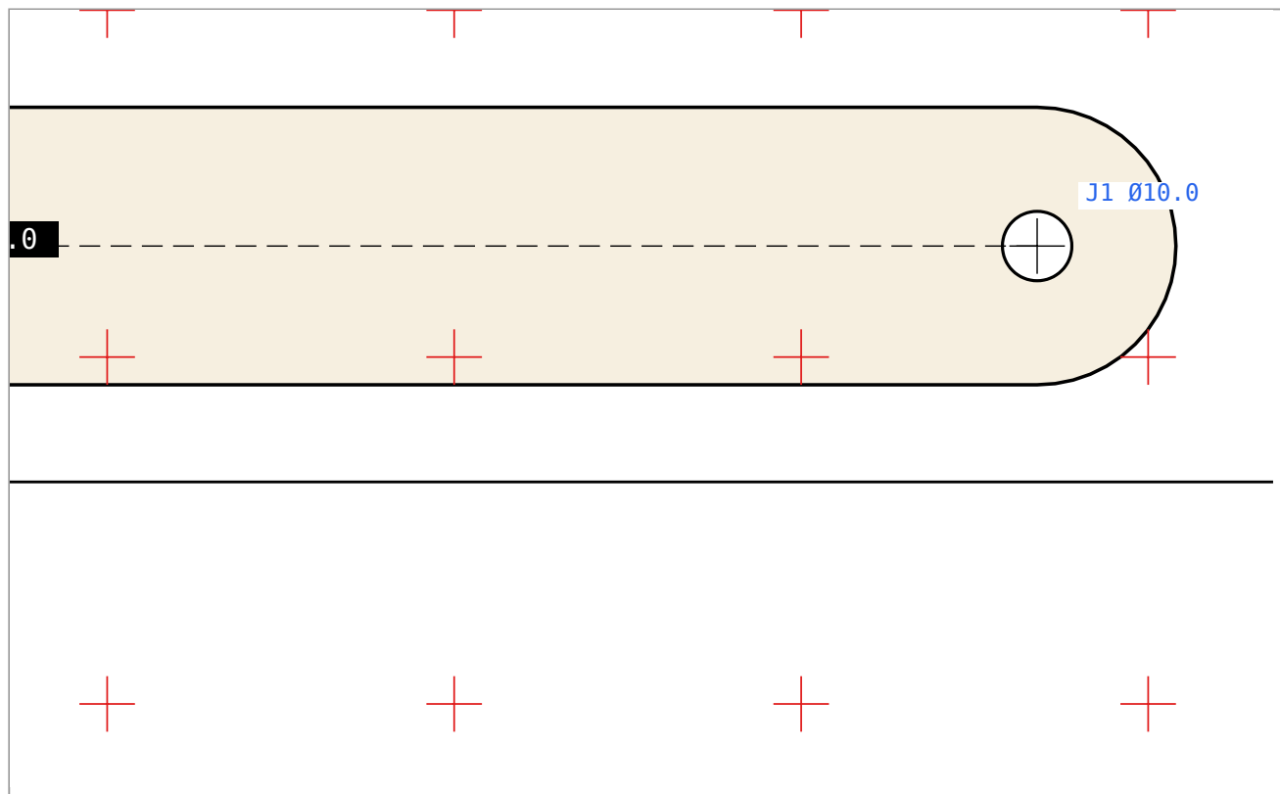
[picture p97: figure]

BK-K · tile row 1/1, col 1/3 · overlap 10 mm, match red crosses · 100% scale

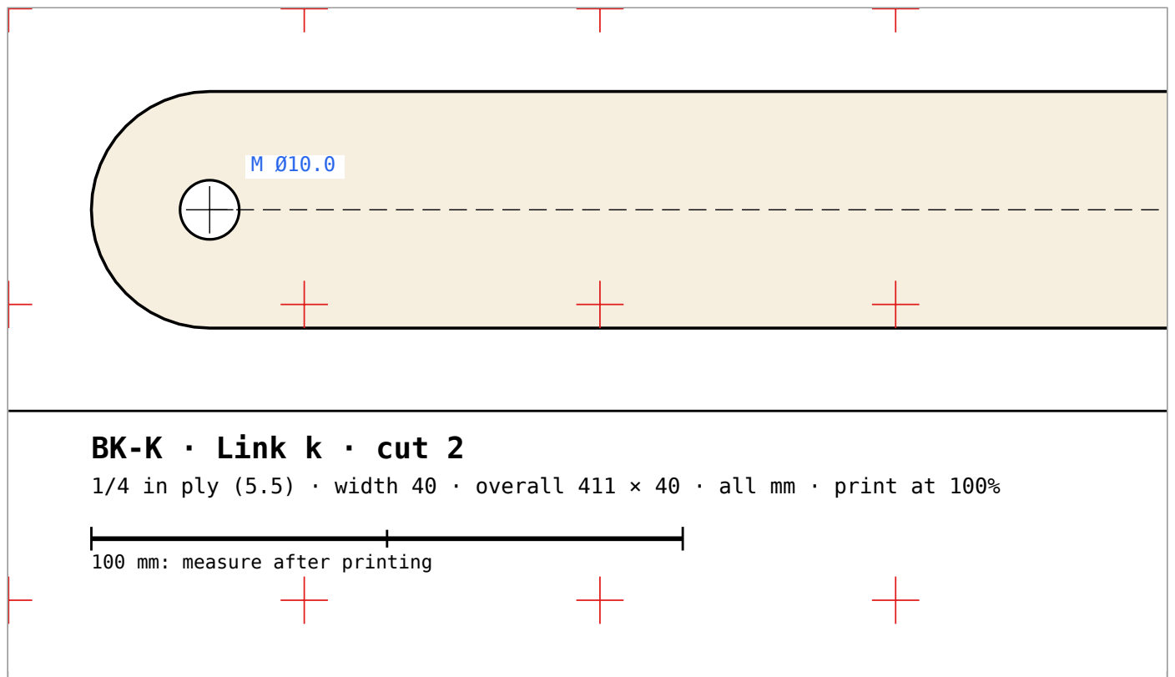
[picture p98: figure]
BK-K · Link k · cut 2; 100 mm: measure after printing

### 1/4 in ply (5.5) · width 40 · overall 411 × 40 · all mm · print at 100%

BK-K · tile row 1/1, col 3/3 · overlap 10 mm, match red crosses · 100% scale

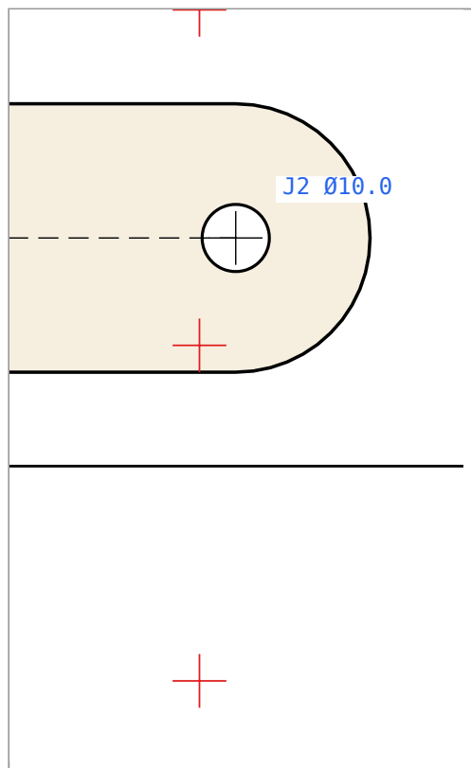
[picture p99: figure]

220.2

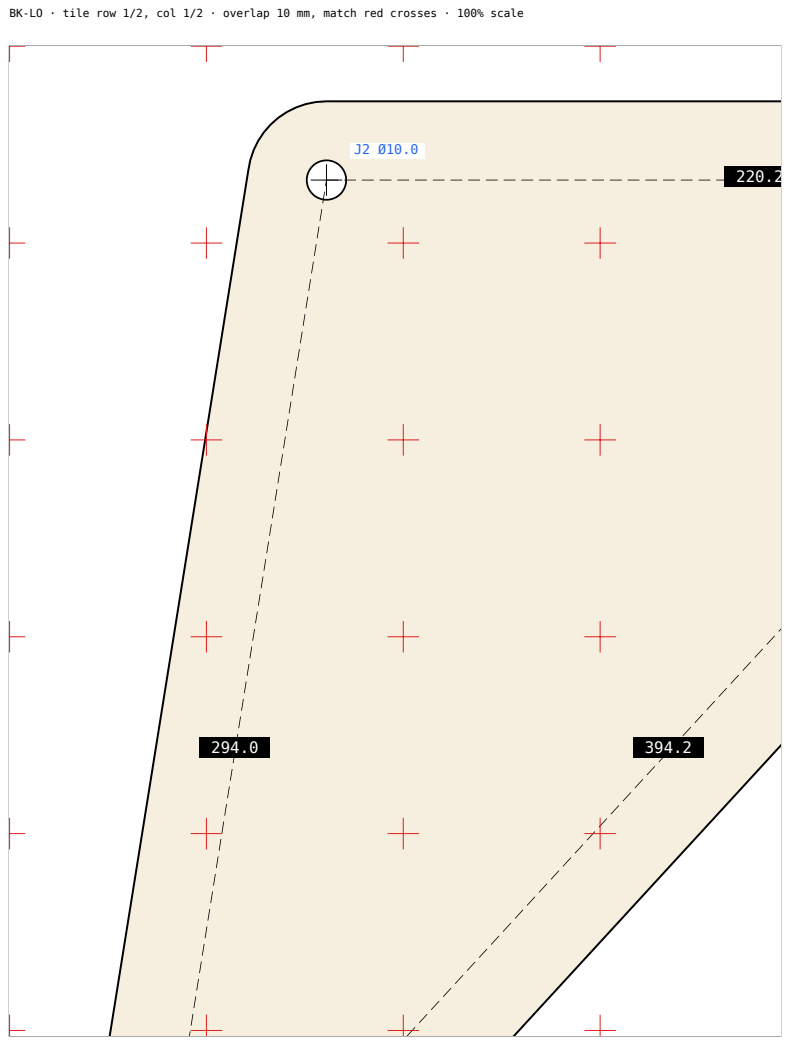
[picture p100: page 14]

BK-LO · tile row 1/2, col 1/2 · overlap 10 mm, match red crosses · 100% scale

220.2

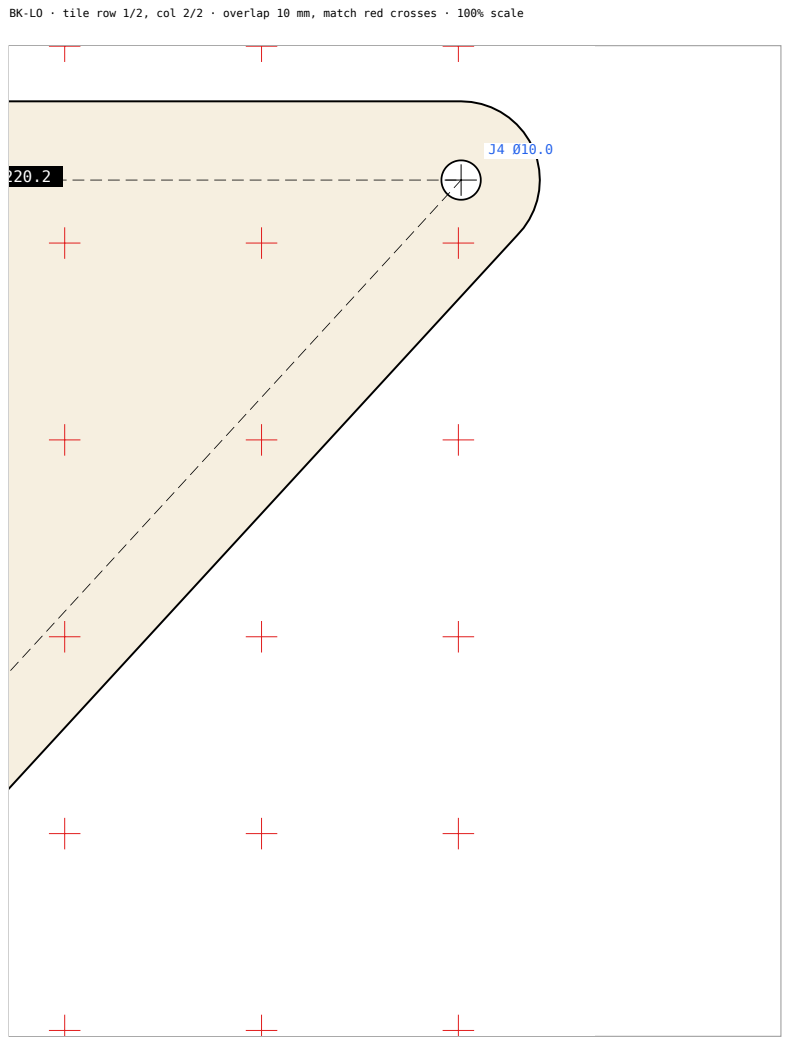
[picture p101: page 15]

BK-LO · tile row 1/2, col 2/2 · overlap 10 mm, match red crosses · 100% scale

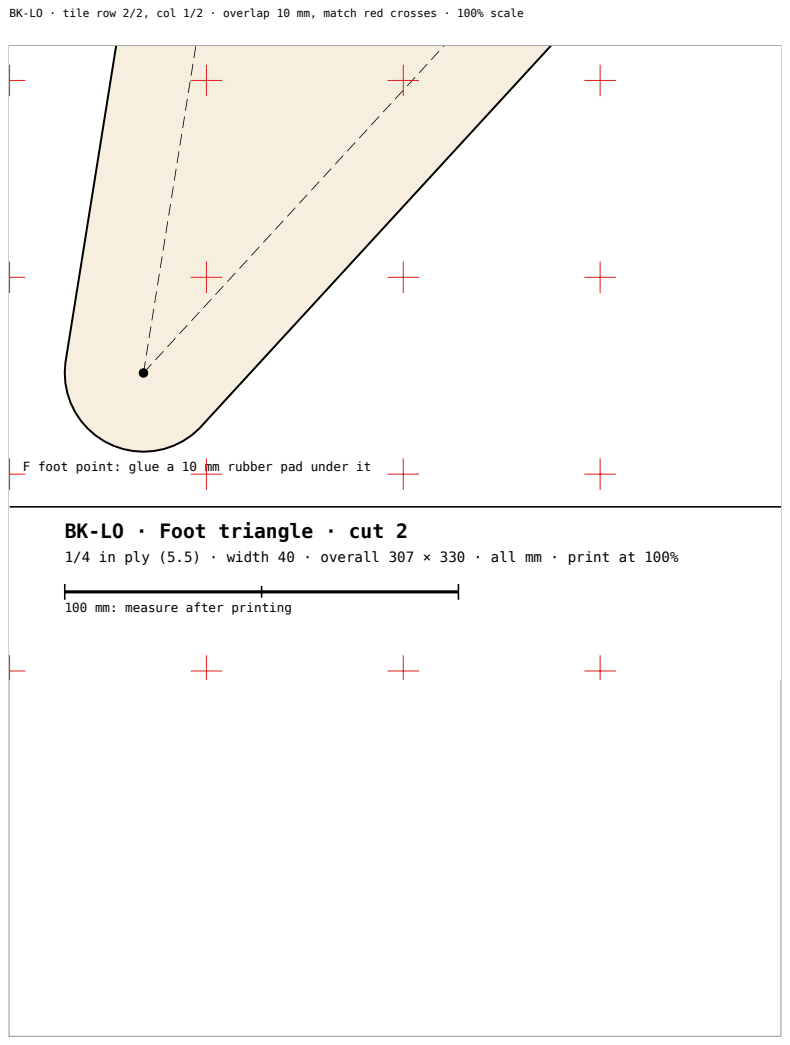
[picture p102: page 16]
F foot point: glue a 10 mm; rubber pad under it

BK-LO · tile row 2/2, col 1/2 · overlap 10 mm, match red crosses · 100% scale

BK-LO · Foot triangle · cut 2
1/4 in ply (5.5) · width 40 · overall 307 × 330 · all mm · print at 100%

100 mm: measure after printing

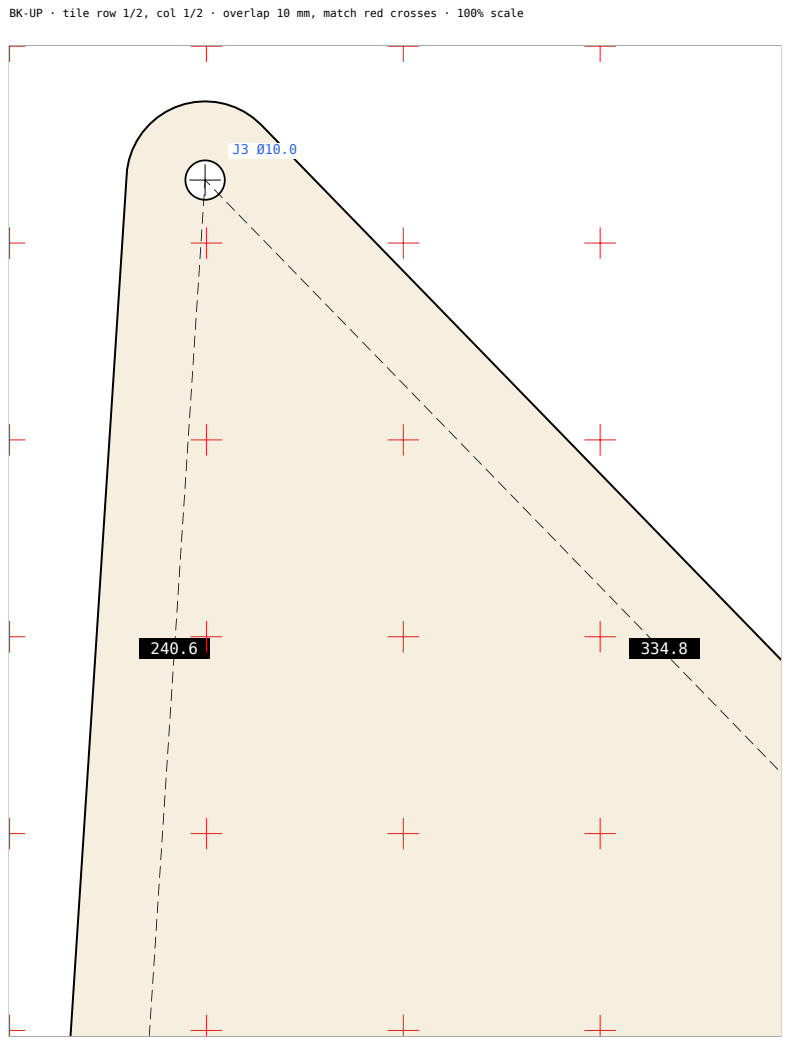
[picture p103: page 17]

BK-UP · tile row 1/2, col 1/2 · overlap 10 mm, match red crosses · 100% scale

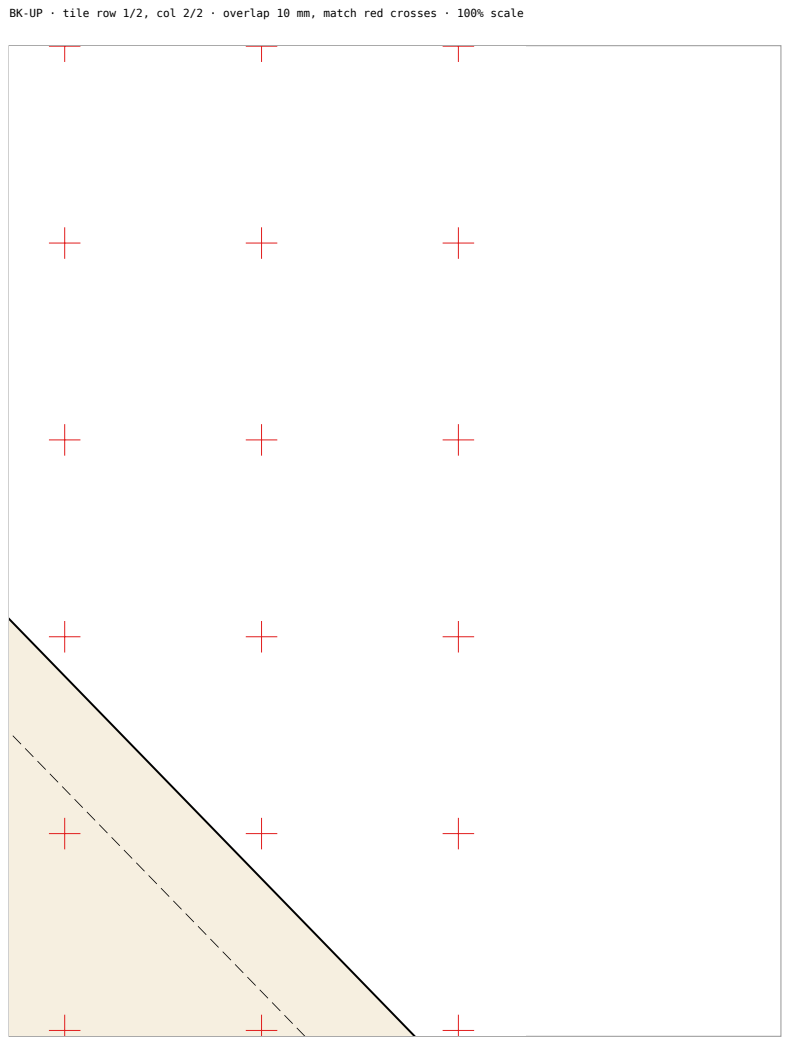
[picture p104: page 18]

BK-UP · tile row 1/2, col 2/2 · overlap 10 mm, match red crosses · 100% scale

249.0

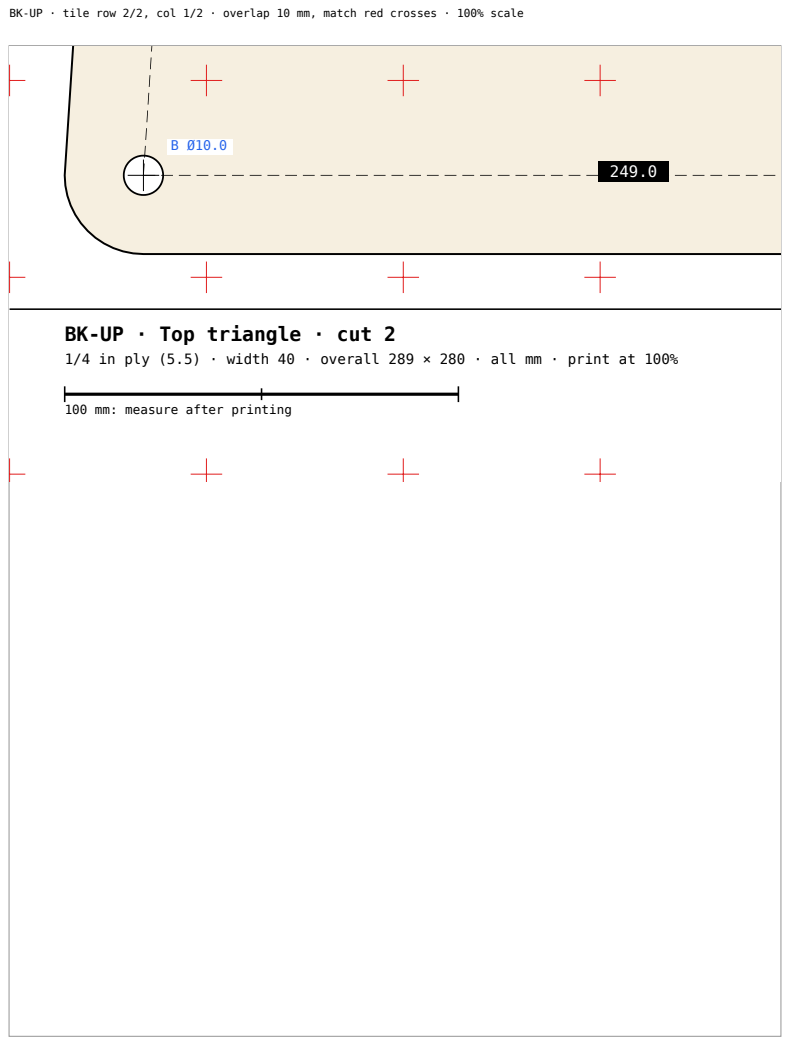
[picture p105: page 19]

BK-UP · tile row 2/2, col 1/2 · overlap 10 mm, match red crosses · 100% scale

BK-UP · Top triangle · cut 2
1/4 in ply (5.5) · width 40 · overall 289 × 280 · all mm · print at 100%

100 mm: measure after printing

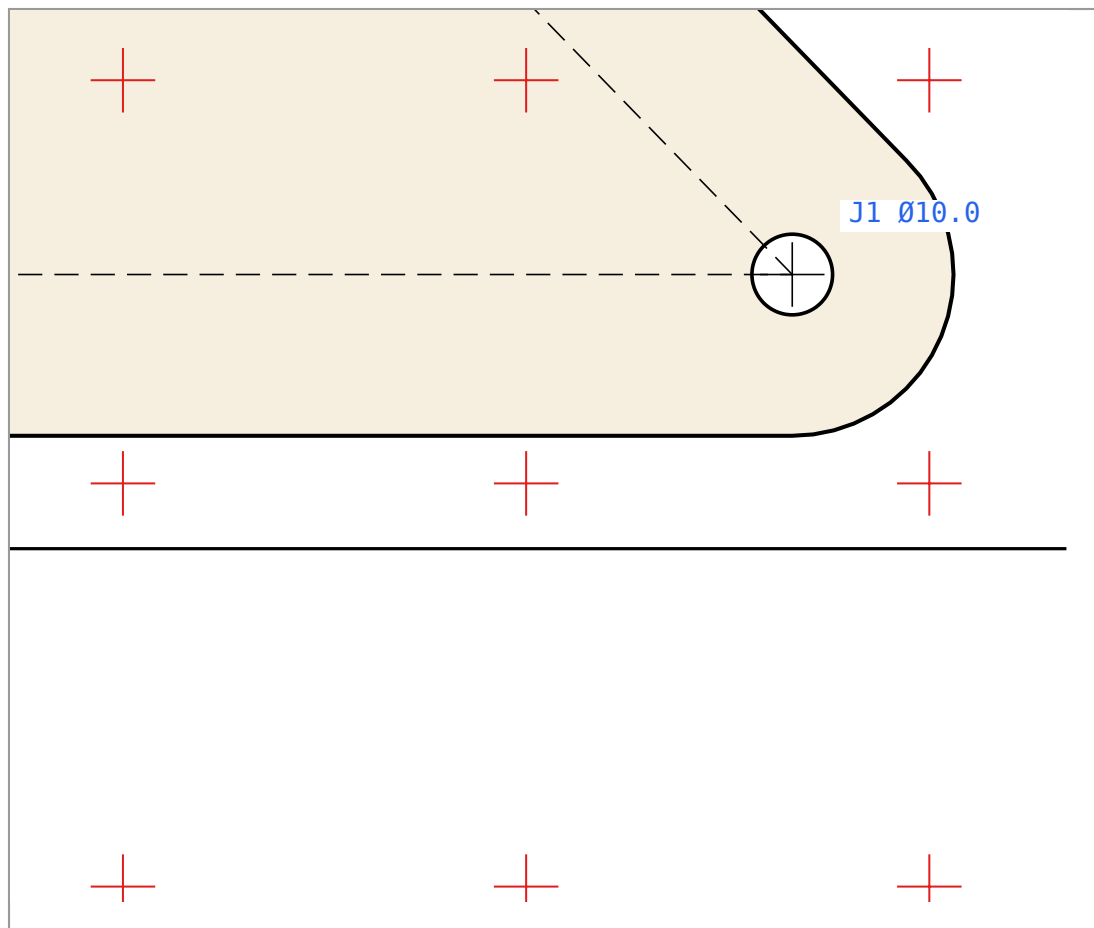
[picture p106: page 20]

BK-UP · tile row 2/2, col 2/2 · overlap 10 mm, match red crosses · 100% scale
