hartswf0/centaur-walker/rig/files/backpack/dxf/BP-CRANK.dxf

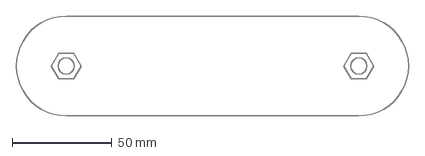
[picture p107: CAD file, 2026-10-23]
rig/files/backpack/dxf/BP-CRANK.dxf
196.8 x 50.0 mm
