hartswf0/centaur-walker/rig/files/bike/dxf/BK-BOX.dxf

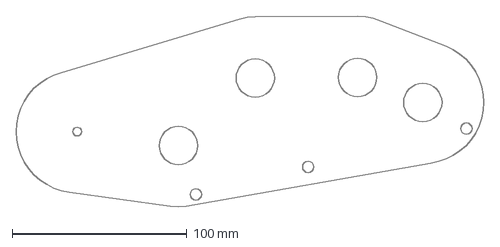
[picture p108: CAD file, 2026-10-23]
rig/files/bike/dxf/BK-BOX.dxf
268.0 x 109.0 mm
