hartswf0/centaur-walker/rig/files/backpack/dxf/BP-F.dxf

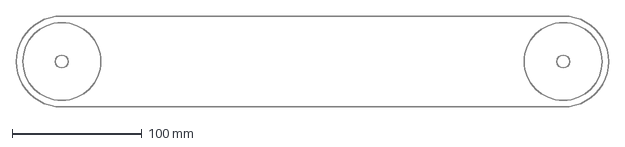
[picture p109: CAD file, 2026-10-23]
rig/files/backpack/dxf/BP-F.dxf
455.7 x 70.0 mm
