hartswf0/centaur-walker/rig/files/bike/dxf/BK-CRANK.dxf

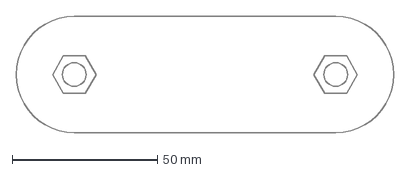
[picture p110: CAD file, 2026-10-23]
rig/files/bike/dxf/BK-CRANK.dxf
130.0 x 40.0 mm
