hartswf0/centaur-walker/rig/files/backpack/dxf/BP-CHEEK.dxf

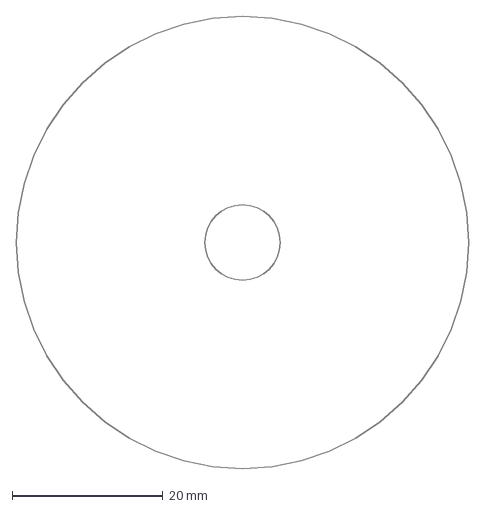
[picture p111: CAD file, 2026-10-23]
rig/files/backpack/dxf/BP-CHEEK.dxf
60.0 x 60.0 mm
