hartswf0/centaur-walker/rig/files/bike/dxf/BK-UP.dxf

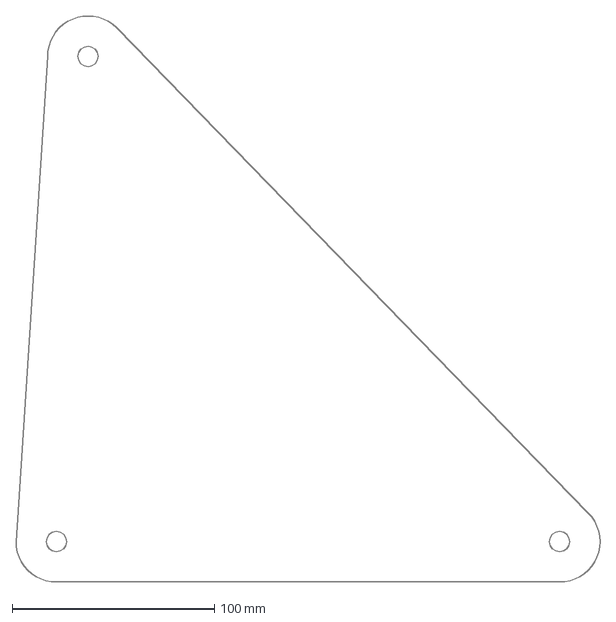
[picture p112: CAD file, 2026-10-23]
rig/files/bike/dxf/BK-UP.dxf
289.0 x 280.1 mm
