hartswf0/centaur-walker/rig/files/backpack/dxf/BP-J.dxf

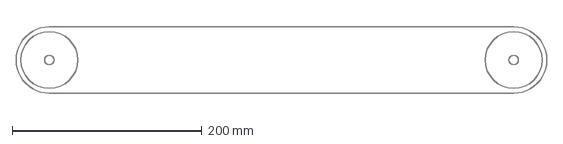
[picture p113: CAD file, 2026-10-23]
rig/files/backpack/dxf/BP-J.dxf
559.5 x 70.0 mm
