hartswf0/centaur-walker/rig/files/bike/dxf/BK-LO.dxf

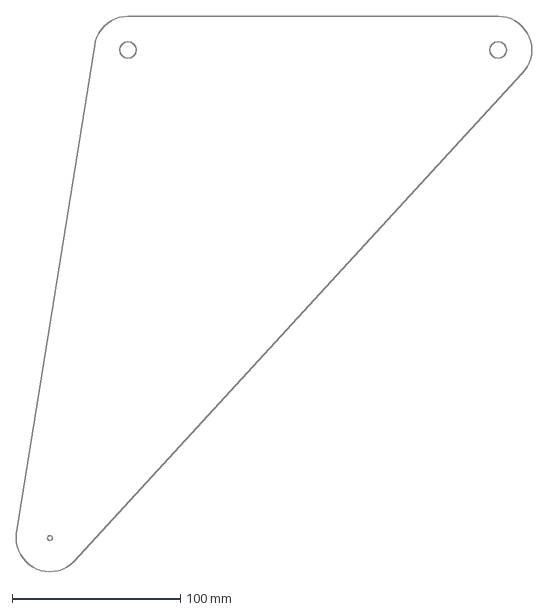
[picture p114: CAD file, 2026-10-23]
rig/files/bike/dxf/BK-LO.dxf
306.7 x 330.3 mm
