hartswf0/centaur-walker/rig/files/backpack/dxf/BP-FRAME.dxf

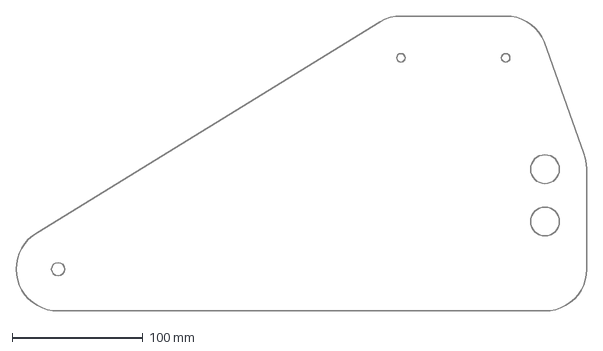
[picture p115: CAD file, 2026-10-23]
rig/files/backpack/dxf/BP-FRAME.dxf
436.0 x 225.4 mm
