hartswf0/centaur-walker/rig/files/bike/dxf/BK-C.dxf

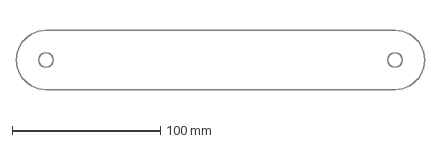
[picture p116: CAD file, 2026-10-23]
rig/files/bike/dxf/BK-C.dxf
275.8 x 40.0 mm
