hartswf0/centaur-walker/rig/files/backpack/dxf/BP-K.dxf

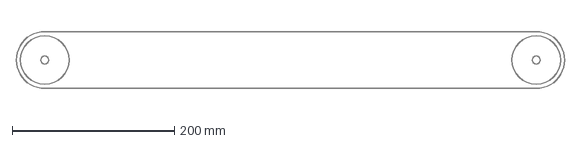
[picture p117: CAD file, 2026-10-23]
rig/files/backpack/dxf/BP-K.dxf
676.0 x 70.0 mm
