hartswf0/centaur-walker/rig/files/bike/dxf/BK-F.dxf

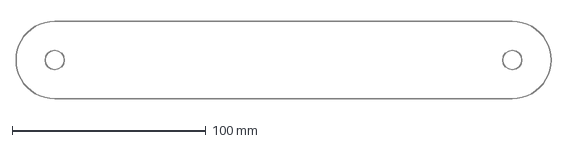
[picture p118: CAD file, 2026-10-23]
rig/files/bike/dxf/BK-F.dxf
276.4 x 40.0 mm
