hartswf0/centaur-walker/rig/files/backpack/dxf/BP-UP.dxf

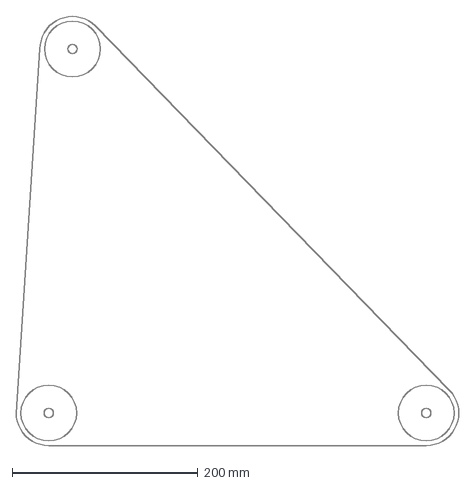
[picture p119: CAD file, 2026-10-23]
rig/files/backpack/dxf/BP-UP.dxf
476.3 x 461.7 mm
