hartswf0/centaur-walker/rig/files/bike/dxf/BK-J.dxf

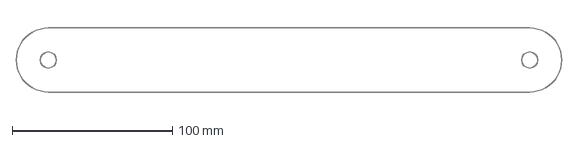
[picture p120: CAD file, 2026-10-23]
rig/files/bike/dxf/BK-J.dxf
340.0 x 40.0 mm
