hartswf0/centaur-walker/rig/files/backpack/dxf/BP-ARM.dxf

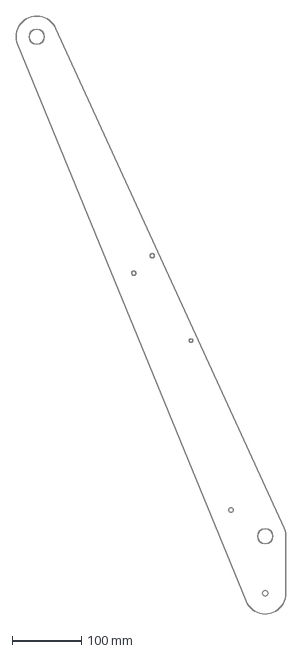
[picture p121: CAD file, 2026-10-23]
rig/files/backpack/dxf/BP-ARM.dxf
390.0 x 864.1 mm
