hartswf0/centaur-walker/rig/files/bike/dxf/BK-K.dxf

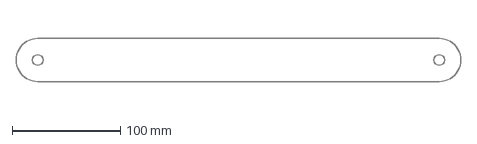
[picture p122: CAD file, 2026-10-23]
rig/files/bike/dxf/BK-K.dxf
411.4 x 40.0 mm
