hartswf0/centaur-walker/rig/files/backpack/dxf/BP-LO.dxf

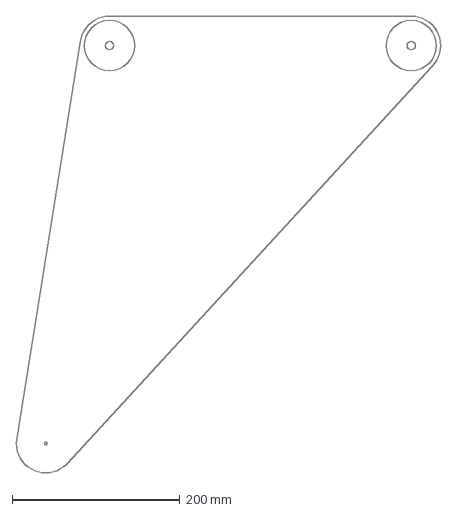
[picture p123: CAD file, 2026-10-23]
rig/files/backpack/dxf/BP-LO.dxf
505.1 x 543.7 mm
