hartswf0/centaur-walker/rig/files/bike/dxf/BK-FRAME.dxf

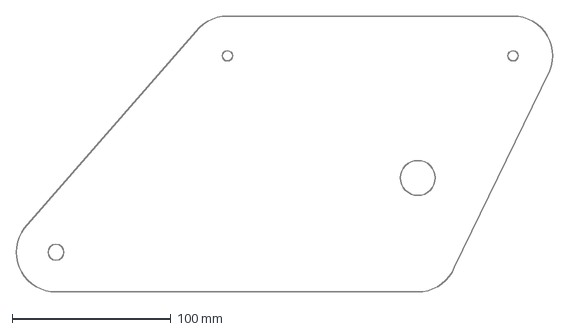
[picture p124: CAD file, 2026-10-23]
rig/files/bike/dxf/BK-FRAME.dxf
338.0 x 173.8 mm
