hartswf0/centaur-walker/rig/files/backpack/dxf/BP-C.dxf

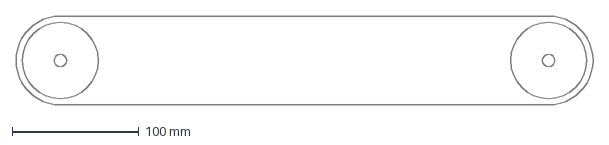
[picture p125: CAD file, 2026-10-23]
rig/files/backpack/dxf/BP-C.dxf
454.7 x 70.0 mm
