hartswf0/centaur-walker/rig/files/backpack/dxf/BP-TENSION.dxf

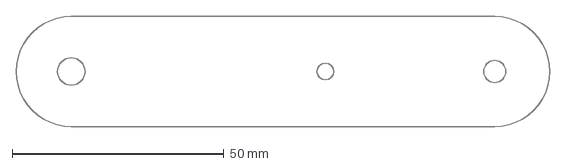
[picture p126: CAD file, 2026-10-23]
rig/files/backpack/dxf/BP-TENSION.dxf
126.0 x 26.0 mm
