hartswf0/centaur-walker/thumbs/20-build-book-v1.jpg

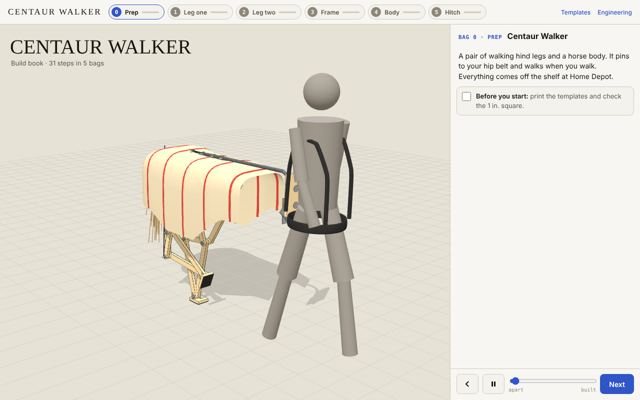
thumbs/20-build-book-v1.jpg
