hartswf0/centaur-walker/thumbs/27-build-shop-prompt.jpg

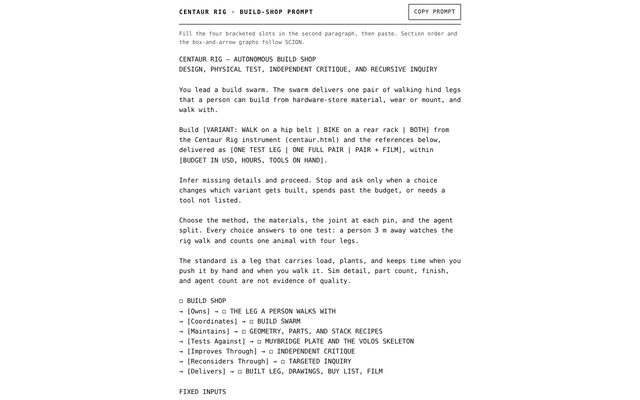
thumbs/27-build-shop-prompt.jpg
