hartswf0/centaur-walker/(commit log)

2026-10-23 Centaur Walker: build book, engineering page, templates, and every version
    - index.html: gallery of all pages with screenshots, current pages first
    - build-book.html: LEGO-style build book with Build, Mechanism and Exploded modes
    - walker.html: engineering instrument (computed tests, shop list, drive and traction)
    - templates.html / templates.pdf: full-size printable templates
    - versions/: 20 earlier versions in the order they were made
    - README.md, favicon.svg, .nojekyll
    Claude-Session: https://claude.ai/code/session_013kDQiT6nQaM5RtaXeWqpgu
2026-10-23 Add the Centaur Rig line: engine, design set, files, source and lineage
    - versions/21-27: Stride Plate, Centaur Rig v1-v5, build-shop prompt
    - rig/centaur-rig.html: the leg engine (walk and bike modes)
    - rig/design-set.html: Backpack and Bike build drawings
    - rig/files and the zip: 1:1 SVG and DXF parts, tiled Letter PDFs, design-data.json
    - rig/source: scripts that regenerate the files from the engine
    - rig/LINEAGE.md: each version, the request behind it, and the review rounds
    - index.html and README: new section and thumbnails
    Claude-Session: https://claude.ai/code/session_014sDRxQ3wf1hnoCiHrcCoXi
    [BK-BOX.dxf, BK-C.dxf, BK-CRANK.dxf, BK-F.dxf, BK-FRAME.dxf, BK-J.dxf, BK-K.dxf, BK-LO.dxf]
2026-10-29 Add powertrain page for the built velocipede drive
    Tyre -> red scooter wheels -> paint-roller cage -> threaded top axle, from
    the shop photos. Measured inputs give road per crank turn vs the legs'
    target, crank rpm, rotation direction, belt cut lengths, and a build guide
    for the top axle (jam pairs, collars, sleeves) so it stops unscrewing.
    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
2026-10-29 Add as-built powertrain bench with belt geometry and shaft repair options
2026-10-29 Link the as-built powertrain bench from Current
2026-10-29 Add Rig 3D: the built velocipede modelled from measurements
    3D model of the rig as built (deck, red wheels, roller cage, A-frame,
    options, hoof clearance, rod twist check, and the drive count check.
    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
2026-10-29 Rig 3D v2: real parts, the coroplast leg, and the axle fix
    Razor A deck and 95 mm wheels, Simpson LSTA9/LSTA12 straps with their
    holes, 9 in. roller frame and bungees, #8-32 rod as built vs a 5/16-18
    rod on bearing blocks and a plywood side plate that also holds pivot B.
    The leg uses the velocipede lengths with two coroplast plates and pine
    1x2 bars. Parts list highlights each part; measuring tasks update it.
    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
2026-10-29 Add physical 3D assembly with Razor parts, shaft supports and leg joint details
2026-10-29 Link detailed physical assembly from Current
2026-10-29 Connect powertrain calculator to detailed physical assembly
2026-10-29 Drive module v3: lift-off module, cheeks and platform, lid pulley, both legs, build steps and collision checks
    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
2026-10-29 Model asymmetric shaft and lower roller straps; expose clearance candidates without fabricated supports
2026-10-29 Add interactive threaded axle lab with cutaway, torque-path faults and relative nut travel
2026-10-29 Link threaded axle thinking lab
2026-10-29 Link assembly model to axle lab
2026-10-29 Clarify single restrained nut in screw-motion demonstration
2026-10-29 Drive module v4: photo measurements, drive forces view, swing-arm red wheels, cage axle, lid ratio, frame options, failure checks
    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
2026-10-29 Unify assembly, threaded axle behavior, belt ratios and reference leg in a linked workbench
2026-10-29 Verify shared belt dimensions and reverse roller direction at tire contact
2026-10-29 Belt lab: as-built cord paths, grip and tension along each wrap, slip test
    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
2026-10-30 Belt lab in 3D; archive Rig 3D v1-v2, drive module v3 and 2D belt lab as versions 33-36; cross-link
    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
2026-10-30 Belt lab: cord choice, cut lengths, routing and joining steps with 3D close-ups
    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
2026-10-30 Whole picture: bike, drive and both legs in one 3D model with the seven-link power chain and switchable fixes
    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
2026-10-30 One workbench: index.html opens every working page in tabs (Whole picture, Belts, Top axle v32, Redesign, Powertrain, v14 leg, Build book, Templates); shared as-built state; old index kept as archive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
2026-10-30 Velocipede: the original v14 page with an As built mode (real drive on the same bike driving the same legs); workbench opens on it
    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
2026-10-30 Velocipede As built: drive buttons now move the 3D view
    Tapping a link flies the camera to that part and pulses it; tapping a fix
    flies to the part it changes. The camera is kept across rebuilds (it used to
    snap back to the overview on every fix). Fixes sit as a two-column grid right
    under the chain so they are on screen on a phone. One delegated listener per
    panel. Legs fade while a drive part is framed. Test tab no longer swaps the
    3D for the leg test bench in As built.
    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
